vitormhenrique/hexapod/firmware/openrb150/README.md

# OpenRB-150 Hexapod Firmware

Deterministic safety + motion controller for the hexapod, running on a ROBOTIS
**OpenRB-150** (Microchip SAMD21G18A, Cortex-M0+ @ 48 MHz, 256 KB flash,
32 KB SRAM). Built with **PlatformIO**.

> Before touching DYNAMIXEL / Serial3 / DXL-power code, read
> [doc/mkrzero-vs-openrb150.md](doc/mkrzero-vs-openrb150.md). This repo ships a
> custom OpenRB-150 board + variant so peripheral pins map to the real hardware.

## Build environments

| Env | Board | Use |
| --- | --- | --- |
| `openrb150` (default) | custom `boards/openrb150.json` + `variants/OpenRB-150` | **All real firmware work.** Correct pin map: `Serial1`=DXL bus, `Serial3`=CRSF on D14 TX / D13 RX, DXL power FET, LEDs, battery ADC. |
| `openrb150_hil_output_disabled` | custom `boards/openrb150.json` + `variants/OpenRB-150` | Explicit ATSAMD21 HIL image. It runs the normal tasks but compile-time guards block DXL power-on, torque-on, Sync Write goals, and raw DXL writes. `GET_CAPABILITIES`, `GET_STATUS`, `health`, and `hil_status` expose the guard state. Never use it for actuator tests. |
| `mkrzero` | stock MKR Zero | Toolchain-only fallback. WRONG serial / DXL-power pins. |
| `native` | host (no board) | **Host unit tests only.** Builds the portable `src/` logic (protocol, IK, gait, config, safety) against Unity on the host; run with `pio test -e native`. |

## Commands

```bash
# Build (default env = openrb150)
pio run

# Local check: compile both target envs to confirm toolchain + variant are healthy
pio run -e openrb150 -e mkrzero

# Build the immutable output-disabled HIL image (do not use for motion tests)
pio run -e openrb150_hil_output_disabled

# Flash it, then run the board-side output guard smoke sequence from companion/
pio run -e openrb150_hil_output_disabled -t upload
cd ../../companion && uv run python ../tools/hil_smoke.py --port <PORT> --hil-output-disabled

# Run host unit tests (Unity, no hardware)
pio test -e native

# Flash the OpenRB-150 over USB
pio run -e openrb150 -t upload

# Serial monitor (USB CDC, 115200)
pio device monitor -b 115200
```

If `pio` is not on PATH, use the bundled binary: `~/.platformio/penv/bin/pio`.

### Portable CMake target

The firmware directory also exports `hexapod::controller_portable`, a
host-only static library for the Arduino-free controller, gait, IK, config,
protocol, contact, and safety layers. It is intended for native regression
tests and future ROS 2 packages; it does not build `main.cpp`, FreeRTOS task
orchestration, DXL bus I/O, the physical I2C drivers, or board GPIO.

From `firmware/openrb150`, configure, build, and run the standalone smoke test
with any host CMake 3.16+ toolchain:

```bash
cmake -S . -B build/portable -G Ninja
cmake --build build/portable
ctest --test-dir build/portable --output-on-failure
```

On this repository's RoboStack workstation setup, use the project-local Pixi
toolchain instead of installing CMake globally:

```bash
pixi run -e jazzy --manifest-path ../../robot_ros_simulation/pixi.toml \
  cmake -S . -B build/portable -G Ninja
pixi run -e jazzy --manifest-path ../../robot_ros_simulation/pixi.toml \
  cmake --build build/portable
pixi run -e jazzy --manifest-path ../../robot_ros_simulation/pixi.toml \
  ctest --test-dir build/portable --output-on-failure
```

The CMake and PlatformIO-native builds use the same policy: compile all files
under `src/` except the explicit hardware-owned entry, RTOS, board, DXL, I2C,
and OpenLog/OLED adapters. A portable source that starts depending on Arduino or
other hardware libraries should fail host compilation rather than being
silently omitted.

### Upload troubleshooting

- If upload does not catch the port, **double-tap the RESET button** to force the
  SAMD21 bootloader, then re-run upload.
- Resetting the MCU momentarily cuts DXL power — only reset when actuators are in
  a mechanically safe position.

## Safety-first boot behavior

- The DYNAMIXEL power FET (`BDPIN_DXL_PWR_EN`, pin 31) is held **OFF at boot**.
  Servos are unpowered until firmware explicitly arms them.
- Logic is 3.3 V and **not 5 V tolerant**. Do not run servos from USB power.
- If Qwiic OpenLog and its SD card are ready but `CONFIG.TXT` is absent or
  empty, firmware writes and verifies the complete compiled default config as
  the first journal record. A non-empty invalid prefix is not overwritten;
  firmware appends and verifies a complete default recovery record after it.

### Default stand pose

With the default (zero-trim) calibration, a planted stand commands every servo
to the MX-28 centre (`2048` / 180 deg). The mechanical build is designed so
that all-centre IS the home pose: coxa at the middle, femur slightly up, tibia
perpendicular to the floor. A walking gait selected with centred gimbals holds
this same planted pose; it does not advance gait phase or lift feet. Per-servo
`trim_ticks` are reserved for measured hardware calibration deltas only --
never for posing.

The final part of swing places the foot horizontally first and then descends
vertically with zero touchdown velocity. Tibia pitch is not independently
controllable because the 3-DOF leg uses coxa yaw plus a two-link point-foot IK;
the calibrated home geometry supplies the near-perpendicular contact posture.

## Layout

```text
firmware/openrb150/
  platformio.ini            PlatformIO config (openrb150 + mkrzero + native envs)
  boards/openrb150.json     custom board definition
  variants/OpenRB-150/      exact OpenRB-150 pin map + linker scripts
  doc/                      board notes (read mkrzero-vs-openrb150.md)
  src/
    main.cpp                entry point: board init + RTOS task launch
    app/                    FreeRTOS task setup + scheduling (control/dxl/rc/api/i2c/health)
    board/                  board pin map + HAL, safe boot, battery ADC scaling
    config/                 Qwiic OpenLog driver, append config journal, schema, config API
    dxl/                    DYNAMIXEL bus, model/table detection, sync write, params, servo map
    gait/                   leg IK, body IK, gait engine, full gait pipeline
    input/                  CRSF (ExpressLRS) parser + channel normalization
    protocol/               USB API: COBS/CRC framing, frame reader, dispatch, per-group handlers, telemetry
    logging/                portable remote/DYNAMIXEL capture CSV formatting
    safety/                 safety state machine, watchdog, command arbiter, system state
    sensors/                I2C topology, mux/contact sensors, optional debug OLED
  test/                     host Unity unit tests (one dir per module, built by the `native` env)
```

The 1.3 inch OLED driver is SparkFun's official `Qwiic1in3OLED`, pinned to
SparkFun_Qwiic_OLED_Arduino_Library `v1.0.13`. Later releases currently compile
an unrelated CH1120 debug path that uses `Serial.printf`, which is unavailable
in the OpenRB SAMD21 core. Two detailed pages use the bundled 5x7 font and
rotate every 10 seconds to show complete health, motion, tuning, and capture
status; only one dirty text row is sent per `i2cTask` pass.

## Intentionally not implemented (`#NOTIMPLEMENTED`)

These enhancements were raised by the 2026-06-29 Phase 1/2 audit
([docs/firmware_phase2_beads_audit_2026-06-29.md](../../docs/firmware_phase2_beads_audit_2026-06-29.md))
but are deliberately **not** on the backlog. They are micro-optimizations or
cleanups that are not required for a safe, working robot at this stage. Revisit
only if a profiler or hardware-in-loop run proves a concrete need.

- `#NOTIMPLEMENTED` **Precomputed servo lookup tables** (audit 22l.3). `ServoMap::servoFor()`/
  `servoForId()` linearly scan all servos. With only 18 servos the scan cost is
  negligible; a cached slot/id map adds state to maintain for no measurable gain.
- `#NOTIMPLEMENTED` **Coherent-snapshot / sequence guards on multi-field telemetry** (audit 22l.9).
  `buildTelemetry()` reads `g_servoStatus` while `dxlTask` writes it. A torn record
  is cosmetic for bring-up telemetry. Add a copy/sequence guard only if an HIL run
  shows visibly torn snapshots.
- `#NOTIMPLEMENTED` **Consolidate/remove the unused `CommandArbiter` Mac-lock path** (audit 22l.8).
  `MaintenanceApi` is the single source of truth for the maintenance lock; the
  dormant `CommandArbiter` Mac-lock methods are harmless dead code. Leave them
  until a broader arbiter refactor, rather than churning safety code for cleanup.

> Bench / hardware-in-loop sign-off (audit 22l.11) is tracked separately and is
> **deferred, not rejected** — it is pending hardware, not a non-goal.

See the repo-root `AGENTS.md` for the full architecture, safety rules, and phase
plan. Work is tracked in Beads (`bd ready`), not markdown TODOs.
