vitormhenrique/hexapod/robot_ros_simulation/debug/extraction_report.md

# Extraction Report: HexNav

**Exported:** 2026-06-24T12:20:51.967726
**Exporter:** v3.0.0

## Summary

| Metric | Value |
|---|---|
| Occurrences | 38 |
| Subassemblies | 0 |
| Leaf components | 38 |
| Joints (total) | 37 |
| As-built joints | 0 |
| Regular joints | 37 |
| Max nesting depth | 0 |

## Assembly Hierarchy

```
[HexNav]  (design root)
  ├── bot  (241.3g)
  ├── leg_1_coxa  (193.0g)
  ├── leg_1_femur  (127.0g)
  ├── leg_1_mx28_coxa  (73.9g)
  ├── leg_1_mx28_femur  (73.9g)
  ├── leg_1_mx28_tibia  (73.9g)
  ├── leg_1_tibia  (155.0g)
  ├── leg_2_coxa  (193.0g)
  ├── leg_2_femur  (127.0g)
  ├── leg_2_mx28_coxa  (73.9g)
  ├── leg_2_mx28_femur  (73.9g)
  ├── leg_2_mx28_tibia  (73.9g)
  ├── leg_2_tibia  (155.0g)
  ├── leg_3_coxa  (193.0g)
  ├── leg_3_femur  (127.0g)
  ├── leg_3_mx28_coxa  (73.9g)
  ├── leg_3_mx28_femur  (73.9g)
  ├── leg_3_mx28_tibia  (73.9g)
  ├── leg_3_tibia  (155.0g)
  ├── leg_4_coxa  (193.0g)
  ├── leg_4_femur  (127.0g)
  ├── leg_4_mx28_coxa  (73.9g)
  ├── leg_4_mx28_femur  (73.9g)
  ├── leg_4_mx28_tibia  (73.9g)
  ├── leg_4_tibia  (155.0g)
  ├── leg_5_coxa  (193.0g)
  ├── leg_5_femur  (127.0g)
  ├── leg_5_mx28_coxa  (73.9g)
  ├── leg_5_mx28_femur  (73.9g)
  ├── leg_5_mx28_tibia  (73.9g)
  ├── leg_5_tibia  (155.0g)
  ├── leg_6_coxa  (193.0g)
  ├── leg_6_femur  (127.0g)
  ├── leg_6_mx28_coxa  (73.9g)
  ├── leg_6_mx28_femur  (73.9g)
  ├── leg_6_mx28_tibia  (73.9g)
  ├── leg_6_tibia  (155.0g)
  ├── top  (241.3g)
```

## Occurrences

### Depth 0

#### 🔧 COMPONENT: `bot`

| Property | Value |
|---|---|
| Full path | `bot:1` |
| Component name | bot |
| Depth | 0 |
| Path segments | bot |
| **Transforms** | |
| Global position (m) | (0.076463, -0.126463, -0.033000) |
| Global position (mm) | (76.46, -126.46, -33.00) |
| Local transform (m) | (0.076463, -0.126463, -0.033000) |
| Assembly context depth | 0 |
| transform2 (m) | (0.076463, -0.126463, -0.033000) |
| **Physical** | |
| Mass | 0.241313 kg (241.313 g) |
| Volume | 3.074045e-05 m³ |
| Density | 7850.0 kg/m³ |
| Surface area | 2.989702e-02 m² |
| Body count | 1 |
| CoM (component-local, m) | (0.076463, 0.126463, 0.001407) |
| CoM (global, m) | (0.152927, 0.000000, -0.031593) |
| CoM (global, mm) | (152.93, 0.00, -31.59) |
| **Inertia at origin (kg·m²)** | |
| Ixx, Iyy, Izz | 5.117542e-03, 1.803530e-03, 6.919758e-03 |
| Ixy, Ixz, Iyz | -2.333454e-03, -2.596731e-05, -4.294751e-05 |
| **Inertia at CoM (kg·m²)** | |
| Ixx, Iyy, Izz | 1.257749e-03, 3.921782e-04, 1.649569e-03 |
| Ixy, Ixz, Iyz | -1.134942e-10, 4.004551e-12, 6.945432e-12 |
| Bounding box (m) | 0.1529 × 0.2529 × 0.0030 |
| Bounding box (mm) | 152.91 × 252.91 × 3.00 |
| **Material & Appearance** | |
| Material | Steel |
| Appearance | Steel_Satin |
| Color (RGB 0-1) | (0.627, 0.627, 0.627) |
| Color (RGB 0-255) | (160, 160, 160) |

#### 🔧 COMPONENT: `leg_1_coxa`

| Property | Value |
|---|---|
| Full path | `leg_1_coxa:1` |
| Component name | leg_1_coxa |
| Depth | 0 |
| Path segments | leg_1_coxa |
| **Transforms** | |
| Global position (m) | (-0.102347, -0.152347, -0.018000) |
| Global position (mm) | (-102.35, -152.35, -18.00) |
| Local transform (m) | (-0.102347, -0.152347, -0.018000) |
| Assembly context depth | 0 |
| transform2 (m) | (-0.102347, -0.152347, -0.018000) |
| **Physical** | |
| Mass | 0.192968 kg (192.968 g) |
| Volume | 2.458186e-05 m³ |
| Density | 7850.0 kg/m³ |
| Surface area | 1.384356e-02 m² |
| Body count | 1 |
| CoM (component-local, m) | (-0.026008, 0.000000, -0.000000) |
| CoM (global, m) | (-0.128355, -0.152346, -0.018000) |
| CoM (global, mm) | (-128.35, -152.35, -18.00) |
| **Inertia at origin (kg·m²)** | |
| Ixx, Iyy, Izz | 8.738331e-05, 2.179312e-04, 2.203039e-04 |
| Ixy, Ixz, Iyz | 1.133249e-09, -1.180732e-09, 1.075058e-10 |
| **Inertia at CoM (kg·m²)** | |
| Ixx, Iyy, Izz | 8.738331e-05, 8.740064e-05, 8.977332e-05 |
| Ixy, Ixz, Iyz | 2.081866e-10, -4.006872e-10, 1.075002e-10 |
| Bounding box (m) | 0.0790 × 0.0480 × 0.0480 |
| Bounding box (mm) | 79.00 × 48.00 × 48.00 |
| **Material & Appearance** | |
| Material | Steel |
| Appearance | Opaque_255_255_255 |
| Color (RGB 0-1) | (1.000, 1.000, 1.000) |
| Color (RGB 0-255) | (255, 255, 255) |

#### 🔧 COMPONENT: `leg_1_femur`

| Property | Value |
|---|---|
| Full path | `leg_1_femur:1` |
| Component name | leg_1_femur |
| Depth | 0 |
| Path segments | leg_1_femur |
| **Transforms** | |
| Global position (m) | (-0.127661, -0.177661, -0.018000) |
| Global position (mm) | (-127.66, -177.66, -18.00) |
| Local transform (m) | (-0.127661, -0.177661, -0.018000) |
| Assembly context depth | 0 |
| transform2 (m) | (-0.127661, -0.177661, -0.018000) |
| **Physical** | |
| Mass | 0.127034 kg (127.034 g) |
| Volume | 1.618264e-05 m³ |
| Density | 7850.0 kg/m³ |
| Surface area | 9.524369e-03 m² |
| Body count | 1 |
| CoM (component-local, m) | (0.002213, 0.011329, -0.000000) |
| CoM (global, m) | (-0.125448, -0.166332, -0.018000) |
| CoM (global, mm) | (-125.45, -166.33, -18.00) |
| **Inertia at origin (kg·m²)** | |
| Ixx, Iyy, Izz | 6.551941e-05, 5.196798e-05, 4.448854e-05 |
| Ixy, Ixz, Iyz | -8.253525e-06, 6.684992e-12, -3.715345e-11 |
| **Inertia at CoM (kg·m²)** | |
| Ixx, Iyy, Izz | 4.921450e-05, 5.134561e-05, 2.756126e-05 |
| Ixy, Ixz, Iyz | -5.067980e-06, -4.447828e-11, -2.990278e-10 |
| Bounding box (m) | 0.0448 × 0.0463 × 0.0480 |
| Bounding box (mm) | 44.80 × 46.30 × 48.00 |
| **Material & Appearance** | |
| Material | Steel |
| Appearance | Opaque_255_255_255 |
| Color (RGB 0-1) | (1.000, 1.000, 1.000) |
| Color (RGB 0-255) | (255, 255, 255) |

#### 🔧 COMPONENT: `leg_1_mx28_coxa`

| Property | Value |
|---|---|
| Full path | `leg_1_mx28_coxa:1` |
| Component name | leg_1_mx28_coxa |
| Depth | 0 |
| Path segments | leg_1_mx28_coxa |
| **Transforms** | |
| Global position (m) | (-0.065577, -0.115577, -0.018000) |
| Global position (mm) | (-65.58, -115.58, -18.00) |
| Local transform (m) | (-0.065577, -0.115577, -0.018000) |
| Assembly context depth | 0 |
| transform2 (m) | (-0.065577, -0.115577, -0.018000) |
| **Physical** | |
| Mass | 0.073932 kg (73.932 g) |
| Volume | 4.443055e-05 m³ |
| Density | 1664.0 kg/m³ |
| Surface area | 1.141476e-02 m² |
| Body count | 1 |
| CoM (component-local, m) | (0.000000, -0.011210, 0.000488) |
| CoM (global, m) | (-0.065577, -0.126787, -0.017512) |
| CoM (global, mm) | (-65.58, -126.79, -17.51) |
| **Inertia at origin (kg·m²)** | |
| Ixx, Iyy, Izz | 3.064312e-05, 1.326921e-05, 2.684786e-05 |
| Ixy, Ixz, Iyz | 8.383364e-10, -6.769801e-11, -3.310929e-07 |
| **Inertia at CoM (kg·m²)** | |
| Ixx, Iyy, Izz | 2.133552e-05, 1.325162e-05, 1.755785e-05 |
| Ixy, Ixz, Iyz | 4.901953e-10, -5.255020e-11, -7.353064e-07 |
| Bounding box (m) | 0.0356 × 0.0506 × 0.0431 |
| Bounding box (mm) | 35.60 × 50.60 × 43.10 |
| **Material & Appearance** | |
| Material | custom_materials_MX_28 |
| Appearance | Opaque_255_255_255 |
| Color (RGB 0-1) | (1.000, 1.000, 1.000) |
| Color (RGB 0-255) | (255, 255, 255) |

#### 🔧 COMPONENT: `leg_1_mx28_femur`

| Property | Value |
|---|---|
| Full path | `leg_1_mx28_femur:1` |
| Component name | leg_1_mx28_femur |
| Depth | 0 |
| Path segments | leg_1_mx28_femur |
| **Transforms** | |
| Global position (m) | (-0.102347, -0.152347, -0.018000) |
| Global position (mm) | (-102.35, -152.35, -18.00) |
| Local transform (m) | (-0.102347, -0.152347, -0.018000) |
| Assembly context depth | 0 |
| transform2 (m) | (-0.102347, -0.152347, -0.018000) |
| **Physical** | |
| Mass | 0.073932 kg (73.932 g) |
| Volume | 4.443055e-05 m³ |
| Density | 1664.0 kg/m³ |
| Surface area | 1.141476e-02 m² |
| Body count | 1 |
| CoM (component-local, m) | (0.000000, -0.011210, 0.000488) |
| CoM (global, m) | (-0.102346, -0.163556, -0.017512) |
| CoM (global, mm) | (-102.35, -163.56, -17.51) |
| **Inertia at origin (kg·m²)** | |
| Ixx, Iyy, Izz | 3.064312e-05, 1.326921e-05, 2.684786e-05 |
| Ixy, Ixz, Iyz | 8.383364e-10, -6.769801e-11, -3.310929e-07 |
| **Inertia at CoM (kg·m²)** | |
| Ixx, Iyy, Izz | 2.133552e-05, 1.325162e-05, 1.755785e-05 |
| Ixy, Ixz, Iyz | 4.901953e-10, -5.255020e-11, -7.353064e-07 |
| Bounding box (m) | 0.0356 × 0.0506 × 0.0431 |
| Bounding box (mm) | 35.60 × 50.60 × 43.10 |
| **Material & Appearance** | |
| Material | custom_materials_MX_28 |
| Appearance | Opaque_255_255_255 |
| Color (RGB 0-1) | (1.000, 1.000, 1.000) |
| Color (RGB 0-255) | (255, 255, 255) |

#### 🔧 COMPONENT: `leg_1_mx28_tibia`

| Property | Value |
|---|---|
| Full path | `leg_1_mx28_tibia:1` |
| Component name | leg_1_mx28_tibia |
| Depth | 0 |
| Path segments | leg_1_mx28_tibia |
| **Transforms** | |
| Global position (m) | (-0.148167, -0.198167, -0.033000) |
| Global position (mm) | (-148.17, -198.17, -33.00) |
| Local transform (m) | (-0.148167, -0.198167, -0.033000) |
| Assembly context depth | 0 |
| transform2 (m) | (-0.148167, -0.198167, -0.033000) |
| **Physical** | |
| Mass | 0.073932 kg (73.932 g) |
| Volume | 4.443055e-05 m³ |
| Density | 1664.0 kg/m³ |
| Surface area | 1.141476e-02 m² |
| Body count | 1 |
| CoM (component-local, m) | (0.000000, -0.011210, 0.000488) |
| CoM (global, m) | (-0.148167, -0.209377, -0.032512) |
| CoM (global, mm) | (-148.17, -209.38, -32.51) |
| **Inertia at origin (kg·m²)** | |
| Ixx, Iyy, Izz | 3.064312e-05, 1.326921e-05, 2.684786e-05 |
| Ixy, Ixz, Iyz | 8.383364e-10, -6.769801e-11, -3.310929e-07 |
| **Inertia at CoM (kg·m²)** | |
| Ixx, Iyy, Izz | 2.133552e-05, 1.325162e-05, 1.755785e-05 |
| Ixy, Ixz, Iyz | 4.901953e-10, -5.255020e-11, -7.353064e-07 |
| Bounding box (m) | 0.0356 × 0.0506 × 0.0431 |
| Bounding box (mm) | 35.60 × 50.60 × 43.10 |
| **Material & Appearance** | |
| Material | custom_materials_MX_28 |
| Appearance | Opaque_255_255_255 |
| Color (RGB 0-1) | (1.000, 1.000, 1.000) |
| Color (RGB 0-255) | (255, 255, 255) |

#### 🔧 COMPONENT: `leg_1_tibia`

| Property | Value |
|---|---|
| Full path | `leg_1_tibia:1` |
| Component name | leg_1_tibia |
| Depth | 0 |
| Path segments | leg_1_tibia |
| **Transforms** | |
| Global position (m) | (-0.155371, -0.205371, -0.041549) |
| Global position (mm) | (-155.37, -205.37, -41.55) |
| Local transform (m) | (-0.155371, -0.205371, -0.041549) |
| Assembly context depth | 0 |
| transform2 (m) | (-0.155371, -0.205371, -0.041549) |
| **Physical** | |
| Mass | 0.154962 kg (154.962 g) |
| Volume | 1.974040e-05 m³ |
| Density | 7850.0 kg/m³ |
| Surface area | 1.394610e-02 m² |
| Body count | 1 |
| CoM (component-local, m) | (-0.049791, -0.043459, 0.000001) |
| CoM (global, m) | (-0.205162, -0.248831, -0.041548) |
| CoM (global, mm) | (-205.16, -248.83, -41.55) |
| **Inertia at origin (kg·m²)** | |
| Ixx, Iyy, Izz | 4.970029e-04, 4.704043e-04, 9.071190e-04 |
| Ixy, Ixz, Iyz | -4.149918e-04, 3.784732e-09, 5.051465e-11 |
| **Inertia at CoM (kg·m²)** | |
| Ixx, Iyy, Izz | 2.043255e-04, 8.623421e-05, 2.302716e-04 |
| Ixy, Ixz, Iyz | -7.967425e-05, -5.645496e-09, -8.180530e-09 |
| Bounding box (m) | 0.0841 × 0.1047 × 0.0360 |
| Bounding box (mm) | 84.07 × 104.69 × 36.00 |
| **Material & Appearance** | |
| Material | Steel |
| Appearance | Opaque_255_255_255 |
| Color (RGB 0-1) | (1.000, 1.000, 1.000) |
| Color (RGB 0-255) | (255, 255, 255) |

#### 🔧 COMPONENT: `leg_2_coxa`

| Property | Value |
|---|---|
| Full path | `leg_2_coxa:1` |
| Component name | leg_2_coxa |
| Depth | 0 |
| Path segments | leg_2_coxa |
| **Transforms** | |
| Global position (m) | (0.102347, -0.152347, -0.018000) |
| Global position (mm) | (102.35, -152.35, -18.00) |
| Local transform (m) | (0.102347, -0.152347, -0.018000) |
| Assembly context depth | 0 |
| transform2 (m) | (0.102347, -0.152347, -0.018000) |
| **Physical** | |
| Mass | 0.192968 kg (192.968 g) |
| Volume | 2.458186e-05 m³ |
| Density | 7850.0 kg/m³ |
| Surface area | 1.384356e-02 m² |
| Body count | 1 |
| CoM (component-local, m) | (-0.026008, 0.000000, -0.000000) |
| CoM (global, m) | (0.076338, -0.152346, -0.018000) |
| CoM (global, mm) | (76.34, -152.35, -18.00) |
| **Inertia at origin (kg·m²)** | |
| Ixx, Iyy, Izz | 8.738331e-05, 2.179312e-04, 2.203039e-04 |
| Ixy, Ixz, Iyz | 1.133249e-09, -1.180732e-09, 1.075058e-10 |
| **Inertia at CoM (kg·m²)** | |
| Ixx, Iyy, Izz | 8.738331e-05, 8.740064e-05, 8.977332e-05 |
| Ixy, Ixz, Iyz | 2.081866e-10, -4.006872e-10, 1.075002e-10 |
| Bounding box (m) | 0.0790 × 0.0480 × 0.0480 |
| Bounding box (mm) | 79.00 × 48.00 × 48.00 |
| **Material & Appearance** | |
| Material | Steel |
| Appearance | Opaque_255_255_255 |
| Color (RGB 0-1) | (1.000, 1.000, 1.000) |
| Color (RGB 0-255) | (255, 255, 255) |

#### 🔧 COMPONENT: `leg_2_femur`

| Property | Value |
|---|---|
| Full path | `leg_2_femur:1` |
| Component name | leg_2_femur |
| Depth | 0 |
| Path segments | leg_2_femur |
| **Transforms** | |
| Global position (m) | (0.127661, -0.177661, -0.018000) |
| Global position (mm) | (127.66, -177.66, -18.00) |
| Local transform (m) | (0.127661, -0.177661, -0.018000) |
| Assembly context depth | 0 |
| transform2 (m) | (0.127661, -0.177661, -0.018000) |
| **Physical** | |
| Mass | 0.127034 kg (127.034 g) |
| Volume | 1.618264e-05 m³ |
| Density | 7850.0 kg/m³ |
| Surface area | 9.524369e-03 m² |
| Body count | 1 |
| CoM (component-local, m) | (0.002213, 0.011329, -0.000000) |
| CoM (global, m) | (0.129874, -0.166332, -0.018000) |
| CoM (global, mm) | (129.87, -166.33, -18.00) |
| **Inertia at origin (kg·m²)** | |
| Ixx, Iyy, Izz | 6.551941e-05, 5.196798e-05, 4.448854e-05 |
| Ixy, Ixz, Iyz | -8.253525e-06, 6.684992e-12, -3.715345e-11 |
| **Inertia at CoM (kg·m²)** | |
| Ixx, Iyy, Izz | 4.921450e-05, 5.134561e-05, 2.756126e-05 |
| Ixy, Ixz, Iyz | -5.067980e-06, -4.447828e-11, -2.990278e-10 |
| Bounding box (m) | 0.0448 × 0.0463 × 0.0480 |
| Bounding box (mm) | 44.80 × 46.30 × 48.00 |
| **Material & Appearance** | |
| Material | Steel |
| Appearance | Opaque_255_255_255 |
| Color (RGB 0-1) | (1.000, 1.000, 1.000) |
| Color (RGB 0-255) | (255, 255, 255) |

#### 🔧 COMPONENT: `leg_2_mx28_coxa`

| Property | Value |
|---|---|
| Full path | `leg_2_mx28_coxa:1` |
| Component name | leg_2_mx28_coxa |
| Depth | 0 |
| Path segments | leg_2_mx28_coxa |
| **Transforms** | |
| Global position (m) | (0.065577, -0.115577, -0.018000) |
| Global position (mm) | (65.58, -115.58, -18.00) |
| Local transform (m) | (0.065577, -0.115577, -0.018000) |
| Assembly context depth | 0 |
| transform2 (m) | (0.065577, -0.115577, -0.018000) |
| **Physical** | |
| Mass | 0.073932 kg (73.932 g) |
| Volume | 4.443055e-05 m³ |
| Density | 1664.0 kg/m³ |
| Surface area | 1.141476e-02 m² |
| Body count | 1 |
| CoM (component-local, m) | (0.000000, -0.011210, 0.000488) |
| CoM (global, m) | (0.065577, -0.126787, -0.017512) |
| CoM (global, mm) | (65.58, -126.79, -17.51) |
| **Inertia at origin (kg·m²)** | |
| Ixx, Iyy, Izz | 3.064312e-05, 1.326921e-05, 2.684786e-05 |
| Ixy, Ixz, Iyz | 8.383364e-10, -6.769801e-11, -3.310929e-07 |
| **Inertia at CoM (kg·m²)** | |
| Ixx, Iyy, Izz | 2.133552e-05, 1.325162e-05, 1.755785e-05 |
| Ixy, Ixz, Iyz | 4.901953e-10, -5.255020e-11, -7.353064e-07 |
| Bounding box (m) | 0.0356 × 0.0506 × 0.0431 |
| Bounding box (mm) | 35.60 × 50.60 × 43.10 |
| **Material & Appearance** | |
| Material | custom_materials_MX_28 |
| Appearance | Opaque_255_255_255 |
| Color (RGB 0-1) | (1.000, 1.000, 1.000) |
| Color (RGB 0-255) | (255, 255, 255) |

#### 🔧 COMPONENT: `leg_2_mx28_femur`

| Property | Value |
|---|---|
| Full path | `leg_2_mx28_femur:1` |
| Component name | leg_2_mx28_femur |
| Depth | 0 |
| Path segments | leg_2_mx28_femur |
| **Transforms** | |
| Global position (m) | (0.102347, -0.152347, -0.018000) |
| Global position (mm) | (102.35, -152.35, -18.00) |
| Local transform (m) | (0.102347, -0.152347, -0.018000) |
| Assembly context depth | 0 |
| transform2 (m) | (0.102347, -0.152347, -0.018000) |
| **Physical** | |
| Mass | 0.073932 kg (73.932 g) |
| Volume | 4.443055e-05 m³ |
| Density | 1664.0 kg/m³ |
| Surface area | 1.141476e-02 m² |
| Body count | 1 |
| CoM (component-local, m) | (0.000000, -0.011210, 0.000488) |
| CoM (global, m) | (0.102347, -0.163556, -0.017512) |
| CoM (global, mm) | (102.35, -163.56, -17.51) |
| **Inertia at origin (kg·m²)** | |
| Ixx, Iyy, Izz | 3.064312e-05, 1.326921e-05, 2.684786e-05 |
| Ixy, Ixz, Iyz | 8.383364e-10, -6.769801e-11, -3.310929e-07 |
| **Inertia at CoM (kg·m²)** | |
| Ixx, Iyy, Izz | 2.133552e-05, 1.325162e-05, 1.755785e-05 |
| Ixy, Ixz, Iyz | 4.901953e-10, -5.255020e-11, -7.353064e-07 |
| Bounding box (m) | 0.0356 × 0.0506 × 0.0431 |
| Bounding box (mm) | 35.60 × 50.60 × 43.10 |
| **Material & Appearance** | |
| Material | custom_materials_MX_28 |
| Appearance | Opaque_255_255_255 |
| Color (RGB 0-1) | (1.000, 1.000, 1.000) |
| Color (RGB 0-255) | (255, 255, 255) |

#### 🔧 COMPONENT: `leg_2_mx28_tibia`

| Property | Value |
|---|---|
| Full path | `leg_2_mx28_tibia:1` |
| Component name | leg_2_mx28_tibia |
| Depth | 0 |
| Path segments | leg_2_mx28_tibia |
| **Transforms** | |
| Global position (m) | (0.148167, -0.198167, -0.033000) |
| Global position (mm) | (148.17, -198.17, -33.00) |
| Local transform (m) | (0.148167, -0.198167, -0.033000) |
| Assembly context depth | 0 |
| transform2 (m) | (0.148167, -0.198167, -0.033000) |
| **Physical** | |
| Mass | 0.073932 kg (73.932 g) |
| Volume | 4.443055e-05 m³ |
| Density | 1664.0 kg/m³ |
| Surface area | 1.141476e-02 m² |
| Body count | 1 |
| CoM (component-local, m) | (0.000000, -0.011210, 0.000488) |
| CoM (global, m) | (0.148167, -0.209377, -0.032512) |
| CoM (global, mm) | (148.17, -209.38, -32.51) |
| **Inertia at origin (kg·m²)** | |
| Ixx, Iyy, Izz | 3.064312e-05, 1.326921e-05, 2.684786e-05 |
| Ixy, Ixz, Iyz | 8.383364e-10, -6.769801e-11, -3.310929e-07 |
| **Inertia at CoM (kg·m²)** | |
| Ixx, Iyy, Izz | 2.133552e-05, 1.325162e-05, 1.755785e-05 |
| Ixy, Ixz, Iyz | 4.901953e-10, -5.255020e-11, -7.353064e-07 |
| Bounding box (m) | 0.0356 × 0.0506 × 0.0431 |
| Bounding box (mm) | 35.60 × 50.60 × 43.10 |
| **Material & Appearance** | |
| Material | custom_materials_MX_28 |
| Appearance | Opaque_255_255_255 |
| Color (RGB 0-1) | (1.000, 1.000, 1.000) |
| Color (RGB 0-255) | (255, 255, 255) |

#### 🔧 COMPONENT: `leg_2_tibia`

| Property | Value |
|---|---|
| Full path | `leg_2_tibia:1` |
| Component name | leg_2_tibia |
| Depth | 0 |
| Path segments | leg_2_tibia |
| **Transforms** | |
| Global position (m) | (0.155371, -0.205371, -0.041549) |
| Global position (mm) | (155.37, -205.37, -41.55) |
| Local transform (m) | (0.155371, -0.205371, -0.041549) |
| Assembly context depth | 0 |
| transform2 (m) | (0.155371, -0.205371, -0.041549) |
| **Physical** | |
| Mass | 0.154962 kg (154.962 g) |
| Volume | 1.974040e-05 m³ |
| Density | 7850.0 kg/m³ |
| Surface area | 1.394610e-02 m² |
| Body count | 1 |
| CoM (component-local, m) | (-0.049791, -0.043459, 0.000001) |
| CoM (global, m) | (0.105581, -0.248831, -0.041548) |
| CoM (global, mm) | (105.58, -248.83, -41.55) |
| **Inertia at origin (kg·m²)** | |
| Ixx, Iyy, Izz | 4.970029e-04, 4.704043e-04, 9.071190e-04 |
| Ixy, Ixz, Iyz | -4.149918e-04, 3.784732e-09, 5.051465e-11 |
| **Inertia at CoM (kg·m²)** | |
| Ixx, Iyy, Izz | 2.043255e-04, 8.623421e-05, 2.302716e-04 |
| Ixy, Ixz, Iyz | -7.967425e-05, -5.645496e-09, -8.180530e-09 |
| Bounding box (m) | 0.0841 × 0.1047 × 0.0360 |
| Bounding box (mm) | 84.07 × 104.69 × 36.00 |
| **Material & Appearance** | |
| Material | Steel |
| Appearance | Opaque_255_255_255 |
| Color (RGB 0-1) | (1.000, 1.000, 1.000) |
| Color (RGB 0-255) | (255, 255, 255) |

#### 🔧 COMPONENT: `leg_3_coxa`

| Property | Value |
|---|---|
| Full path | `leg_3_coxa:1` |
| Component name | leg_3_coxa |
| Depth | 0 |
| Path segments | leg_3_coxa |
| **Transforms** | |
| Global position (m) | (0.121780, -0.000000, -0.018000) |
| Global position (mm) | (121.78, -0.00, -18.00) |
| Local transform (m) | (0.121780, -0.000000, -0.018000) |
| Assembly context depth | 0 |
| transform2 (m) | (0.121780, -0.000000, -0.018000) |
| **Physical** | |
| Mass | 0.192968 kg (192.968 g) |
| Volume | 2.458186e-05 m³ |
| Density | 7850.0 kg/m³ |
| Surface area | 1.384356e-02 m² |
| Body count | 1 |
| CoM (component-local, m) | (-0.026008, 0.000000, -0.000000) |
| CoM (global, m) | (0.095772, 0.000000, -0.018000) |
| CoM (global, mm) | (95.77, 0.00, -18.00) |
| **Inertia at origin (kg·m²)** | |
| Ixx, Iyy, Izz | 8.738331e-05, 2.179312e-04, 2.203039e-04 |
| Ixy, Ixz, Iyz | 1.133249e-09, -1.180732e-09, 1.075058e-10 |
| **Inertia at CoM (kg·m²)** | |
| Ixx, Iyy, Izz | 8.738331e-05, 8.740064e-05, 8.977332e-05 |
| Ixy, Ixz, Iyz | 2.081866e-10, -4.006872e-10, 1.075002e-10 |
| Bounding box (m) | 0.0790 × 0.0480 × 0.0480 |
| Bounding box (mm) | 79.00 × 48.00 × 48.00 |
| **Material & Appearance** | |
| Material | Steel |
| Appearance | Opaque_255_255_255 |
| Color (RGB 0-1) | (1.000, 1.000, 1.000) |
| Color (RGB 0-255) | (255, 255, 255) |

#### 🔧 COMPONENT: `leg_3_femur`

| Property | Value |
|---|---|
| Full path | `leg_3_femur:1` |
| Component name | leg_3_femur |
| Depth | 0 |
| Path segments | leg_3_femur |
| **Transforms** | |
| Global position (m) | (0.157580, -0.000000, -0.018000) |
| Global position (mm) | (157.58, -0.00, -18.00) |
| Local transform (m) | (0.157580, -0.000000, -0.018000) |
| Assembly context depth | 0 |
| transform2 (m) | (0.157580, -0.000000, -0.018000) |
| **Physical** | |
| Mass | 0.127034 kg (127.034 g) |
| Volume | 1.618264e-05 m³ |
| Density | 7850.0 kg/m³ |
| Surface area | 9.524369e-03 m² |
| Body count | 1 |
| CoM (component-local, m) | (0.002213, 0.011329, -0.000000) |
| CoM (global, m) | (0.159793, 0.011329, -0.018000) |
| CoM (global, mm) | (159.79, 11.33, -18.00) |
| **Inertia at origin (kg·m²)** | |
| Ixx, Iyy, Izz | 6.551941e-05, 5.196798e-05, 4.448854e-05 |
| Ixy, Ixz, Iyz | -8.253525e-06, 6.684992e-12, -3.715345e-11 |
| **Inertia at CoM (kg·m²)** | |
| Ixx, Iyy, Izz | 4.921450e-05, 5.134561e-05, 2.756126e-05 |
| Ixy, Ixz, Iyz | -5.067980e-06, -4.447828e-11, -2.990278e-10 |
| Bounding box (m) | 0.0448 × 0.0463 × 0.0480 |
| Bounding box (mm) | 44.80 × 46.30 × 48.00 |
| **Material & Appearance** | |
| Material | Steel |
| Appearance | Opaque_255_255_255 |
| Color (RGB 0-1) | (1.000, 1.000, 1.000) |
| Color (RGB 0-255) | (255, 255, 255) |

#### 🔧 COMPONENT: `leg_3_mx28_coxa`

| Property | Value |
|---|---|
| Full path | `leg_3_mx28_coxa:1` |
| Component name | leg_3_mx28_coxa |
| Depth | 0 |
| Path segments | leg_3_mx28_coxa |
| **Transforms** | |
| Global position (m) | (0.069780, -0.000000, -0.018000) |
| Global position (mm) | (69.78, -0.00, -18.00) |
| Local transform (m) | (0.069780, -0.000000, -0.018000) |
| Assembly context depth | 0 |
| transform2 (m) | (0.069780, -0.000000, -0.018000) |
| **Physical** | |
| Mass | 0.073932 kg (73.932 g) |
| Volume | 4.443055e-05 m³ |
| Density | 1664.0 kg/m³ |
| Surface area | 1.141476e-02 m² |
| Body count | 1 |
| CoM (component-local, m) | (0.000000, -0.011210, 0.000488) |
| CoM (global, m) | (0.069780, -0.011210, -0.017512) |
| CoM (global, mm) | (69.78, -11.21, -17.51) |
| **Inertia at origin (kg·m²)** | |
| Ixx, Iyy, Izz | 3.064312e-05, 1.326921e-05, 2.684786e-05 |
| Ixy, Ixz, Iyz | 8.383364e-10, -6.769801e-11, -3.310929e-07 |
| **Inertia at CoM (kg·m²)** | |
| Ixx, Iyy, Izz | 2.133552e-05, 1.325162e-05, 1.755785e-05 |
| Ixy, Ixz, Iyz | 4.901953e-10, -5.255020e-11, -7.353064e-07 |
| Bounding box (m) | 0.0356 × 0.0506 × 0.0431 |
| Bounding box (mm) | 35.60 × 50.60 × 43.10 |
| **Material & Appearance** | |
| Material | custom_materials_MX_28 |
| Appearance | Opaque_255_255_255 |
| Color (RGB 0-1) | (1.000, 1.000, 1.000) |
| Color (RGB 0-255) | (255, 255, 255) |

#### 🔧 COMPONENT: `leg_3_mx28_femur`

| Property | Value |
|---|---|
| Full path | `leg_3_mx28_femur:1` |
| Component name | leg_3_mx28_femur |
| Depth | 0 |
| Path segments | leg_3_mx28_femur |
| **Transforms** | |
| Global position (m) | (0.121780, -0.000000, -0.018000) |
| Global position (mm) | (121.78, -0.00, -18.00) |
| Local transform (m) | (0.121780, -0.000000, -0.018000) |
| Assembly context depth | 0 |
| transform2 (m) | (0.121780, -0.000000, -0.018000) |
| **Physical** | |
| Mass | 0.073932 kg (73.932 g) |
| Volume | 4.443055e-05 m³ |
| Density | 1664.0 kg/m³ |
| Surface area | 1.141476e-02 m² |
| Body count | 1 |
| CoM (component-local, m) | (0.000000, -0.011210, 0.000488) |
| CoM (global, m) | (0.121780, -0.011210, -0.017512) |
| CoM (global, mm) | (121.78, -11.21, -17.51) |
| **Inertia at origin (kg·m²)** | |
| Ixx, Iyy, Izz | 3.064312e-05, 1.326921e-05, 2.684786e-05 |
| Ixy, Ixz, Iyz | 8.383364e-10, -6.769801e-11, -3.310929e-07 |
| **Inertia at CoM (kg·m²)** | |
| Ixx, Iyy, Izz | 2.133552e-05, 1.325162e-05, 1.755785e-05 |
| Ixy, Ixz, Iyz | 4.901953e-10, -5.255020e-11, -7.353064e-07 |
| Bounding box (m) | 0.0356 × 0.0506 × 0.0431 |
| Bounding box (mm) | 35.60 × 50.60 × 43.10 |
| **Material & Appearance** | |
| Material | custom_materials_MX_28 |
| Appearance | Opaque_255_255_255 |
| Color (RGB 0-1) | (1.000, 1.000, 1.000) |
| Color (RGB 0-255) | (255, 255, 255) |

#### 🔧 COMPONENT: `leg_3_mx28_tibia`

| Property | Value |
|---|---|
| Full path | `leg_3_mx28_tibia:1` |
| Component name | leg_3_mx28_tibia |
| Depth | 0 |
| Path segments | leg_3_mx28_tibia |
| **Transforms** | |
| Global position (m) | (0.186580, -0.000000, -0.033000) |
| Global position (mm) | (186.58, -0.00, -33.00) |
| Local transform (m) | (0.186580, -0.000000, -0.033000) |
| Assembly context depth | 0 |
| transform2 (m) | (0.186580, -0.000000, -0.033000) |
| **Physical** | |
| Mass | 0.073932 kg (73.932 g) |
| Volume | 4.443055e-05 m³ |
| Density | 1664.0 kg/m³ |
| Surface area | 1.141476e-02 m² |
| Body count | 1 |
| CoM (component-local, m) | (0.000000, -0.011210, 0.000488) |
| CoM (global, m) | (0.186580, -0.011210, -0.032512) |
| CoM (global, mm) | (186.58, -11.21, -32.51) |
| **Inertia at origin (kg·m²)** | |
| Ixx, Iyy, Izz | 3.064312e-05, 1.326921e-05, 2.684786e-05 |
| Ixy, Ixz, Iyz | 8.383364e-10, -6.769801e-11, -3.310929e-07 |
| **Inertia at CoM (kg·m²)** | |
| Ixx, Iyy, Izz | 2.133552e-05, 1.325162e-05, 1.755785e-05 |
| Ixy, Ixz, Iyz | 4.901953e-10, -5.255020e-11, -7.353064e-07 |
| Bounding box (m) | 0.0356 × 0.0506 × 0.0431 |
| Bounding box (mm) | 35.60 × 50.60 × 43.10 |
| **Material & Appearance** | |
| Material | custom_materials_MX_28 |
| Appearance | Opaque_255_255_255 |
| Color (RGB 0-1) | (1.000, 1.000, 1.000) |
| Color (RGB 0-255) | (255, 255, 255) |

#### 🔧 COMPONENT: `leg_3_tibia`

| Property | Value |
|---|---|
| Full path | `leg_3_tibia:1` |
| Component name | leg_3_tibia |
| Depth | 0 |
| Path segments | leg_3_tibia |
| **Transforms** | |
| Global position (m) | (0.196768, -0.000000, -0.041549) |
| Global position (mm) | (196.77, -0.00, -41.55) |
| Local transform (m) | (0.196768, -0.000000, -0.041549) |
| Assembly context depth | 0 |
| transform2 (m) | (0.196768, -0.000000, -0.041549) |
| **Physical** | |
| Mass | 0.154962 kg (154.962 g) |
| Volume | 1.974040e-05 m³ |
| Density | 7850.0 kg/m³ |
| Surface area | 1.394610e-02 m² |
| Body count | 1 |
| CoM (component-local, m) | (-0.049791, -0.043459, 0.000001) |
| CoM (global, m) | (0.146978, -0.043459, -0.041548) |
| CoM (global, mm) | (146.98, -43.46, -41.55) |
| **Inertia at origin (kg·m²)** | |
| Ixx, Iyy, Izz | 4.970029e-04, 4.704043e-04, 9.071190e-04 |
| Ixy, Ixz, Iyz | -4.149918e-04, 3.784732e-09, 5.051465e-11 |
| **Inertia at CoM (kg·m²)** | |
| Ixx, Iyy, Izz | 2.043255e-04, 8.623421e-05, 2.302716e-04 |
| Ixy, Ixz, Iyz | -7.967425e-05, -5.645496e-09, -8.180530e-09 |
| Bounding box (m) | 0.0841 × 0.1047 × 0.0360 |
| Bounding box (mm) | 84.07 × 104.69 × 36.00 |
| **Material & Appearance** | |
| Material | Steel |
| Appearance | Opaque_255_255_255 |
| Color (RGB 0-1) | (1.000, 1.000, 1.000) |
| Color (RGB 0-255) | (255, 255, 255) |

#### 🔧 COMPONENT: `leg_4_coxa`

| Property | Value |
|---|---|
| Full path | `leg_4_coxa:1` |
| Component name | leg_4_coxa |
| Depth | 0 |
| Path segments | leg_4_coxa |
| **Transforms** | |
| Global position (m) | (0.102347, 0.152347, -0.018000) |
| Global position (mm) | (102.35, 152.35, -18.00) |
| Local transform (m) | (0.102347, 0.152347, -0.018000) |
| Assembly context depth | 0 |
| transform2 (m) | (0.102347, 0.152347, -0.018000) |
| **Physical** | |
| Mass | 0.192968 kg (192.968 g) |
| Volume | 2.458186e-05 m³ |
| Density | 7850.0 kg/m³ |
| Surface area | 1.384356e-02 m² |
| Body count | 1 |
| CoM (component-local, m) | (-0.026008, 0.000000, -0.000000) |
| CoM (global, m) | (0.076338, 0.152347, -0.018000) |
| CoM (global, mm) | (76.34, 152.35, -18.00) |
| **Inertia at origin (kg·m²)** | |
| Ixx, Iyy, Izz | 8.738331e-05, 2.179312e-04, 2.203039e-04 |
| Ixy, Ixz, Iyz | 1.133249e-09, -1.180732e-09, 1.075058e-10 |
| **Inertia at CoM (kg·m²)** | |
| Ixx, Iyy, Izz | 8.738331e-05, 8.740064e-05, 8.977332e-05 |
| Ixy, Ixz, Iyz | 2.081866e-10, -4.006872e-10, 1.075002e-10 |
| Bounding box (m) | 0.0790 × 0.0480 × 0.0480 |
| Bounding box (mm) | 79.00 × 48.00 × 48.00 |
| **Material & Appearance** | |
| Material | Steel |
| Appearance | Opaque_255_255_255 |
| Color (RGB 0-1) | (1.000, 1.000, 1.000) |
| Color (RGB 0-255) | (255, 255, 255) |

#### 🔧 COMPONENT: `leg_4_femur`

| Property | Value |
|---|---|
| Full path | `leg_4_femur:1` |
| Component name | leg_4_femur |
| Depth | 0 |
| Path segments | leg_4_femur |
| **Transforms** | |
| Global position (m) | (0.127661, 0.177661, -0.018000) |
| Global position (mm) | (127.66, 177.66, -18.00) |
| Local transform (m) | (0.127661, 0.177661, -0.018000) |
| Assembly context depth | 0 |
| transform2 (m) | (0.127661, 0.177661, -0.018000) |
| **Physical** | |
| Mass | 0.127034 kg (127.034 g) |
| Volume | 1.618264e-05 m³ |
| Density | 7850.0 kg/m³ |
| Surface area | 9.524369e-03 m² |
| Body count | 1 |
| CoM (component-local, m) | (0.002213, 0.011329, -0.000000) |
| CoM (global, m) | (0.129874, 0.188990, -0.018000) |
| CoM (global, mm) | (129.87, 188.99, -18.00) |
| **Inertia at origin (kg·m²)** | |
| Ixx, Iyy, Izz | 6.551941e-05, 5.196798e-05, 4.448854e-05 |
| Ixy, Ixz, Iyz | -8.253525e-06, 6.684992e-12, -3.715345e-11 |
| **Inertia at CoM (kg·m²)** | |
| Ixx, Iyy, Izz | 4.921450e-05, 5.134561e-05, 2.756126e-05 |
| Ixy, Ixz, Iyz | -5.067980e-06, -4.447828e-11, -2.990278e-10 |
| Bounding box (m) | 0.0448 × 0.0463 × 0.0480 |
| Bounding box (mm) | 44.80 × 46.30 × 48.00 |
| **Material & Appearance** | |
| Material | Steel |
| Appearance | Opaque_255_255_255 |
| Color (RGB 0-1) | (1.000, 1.000, 1.000) |
| Color (RGB 0-255) | (255, 255, 255) |

#### 🔧 COMPONENT: `leg_4_mx28_coxa`

| Property | Value |
|---|---|
| Full path | `leg_4_mx28_coxa:1` |
| Component name | leg_4_mx28_coxa |
| Depth | 0 |
| Path segments | leg_4_mx28_coxa |
| **Transforms** | |
| Global position (m) | (0.065577, 0.115577, -0.018000) |
| Global position (mm) | (65.58, 115.58, -18.00) |
| Local transform (m) | (0.065577, 0.115577, -0.018000) |
| Assembly context depth | 0 |
| transform2 (m) | (0.065577, 0.115577, -0.018000) |
| **Physical** | |
| Mass | 0.073932 kg (73.932 g) |
| Volume | 4.443055e-05 m³ |
| Density | 1664.0 kg/m³ |
| Surface area | 1.141476e-02 m² |
| Body count | 1 |
| CoM (component-local, m) | (0.000000, -0.011210, 0.000488) |
| CoM (global, m) | (0.065577, 0.104367, -0.017512) |
| CoM (global, mm) | (65.58, 104.37, -17.51) |
| **Inertia at origin (kg·m²)** | |
| Ixx, Iyy, Izz | 3.064312e-05, 1.326921e-05, 2.684786e-05 |
| Ixy, Ixz, Iyz | 8.383364e-10, -6.769801e-11, -3.310929e-07 |
| **Inertia at CoM (kg·m²)** | |
| Ixx, Iyy, Izz | 2.133552e-05, 1.325162e-05, 1.755785e-05 |
| Ixy, Ixz, Iyz | 4.901953e-10, -5.255020e-11, -7.353064e-07 |
| Bounding box (m) | 0.0356 × 0.0506 × 0.0431 |
| Bounding box (mm) | 35.60 × 50.60 × 43.10 |
| **Material & Appearance** | |
| Material | custom_materials_MX_28 |
| Appearance | Opaque_255_255_255 |
| Color (RGB 0-1) | (1.000, 1.000, 1.000) |
| Color (RGB 0-255) | (255, 255, 255) |

#### 🔧 COMPONENT: `leg_4_mx28_femur`

| Property | Value |
|---|---|
| Full path | `leg_4_mx28_femur:1` |
| Component name | leg_4_mx28_femur |
| Depth | 0 |
| Path segments | leg_4_mx28_femur |
| **Transforms** | |
| Global position (m) | (0.102347, 0.152347, -0.018000) |
| Global position (mm) | (102.35, 152.35, -18.00) |
| Local transform (m) | (0.102347, 0.152347, -0.018000) |
| Assembly context depth | 0 |
| transform2 (m) | (0.102347, 0.152347, -0.018000) |
| **Physical** | |
| Mass | 0.073932 kg (73.932 g) |
| Volume | 4.443055e-05 m³ |
| Density | 1664.0 kg/m³ |
| Surface area | 1.141476e-02 m² |
| Body count | 1 |
| CoM (component-local, m) | (0.000000, -0.011210, 0.000488) |
| CoM (global, m) | (0.102347, 0.141137, -0.017512) |
| CoM (global, mm) | (102.35, 141.14, -17.51) |
| **Inertia at origin (kg·m²)** | |
| Ixx, Iyy, Izz | 3.064312e-05, 1.326921e-05, 2.684786e-05 |
| Ixy, Ixz, Iyz | 8.383364e-10, -6.769801e-11, -3.310929e-07 |
| **Inertia at CoM (kg·m²)** | |
| Ixx, Iyy, Izz | 2.133552e-05, 1.325162e-05, 1.755785e-05 |
| Ixy, Ixz, Iyz | 4.901953e-10, -5.255020e-11, -7.353064e-07 |
| Bounding box (m) | 0.0356 × 0.0506 × 0.0431 |
| Bounding box (mm) | 35.60 × 50.60 × 43.10 |
| **Material & Appearance** | |
| Material | custom_materials_MX_28 |
| Appearance | Opaque_255_255_255 |
| Color (RGB 0-1) | (1.000, 1.000, 1.000) |
| Color (RGB 0-255) | (255, 255, 255) |

#### 🔧 COMPONENT: `leg_4_mx28_tibia`

| Property | Value |
|---|---|
| Full path | `leg_4_mx28_tibia:1` |
| Component name | leg_4_mx28_tibia |
| Depth | 0 |
| Path segments | leg_4_mx28_tibia |
| **Transforms** | |
| Global position (m) | (0.148167, 0.198167, -0.033000) |
| Global position (mm) | (148.17, 198.17, -33.00) |
| Local transform (m) | (0.148167, 0.198167, -0.033000) |
| Assembly context depth | 0 |
| transform2 (m) | (0.148167, 0.198167, -0.033000) |
| **Physical** | |
| Mass | 0.073932 kg (73.932 g) |
| Volume | 4.443055e-05 m³ |
| Density | 1664.0 kg/m³ |
| Surface area | 1.141476e-02 m² |
| Body count | 1 |
| CoM (component-local, m) | (0.000000, -0.011210, 0.000488) |
| CoM (global, m) | (0.148167, 0.186957, -0.032512) |
| CoM (global, mm) | (148.17, 186.96, -32.51) |
| **Inertia at origin (kg·m²)** | |
| Ixx, Iyy, Izz | 3.064312e-05, 1.326921e-05, 2.684786e-05 |
| Ixy, Ixz, Iyz | 8.383364e-10, -6.769801e-11, -3.310929e-07 |
| **Inertia at CoM (kg·m²)** | |
| Ixx, Iyy, Izz | 2.133552e-05, 1.325162e-05, 1.755785e-05 |
| Ixy, Ixz, Iyz | 4.901953e-10, -5.255020e-11, -7.353064e-07 |
| Bounding box (m) | 0.0356 × 0.0506 × 0.0431 |
| Bounding box (mm) | 35.60 × 50.60 × 43.10 |
| **Material & Appearance** | |
| Material | custom_materials_MX_28 |
| Appearance | Opaque_255_255_255 |
| Color (RGB 0-1) | (1.000, 1.000, 1.000) |
| Color (RGB 0-255) | (255, 255, 255) |

#### 🔧 COMPONENT: `leg_4_tibia`

| Property | Value |
|---|---|
| Full path | `leg_4_tibia:1` |
| Component name | leg_4_tibia |
| Depth | 0 |
| Path segments | leg_4_tibia |
| **Transforms** | |
| Global position (m) | (0.155371, 0.205371, -0.041549) |
| Global position (mm) | (155.37, 205.37, -41.55) |
| Local transform (m) | (0.155371, 0.205371, -0.041549) |
| Assembly context depth | 0 |
| transform2 (m) | (0.155371, 0.205371, -0.041549) |
| **Physical** | |
| Mass | 0.154962 kg (154.962 g) |
| Volume | 1.974040e-05 m³ |
| Density | 7850.0 kg/m³ |
| Surface area | 1.394610e-02 m² |
| Body count | 1 |
| CoM (component-local, m) | (-0.049791, -0.043459, 0.000001) |
| CoM (global, m) | (0.105581, 0.161912, -0.041548) |
| CoM (global, mm) | (105.58, 161.91, -41.55) |
| **Inertia at origin (kg·m²)** | |
| Ixx, Iyy, Izz | 4.970029e-04, 4.704043e-04, 9.071190e-04 |
| Ixy, Ixz, Iyz | -4.149918e-04, 3.784732e-09, 5.051465e-11 |
| **Inertia at CoM (kg·m²)** | |
| Ixx, Iyy, Izz | 2.043255e-04, 8.623421e-05, 2.302716e-04 |
| Ixy, Ixz, Iyz | -7.967425e-05, -5.645496e-09, -8.180530e-09 |
| Bounding box (m) | 0.0841 × 0.1047 × 0.0360 |
| Bounding box (mm) | 84.07 × 104.69 × 36.00 |
| **Material & Appearance** | |
| Material | Steel |
| Appearance | Opaque_255_255_255 |
| Color (RGB 0-1) | (1.000, 1.000, 1.000) |
| Color (RGB 0-255) | (255, 255, 255) |

#### 🔧 COMPONENT: `leg_5_coxa`

| Property | Value |
|---|---|
| Full path | `leg_5_coxa:1` |
| Component name | leg_5_coxa |
| Depth | 0 |
| Path segments | leg_5_coxa |
| **Transforms** | |
| Global position (m) | (-0.102347, 0.152347, -0.018000) |
| Global position (mm) | (-102.35, 152.35, -18.00) |
| Local transform (m) | (-0.102347, 0.152347, -0.018000) |
| Assembly context depth | 0 |
| transform2 (m) | (-0.102347, 0.152347, -0.018000) |
| **Physical** | |
| Mass | 0.192968 kg (192.968 g) |
| Volume | 2.458186e-05 m³ |
| Density | 7850.0 kg/m³ |
| Surface area | 1.384356e-02 m² |
| Body count | 1 |
| CoM (component-local, m) | (-0.026008, 0.000000, -0.000000) |
| CoM (global, m) | (-0.128355, 0.152347, -0.018000) |
| CoM (global, mm) | (-128.35, 152.35, -18.00) |
| **Inertia at origin (kg·m²)** | |
| Ixx, Iyy, Izz | 8.738331e-05, 2.179312e-04, 2.203039e-04 |
| Ixy, Ixz, Iyz | 1.133249e-09, -1.180732e-09, 1.075058e-10 |
| **Inertia at CoM (kg·m²)** | |
| Ixx, Iyy, Izz | 8.738331e-05, 8.740064e-05, 8.977332e-05 |
| Ixy, Ixz, Iyz | 2.081866e-10, -4.006872e-10, 1.075002e-10 |
| Bounding box (m) | 0.0790 × 0.0480 × 0.0480 |
| Bounding box (mm) | 79.00 × 48.00 × 48.00 |
| **Material & Appearance** | |
| Material | Steel |
| Appearance | Opaque_255_255_255 |
| Color (RGB 0-1) | (1.000, 1.000, 1.000) |
| Color (RGB 0-255) | (255, 255, 255) |

#### 🔧 COMPONENT: `leg_5_femur`

| Property | Value |
|---|---|
| Full path | `leg_5_femur:1` |
| Component name | leg_5_femur |
| Depth | 0 |
| Path segments | leg_5_femur |
| **Transforms** | |
| Global position (m) | (-0.127661, 0.177661, -0.018000) |
| Global position (mm) | (-127.66, 177.66, -18.00) |
| Local transform (m) | (-0.127661, 0.177661, -0.018000) |
| Assembly context depth | 0 |
| transform2 (m) | (-0.127661, 0.177661, -0.018000) |
| **Physical** | |
| Mass | 0.127034 kg (127.034 g) |
| Volume | 1.618264e-05 m³ |
| Density | 7850.0 kg/m³ |
| Surface area | 9.524369e-03 m² |
| Body count | 1 |
| CoM (component-local, m) | (0.002213, 0.011329, -0.000000) |
| CoM (global, m) | (-0.125448, 0.188990, -0.018000) |
| CoM (global, mm) | (-125.45, 188.99, -18.00) |
| **Inertia at origin (kg·m²)** | |
| Ixx, Iyy, Izz | 6.551941e-05, 5.196798e-05, 4.448854e-05 |
| Ixy, Ixz, Iyz | -8.253525e-06, 6.684992e-12, -3.715345e-11 |
| **Inertia at CoM (kg·m²)** | |
| Ixx, Iyy, Izz | 4.921450e-05, 5.134561e-05, 2.756126e-05 |
| Ixy, Ixz, Iyz | -5.067980e-06, -4.447828e-11, -2.990278e-10 |
| Bounding box (m) | 0.0448 × 0.0463 × 0.0480 |
| Bounding box (mm) | 44.80 × 46.30 × 48.00 |
| **Material & Appearance** | |
| Material | Steel |
| Appearance | Opaque_255_255_255 |
| Color (RGB 0-1) | (1.000, 1.000, 1.000) |
| Color (RGB 0-255) | (255, 255, 255) |

#### 🔧 COMPONENT: `leg_5_mx28_coxa`

| Property | Value |
|---|---|
| Full path | `leg_5_mx28_coxa:1` |
| Component name | leg_5_mx28_coxa |
| Depth | 0 |
| Path segments | leg_5_mx28_coxa |
| **Transforms** | |
| Global position (m) | (-0.065577, 0.115577, -0.018000) |
| Global position (mm) | (-65.58, 115.58, -18.00) |
| Local transform (m) | (-0.065577, 0.115577, -0.018000) |
| Assembly context depth | 0 |
| transform2 (m) | (-0.065577, 0.115577, -0.018000) |
| **Physical** | |
| Mass | 0.073932 kg (73.932 g) |
| Volume | 4.443055e-05 m³ |
| Density | 1664.0 kg/m³ |
| Surface area | 1.141476e-02 m² |
| Body count | 1 |
| CoM (component-local, m) | (0.000000, -0.011210, 0.000488) |
| CoM (global, m) | (-0.065577, 0.104367, -0.017512) |
| CoM (global, mm) | (-65.58, 104.37, -17.51) |
| **Inertia at origin (kg·m²)** | |
| Ixx, Iyy, Izz | 3.064312e-05, 1.326921e-05, 2.684786e-05 |
| Ixy, Ixz, Iyz | 8.383364e-10, -6.769801e-11, -3.310929e-07 |
| **Inertia at CoM (kg·m²)** | |
| Ixx, Iyy, Izz | 2.133552e-05, 1.325162e-05, 1.755785e-05 |
| Ixy, Ixz, Iyz | 4.901953e-10, -5.255020e-11, -7.353064e-07 |
| Bounding box (m) | 0.0356 × 0.0506 × 0.0431 |
| Bounding box (mm) | 35.60 × 50.60 × 43.10 |
| **Material & Appearance** | |
| Material | custom_materials_MX_28 |
| Appearance | Opaque_255_255_255 |
| Color (RGB 0-1) | (1.000, 1.000, 1.000) |
| Color (RGB 0-255) | (255, 255, 255) |

#### 🔧 COMPONENT: `leg_5_mx28_femur`

| Property | Value |
|---|---|
| Full path | `leg_5_mx28_femur:1` |
| Component name | leg_5_mx28_femur |
| Depth | 0 |
| Path segments | leg_5_mx28_femur |
| **Transforms** | |
| Global position (m) | (-0.102347, 0.152347, -0.018000) |
| Global position (mm) | (-102.35, 152.35, -18.00) |
| Local transform (m) | (-0.102347, 0.152347, -0.018000) |
| Assembly context depth | 0 |
| transform2 (m) | (-0.102347, 0.152347, -0.018000) |
| **Physical** | |
| Mass | 0.073932 kg (73.932 g) |
| Volume | 4.443055e-05 m³ |
| Density | 1664.0 kg/m³ |
| Surface area | 1.141476e-02 m² |
| Body count | 1 |
| CoM (component-local, m) | (0.000000, -0.011210, 0.000488) |
| CoM (global, m) | (-0.102346, 0.141137, -0.017512) |
| CoM (global, mm) | (-102.35, 141.14, -17.51) |
| **Inertia at origin (kg·m²)** | |
| Ixx, Iyy, Izz | 3.064312e-05, 1.326921e-05, 2.684786e-05 |
| Ixy, Ixz, Iyz | 8.383364e-10, -6.769801e-11, -3.310929e-07 |
| **Inertia at CoM (kg·m²)** | |
| Ixx, Iyy, Izz | 2.133552e-05, 1.325162e-05, 1.755785e-05 |
| Ixy, Ixz, Iyz | 4.901953e-10, -5.255020e-11, -7.353064e-07 |
| Bounding box (m) | 0.0356 × 0.0506 × 0.0431 |
| Bounding box (mm) | 35.60 × 50.60 × 43.10 |
| **Material & Appearance** | |
| Material | custom_materials_MX_28 |
| Appearance | Opaque_255_255_255 |
| Color (RGB 0-1) | (1.000, 1.000, 1.000) |
| Color (RGB 0-255) | (255, 255, 255) |

#### 🔧 COMPONENT: `leg_5_mx28_tibia`

| Property | Value |
|---|---|
| Full path | `leg_5_mx28_tibia:1` |
| Component name | leg_5_mx28_tibia |
| Depth | 0 |
| Path segments | leg_5_mx28_tibia |
| **Transforms** | |
| Global position (m) | (-0.148167, 0.198167, -0.033000) |
| Global position (mm) | (-148.17, 198.17, -33.00) |
| Local transform (m) | (-0.148167, 0.198167, -0.033000) |
| Assembly context depth | 0 |
| transform2 (m) | (-0.148167, 0.198167, -0.033000) |
| **Physical** | |
| Mass | 0.073932 kg (73.932 g) |
| Volume | 4.443055e-05 m³ |
| Density | 1664.0 kg/m³ |
| Surface area | 1.141476e-02 m² |
| Body count | 1 |
| CoM (component-local, m) | (0.000000, -0.011210, 0.000488) |
| CoM (global, m) | (-0.148167, 0.186957, -0.032512) |
| CoM (global, mm) | (-148.17, 186.96, -32.51) |
| **Inertia at origin (kg·m²)** | |
| Ixx, Iyy, Izz | 3.064312e-05, 1.326921e-05, 2.684786e-05 |
| Ixy, Ixz, Iyz | 8.383364e-10, -6.769801e-11, -3.310929e-07 |
| **Inertia at CoM (kg·m²)** | |
| Ixx, Iyy, Izz | 2.133552e-05, 1.325162e-05, 1.755785e-05 |
| Ixy, Ixz, Iyz | 4.901953e-10, -5.255020e-11, -7.353064e-07 |
| Bounding box (m) | 0.0356 × 0.0506 × 0.0431 |
| Bounding box (mm) | 35.60 × 50.60 × 43.10 |
| **Material & Appearance** | |
| Material | custom_materials_MX_28 |
| Appearance | Opaque_255_255_255 |
| Color (RGB 0-1) | (1.000, 1.000, 1.000) |
| Color (RGB 0-255) | (255, 255, 255) |

#### 🔧 COMPONENT: `leg_5_tibia`

| Property | Value |
|---|---|
| Full path | `leg_5_tibia:1` |
| Component name | leg_5_tibia |
| Depth | 0 |
| Path segments | leg_5_tibia |
| **Transforms** | |
| Global position (m) | (-0.155371, 0.205371, -0.041549) |
| Global position (mm) | (-155.37, 205.37, -41.55) |
| Local transform (m) | (-0.155371, 0.205371, -0.041549) |
| Assembly context depth | 0 |
| transform2 (m) | (-0.155371, 0.205371, -0.041549) |
| **Physical** | |
| Mass | 0.154962 kg (154.962 g) |
| Volume | 1.974040e-05 m³ |
| Density | 7850.0 kg/m³ |
| Surface area | 1.394610e-02 m² |
| Body count | 1 |
| CoM (component-local, m) | (-0.049791, -0.043459, 0.000001) |
| CoM (global, m) | (-0.205162, 0.161912, -0.041548) |
| CoM (global, mm) | (-205.16, 161.91, -41.55) |
| **Inertia at origin (kg·m²)** | |
| Ixx, Iyy, Izz | 4.970029e-04, 4.704043e-04, 9.071190e-04 |
| Ixy, Ixz, Iyz | -4.149918e-04, 3.784732e-09, 5.051465e-11 |
| **Inertia at CoM (kg·m²)** | |
| Ixx, Iyy, Izz | 2.043255e-04, 8.623421e-05, 2.302716e-04 |
| Ixy, Ixz, Iyz | -7.967425e-05, -5.645496e-09, -8.180530e-09 |
| Bounding box (m) | 0.0841 × 0.1047 × 0.0360 |
| Bounding box (mm) | 84.07 × 104.69 × 36.00 |
| **Material & Appearance** | |
| Material | Steel |
| Appearance | Opaque_255_255_255 |
| Color (RGB 0-1) | (1.000, 1.000, 1.000) |
| Color (RGB 0-255) | (255, 255, 255) |

#### 🔧 COMPONENT: `leg_6_coxa`

| Property | Value |
|---|---|
| Full path | `leg_6_coxa:1` |
| Component name | leg_6_coxa |
| Depth | 0 |
| Path segments | leg_6_coxa |
| **Transforms** | |
| Global position (m) | (-0.121780, 0.000000, -0.018000) |
| Global position (mm) | (-121.78, 0.00, -18.00) |
| Local transform (m) | (-0.121780, 0.000000, -0.018000) |
| Assembly context depth | 0 |
| transform2 (m) | (-0.121780, 0.000000, -0.018000) |
| **Physical** | |
| Mass | 0.192968 kg (192.968 g) |
| Volume | 2.458186e-05 m³ |
| Density | 7850.0 kg/m³ |
| Surface area | 1.384356e-02 m² |
| Body count | 1 |
| CoM (component-local, m) | (-0.026008, 0.000000, -0.000000) |
| CoM (global, m) | (-0.147788, 0.000000, -0.018000) |
| CoM (global, mm) | (-147.79, 0.00, -18.00) |
| **Inertia at origin (kg·m²)** | |
| Ixx, Iyy, Izz | 8.738331e-05, 2.179312e-04, 2.203039e-04 |
| Ixy, Ixz, Iyz | 1.133249e-09, -1.180732e-09, 1.075058e-10 |
| **Inertia at CoM (kg·m²)** | |
| Ixx, Iyy, Izz | 8.738331e-05, 8.740064e-05, 8.977332e-05 |
| Ixy, Ixz, Iyz | 2.081866e-10, -4.006872e-10, 1.075002e-10 |
| Bounding box (m) | 0.0790 × 0.0480 × 0.0480 |
| Bounding box (mm) | 79.00 × 48.00 × 48.00 |
| **Material & Appearance** | |
| Material | Steel |
| Appearance | Opaque_255_255_255 |
| Color (RGB 0-1) | (1.000, 1.000, 1.000) |
| Color (RGB 0-255) | (255, 255, 255) |

#### 🔧 COMPONENT: `leg_6_femur`

| Property | Value |
|---|---|
| Full path | `leg_6_femur:1` |
| Component name | leg_6_femur |
| Depth | 0 |
| Path segments | leg_6_femur |
| **Transforms** | |
| Global position (m) | (-0.157580, 0.000000, -0.018000) |
| Global position (mm) | (-157.58, 0.00, -18.00) |
| Local transform (m) | (-0.157580, 0.000000, -0.018000) |
| Assembly context depth | 0 |
| transform2 (m) | (-0.157580, 0.000000, -0.018000) |
| **Physical** | |
| Mass | 0.127034 kg (127.034 g) |
| Volume | 1.618264e-05 m³ |
| Density | 7850.0 kg/m³ |
| Surface area | 9.524369e-03 m² |
| Body count | 1 |
| CoM (component-local, m) | (0.002213, 0.011329, -0.000000) |
| CoM (global, m) | (-0.155367, 0.011329, -0.018000) |
| CoM (global, mm) | (-155.37, 11.33, -18.00) |
| **Inertia at origin (kg·m²)** | |
| Ixx, Iyy, Izz | 6.551941e-05, 5.196798e-05, 4.448854e-05 |
| Ixy, Ixz, Iyz | -8.253525e-06, 6.684992e-12, -3.715345e-11 |
| **Inertia at CoM (kg·m²)** | |
| Ixx, Iyy, Izz | 4.921450e-05, 5.134561e-05, 2.756126e-05 |
| Ixy, Ixz, Iyz | -5.067980e-06, -4.447828e-11, -2.990278e-10 |
| Bounding box (m) | 0.0448 × 0.0463 × 0.0480 |
| Bounding box (mm) | 44.80 × 46.30 × 48.00 |
| **Material & Appearance** | |
| Material | Steel |
| Appearance | Opaque_255_255_255 |
| Color (RGB 0-1) | (1.000, 1.000, 1.000) |
| Color (RGB 0-255) | (255, 255, 255) |

#### 🔧 COMPONENT: `leg_6_mx28_coxa`

| Property | Value |
|---|---|
| Full path | `leg_6_mx28_coxa:1` |
| Component name | leg_6_mx28_coxa |
| Depth | 0 |
| Path segments | leg_6_mx28_coxa |
| **Transforms** | |
| Global position (m) | (-0.069780, 0.000000, -0.018000) |
| Global position (mm) | (-69.78, 0.00, -18.00) |
| Local transform (m) | (-0.069780, 0.000000, -0.018000) |
| Assembly context depth | 0 |
| transform2 (m) | (-0.069780, 0.000000, -0.018000) |
| **Physical** | |
| Mass | 0.073932 kg (73.932 g) |
| Volume | 4.443055e-05 m³ |
| Density | 1664.0 kg/m³ |
| Surface area | 1.141476e-02 m² |
| Body count | 1 |
| CoM (component-local, m) | (0.000000, -0.011210, 0.000488) |
| CoM (global, m) | (-0.069780, -0.011210, -0.017512) |
| CoM (global, mm) | (-69.78, -11.21, -17.51) |
| **Inertia at origin (kg·m²)** | |
| Ixx, Iyy, Izz | 3.064312e-05, 1.326921e-05, 2.684786e-05 |
| Ixy, Ixz, Iyz | 8.383364e-10, -6.769801e-11, -3.310929e-07 |
| **Inertia at CoM (kg·m²)** | |
| Ixx, Iyy, Izz | 2.133552e-05, 1.325162e-05, 1.755785e-05 |
| Ixy, Ixz, Iyz | 4.901953e-10, -5.255020e-11, -7.353064e-07 |
| Bounding box (m) | 0.0356 × 0.0506 × 0.0431 |
| Bounding box (mm) | 35.60 × 50.60 × 43.10 |
| **Material & Appearance** | |
| Material | custom_materials_MX_28 |
| Appearance | Opaque_255_255_255 |
| Color (RGB 0-1) | (1.000, 1.000, 1.000) |
| Color (RGB 0-255) | (255, 255, 255) |

#### 🔧 COMPONENT: `leg_6_mx28_femur`

| Property | Value |
|---|---|
| Full path | `leg_6_mx28_femur:1` |
| Component name | leg_6_mx28_femur |
| Depth | 0 |
| Path segments | leg_6_mx28_femur |
| **Transforms** | |
| Global position (m) | (-0.121780, 0.000000, -0.018000) |
| Global position (mm) | (-121.78, 0.00, -18.00) |
| Local transform (m) | (-0.121780, 0.000000, -0.018000) |
| Assembly context depth | 0 |
| transform2 (m) | (-0.121780, 0.000000, -0.018000) |
| **Physical** | |
| Mass | 0.073932 kg (73.932 g) |
| Volume | 4.443055e-05 m³ |
| Density | 1664.0 kg/m³ |
| Surface area | 1.141476e-02 m² |
| Body count | 1 |
| CoM (component-local, m) | (0.000000, -0.011210, 0.000488) |
| CoM (global, m) | (-0.121780, -0.011210, -0.017512) |
| CoM (global, mm) | (-121.78, -11.21, -17.51) |
| **Inertia at origin (kg·m²)** | |
| Ixx, Iyy, Izz | 3.064312e-05, 1.326921e-05, 2.684786e-05 |
| Ixy, Ixz, Iyz | 8.383364e-10, -6.769801e-11, -3.310929e-07 |
| **Inertia at CoM (kg·m²)** | |
| Ixx, Iyy, Izz | 2.133552e-05, 1.325162e-05, 1.755785e-05 |
| Ixy, Ixz, Iyz | 4.901953e-10, -5.255020e-11, -7.353064e-07 |
| Bounding box (m) | 0.0356 × 0.0506 × 0.0431 |
| Bounding box (mm) | 35.60 × 50.60 × 43.10 |
| **Material & Appearance** | |
| Material | custom_materials_MX_28 |
| Appearance | Opaque_255_255_255 |
| Color (RGB 0-1) | (1.000, 1.000, 1.000) |
| Color (RGB 0-255) | (255, 255, 255) |

#### 🔧 COMPONENT: `leg_6_mx28_tibia`

| Property | Value |
|---|---|
| Full path | `leg_6_mx28_tibia:1` |
| Component name | leg_6_mx28_tibia |
| Depth | 0 |
| Path segments | leg_6_mx28_tibia |
| **Transforms** | |
| Global position (m) | (-0.186580, 0.000000, -0.033000) |
| Global position (mm) | (-186.58, 0.00, -33.00) |
| Local transform (m) | (-0.186580, 0.000000, -0.033000) |
| Assembly context depth | 0 |
| transform2 (m) | (-0.186580, 0.000000, -0.033000) |
| **Physical** | |
| Mass | 0.073932 kg (73.932 g) |
| Volume | 4.443055e-05 m³ |
| Density | 1664.0 kg/m³ |
| Surface area | 1.141476e-02 m² |
| Body count | 1 |
| CoM (component-local, m) | (0.000000, -0.011210, 0.000488) |
| CoM (global, m) | (-0.186580, -0.011210, -0.032512) |
| CoM (global, mm) | (-186.58, -11.21, -32.51) |
| **Inertia at origin (kg·m²)** | |
| Ixx, Iyy, Izz | 3.064312e-05, 1.326921e-05, 2.684786e-05 |
| Ixy, Ixz, Iyz | 8.383364e-10, -6.769801e-11, -3.310929e-07 |
| **Inertia at CoM (kg·m²)** | |
| Ixx, Iyy, Izz | 2.133552e-05, 1.325162e-05, 1.755785e-05 |
| Ixy, Ixz, Iyz | 4.901953e-10, -5.255020e-11, -7.353064e-07 |
| Bounding box (m) | 0.0356 × 0.0506 × 0.0431 |
| Bounding box (mm) | 35.60 × 50.60 × 43.10 |
| **Material & Appearance** | |
| Material | custom_materials_MX_28 |
| Appearance | Opaque_255_255_255 |
| Color (RGB 0-1) | (1.000, 1.000, 1.000) |
| Color (RGB 0-255) | (255, 255, 255) |

#### 🔧 COMPONENT: `leg_6_tibia`

| Property | Value |
|---|---|
| Full path | `leg_6_tibia:1` |
| Component name | leg_6_tibia |
| Depth | 0 |
| Path segments | leg_6_tibia |
| **Transforms** | |
| Global position (m) | (-0.196768, 0.000000, -0.041549) |
| Global position (mm) | (-196.77, 0.00, -41.55) |
| Local transform (m) | (-0.196768, 0.000000, -0.041549) |
| Assembly context depth | 0 |
| transform2 (m) | (-0.196768, 0.000000, -0.041549) |
| **Physical** | |
| Mass | 0.154962 kg (154.962 g) |
| Volume | 1.974040e-05 m³ |
| Density | 7850.0 kg/m³ |
| Surface area | 1.394610e-02 m² |
| Body count | 1 |
| CoM (component-local, m) | (-0.049791, -0.043459, 0.000001) |
| CoM (global, m) | (-0.246559, -0.043459, -0.041548) |
| CoM (global, mm) | (-246.56, -43.46, -41.55) |
| **Inertia at origin (kg·m²)** | |
| Ixx, Iyy, Izz | 4.970029e-04, 4.704043e-04, 9.071190e-04 |
| Ixy, Ixz, Iyz | -4.149918e-04, 3.784732e-09, 5.051465e-11 |
| **Inertia at CoM (kg·m²)** | |
| Ixx, Iyy, Izz | 2.043255e-04, 8.623421e-05, 2.302716e-04 |
| Ixy, Ixz, Iyz | -7.967425e-05, -5.645496e-09, -8.180530e-09 |
| Bounding box (m) | 0.0841 × 0.1047 × 0.0360 |
| Bounding box (mm) | 84.07 × 104.69 × 36.00 |
| **Material & Appearance** | |
| Material | Steel |
| Appearance | Opaque_255_255_255 |
| Color (RGB 0-1) | (1.000, 1.000, 1.000) |
| Color (RGB 0-255) | (255, 255, 255) |

#### 🔧 COMPONENT: `top`

| Property | Value |
|---|---|
| Full path | `top:1` |
| Component name | top |
| Depth | 0 |
| Path segments | top |
| **Transforms** | |
| Global position (m) | (-0.076463, -0.126463, -0.001500) |
| Global position (mm) | (-76.46, -126.46, -1.50) |
| Local transform (m) | (-0.076463, -0.126463, -0.001500) |
| Assembly context depth | 0 |
| transform2 (m) | (-0.076463, -0.126463, -0.001500) |
| **Physical** | |
| Mass | 0.241307 kg (241.307 g) |
| Volume | 3.073975e-05 m³ |
| Density | 7850.0 kg/m³ |
| Surface area | 2.989733e-02 m² |
| Body count | 1 |
| CoM (component-local, m) | (0.076463, 0.126463, -0.000093) |
| CoM (global, m) | (0.000000, 0.000000, -0.001593) |
| CoM (global, mm) | (0.00, 0.00, -1.59) |
| **Inertia at origin (kg·m²)** | |
| Ixx, Iyy, Izz | 5.116979e-03, 1.803020e-03, 6.919637e-03 |
| Ixy, Ixz, Iyz | -2.333399e-03, 1.709772e-06, 2.827803e-06 |
| **Inertia at CoM (kg·m²)** | |
| Ixx, Iyy, Izz | 1.257752e-03, 3.921768e-04, 1.649571e-03 |
| Ixy, Ixz, Iyz | 7.341016e-10, 4.914718e-17, 2.202286e-20 |
| Bounding box (m) | 0.1529 × 0.2529 × 0.0030 |
| Bounding box (mm) | 152.91 × 252.91 × 3.00 |
| **Material & Appearance** | |
| Material | Steel |
| Appearance | Steel_Satin |
| Color (RGB 0-1) | (0.627, 0.627, 0.627) |
| Color (RGB 0-255) | (160, 160, 160) |

## Joints

#### 🔧 Joint: `Revolute_30` (regular)

| Property | Value |
|---|---|
| Defining component | HexNav (HexNav) |
| Suppressed | False |
| Motion type | revolute (enum=1) |
| Axis | (-0.0000, -0.0000, 1.0000) |
| **Connections** | |
| Parent (occ2) | `leg_1_mx28_coxa` |
| Parent path | `leg_1_mx28_coxa:1` |
| Child (occ1) | `leg_1_coxa` |
| Child path | `leg_1_coxa:1` |
| **Geometry (all sources, raw cm)** | |
| occ1.transform | (-10.2347, -15.2347, -1.8000) ctx_depth=0 |
| occ1.global (assembled) | (-10.2347, -15.2347, -1.8000) |
| occ2.transform | (-6.5577, -11.5577, -1.8000) ctx_depth=0 |
| occ2.global (assembled) | (-6.5577, -11.5577, -1.8000) |
| **Picked origin (m)** | (-0.102347, -0.152347, -0.018000) via `occ_one_global` |

#### 🔧 Joint: `Revolute_31` (regular)

| Property | Value |
|---|---|
| Defining component | HexNav (HexNav) |
| Suppressed | False |
| Motion type | revolute (enum=1) |
| Axis | (-0.7071, 0.7071, 0.0000) |
| **Connections** | |
| Parent (occ2) | `leg_1_coxa` |
| Parent path | `leg_1_coxa:1` |
| Child (occ1) | `leg_1_mx28_femur` |
| Child path | `leg_1_mx28_femur:1` |
| **Geometry (all sources, raw cm)** | |
| occ1.transform | (-10.2347, -15.2347, -1.8000) ctx_depth=0 |
| occ1.global (assembled) | (-10.2347, -15.2347, -1.8000) |
| occ2.transform | (-10.2347, -15.2347, -1.8000) ctx_depth=0 |
| occ2.global (assembled) | (-10.2347, -15.2347, -1.8000) |
| **Picked origin (m)** | (-0.102347, -0.152347, -0.018000) via `occ_one_global` |

#### 🔧 Joint: `Revolute_33` (regular)

| Property | Value |
|---|---|
| Defining component | HexNav (HexNav) |
| Suppressed | False |
| Motion type | revolute (enum=1) |
| Axis | (-0.7071, 0.7071, 0.0000) |
| **Connections** | |
| Parent (occ2) | `leg_1_femur` |
| Parent path | `leg_1_femur:1` |
| Child (occ1) | `leg_1_mx28_tibia` |
| Child path | `leg_1_mx28_tibia:1` |
| **Geometry (all sources, raw cm)** | |
| geometryOrOriginTwo | (-16.3016, -18.3318, -3.3000) |
| occ1.transform | (-14.8167, -19.8167, -3.3000) ctx_depth=0 |
| occ1.global (assembled) | (-14.8167, -19.8167, -3.3000) |
| occ2.transform | (-12.7661, -17.7661, -1.8000) ctx_depth=0 |
| occ2.global (assembled) | (-12.7661, -17.7661, -1.8000) |
| **Picked origin (m)** | (-0.148167, -0.198167, -0.033000) via `occ_one_global` |

#### 🔧 Joint: `Revolute_36` (regular)

| Property | Value |
|---|---|
| Defining component | HexNav (HexNav) |
| Suppressed | False |
| Motion type | revolute (enum=1) |
| Axis | (-0.0000, -0.0000, 1.0000) |
| **Connections** | |
| Parent (occ2) | `leg_2_mx28_coxa` |
| Parent path | `leg_2_mx28_coxa:1` |
| Child (occ1) | `leg_2_coxa` |
| Child path | `leg_2_coxa:1` |
| **Geometry (all sources, raw cm)** | |
| occ1.transform | (10.2347, -15.2347, -1.8000) ctx_depth=0 |
| occ1.global (assembled) | (10.2347, -15.2347, -1.8000) |
| occ2.transform | (6.5577, -11.5577, -1.8000) ctx_depth=0 |
| occ2.global (assembled) | (6.5577, -11.5577, -1.8000) |
| **Picked origin (m)** | (0.102347, -0.152347, -0.018000) via `occ_one_global` |

#### 🔧 Joint: `Revolute_37` (regular)

| Property | Value |
|---|---|
| Defining component | HexNav (HexNav) |
| Suppressed | False |
| Motion type | revolute (enum=1) |
| Axis | (-0.7071, -0.7071, -0.0000) |
| **Connections** | |
| Parent (occ2) | `leg_2_coxa` |
| Parent path | `leg_2_coxa:1` |
| Child (occ1) | `leg_2_mx28_femur` |
| Child path | `leg_2_mx28_femur:1` |
| **Geometry (all sources, raw cm)** | |
| occ1.transform | (10.2347, -15.2347, -1.8000) ctx_depth=0 |
| occ1.global (assembled) | (10.2347, -15.2347, -1.8000) |
| occ2.transform | (10.2347, -15.2347, -1.8000) ctx_depth=0 |
| occ2.global (assembled) | (10.2347, -15.2347, -1.8000) |
| **Picked origin (m)** | (0.102347, -0.152347, -0.018000) via `occ_one_global` |

#### 🔧 Joint: `Revolute_39` (regular)

| Property | Value |
|---|---|
| Defining component | HexNav (HexNav) |
| Suppressed | False |
| Motion type | revolute (enum=1) |
| Axis | (-0.7071, -0.7071, -0.0000) |
| **Connections** | |
| Parent (occ2) | `leg_2_femur` |
| Parent path | `leg_2_femur:1` |
| Child (occ1) | `leg_2_mx28_tibia` |
| Child path | `leg_2_mx28_tibia:1` |
| **Geometry (all sources, raw cm)** | |
| geometryOrOriginTwo | (13.3318, -21.3016, -3.3000) |
| occ1.transform | (14.8167, -19.8167, -3.3000) ctx_depth=0 |
| occ1.global (assembled) | (14.8167, -19.8167, -3.3000) |
| occ2.transform | (12.7661, -17.7661, -1.8000) ctx_depth=0 |
| occ2.global (assembled) | (12.7661, -17.7661, -1.8000) |
| **Picked origin (m)** | (0.148167, -0.198167, -0.033000) via `occ_one_global` |

#### 🔧 Joint: `Revolute_42` (regular)

| Property | Value |
|---|---|
| Defining component | HexNav (HexNav) |
| Suppressed | False |
| Motion type | revolute (enum=1) |
| Axis | (-0.0000, 0.0000, 1.0000) |
| **Connections** | |
| Parent (occ2) | `leg_3_mx28_coxa` |
| Parent path | `leg_3_mx28_coxa:1` |
| Child (occ1) | `leg_3_coxa` |
| Child path | `leg_3_coxa:1` |
| **Geometry (all sources, raw cm)** | |
| occ1.transform | (12.1780, -0.0000, -1.8000) ctx_depth=0 |
| occ1.global (assembled) | (12.1780, -0.0000, -1.8000) |
| occ2.transform | (6.9780, -0.0000, -1.8000) ctx_depth=0 |
| occ2.global (assembled) | (6.9780, -0.0000, -1.8000) |
| **Picked origin (m)** | (0.121780, -0.000000, -0.018000) via `occ_one_global` |

#### 🔧 Joint: `Revolute_43` (regular)

| Property | Value |
|---|---|
| Defining component | HexNav (HexNav) |
| Suppressed | False |
| Motion type | revolute (enum=1) |
| Axis | (0.0000, -1.0000, -0.0000) |
| **Connections** | |
| Parent (occ2) | `leg_3_coxa` |
| Parent path | `leg_3_coxa:1` |
| Child (occ1) | `leg_3_mx28_femur` |
| Child path | `leg_3_mx28_femur:1` |
| **Geometry (all sources, raw cm)** | |
| occ1.transform | (12.1780, -0.0000, -1.8000) ctx_depth=0 |
| occ1.global (assembled) | (12.1780, -0.0000, -1.8000) |
| occ2.transform | (12.1780, -0.0000, -1.8000) ctx_depth=0 |
| occ2.global (assembled) | (12.1780, -0.0000, -1.8000) |
| **Picked origin (m)** | (0.121780, -0.000000, -0.018000) via `occ_one_global` |

#### 🔧 Joint: `Revolute_45` (regular)

| Property | Value |
|---|---|
| Defining component | HexNav (HexNav) |
| Suppressed | False |
| Motion type | revolute (enum=1) |
| Axis | (0.0000, -1.0000, -0.0000) |
| **Connections** | |
| Parent (occ2) | `leg_3_femur` |
| Parent path | `leg_3_femur:1` |
| Child (occ1) | `leg_3_mx28_tibia` |
| Child path | `leg_3_mx28_tibia:1` |
| **Geometry (all sources, raw cm)** | |
| geometryOrOriginTwo | (18.6580, -2.1000, -3.3000) |
| occ1.transform | (18.6580, -0.0000, -3.3000) ctx_depth=0 |
| occ1.global (assembled) | (18.6580, -0.0000, -3.3000) |
| occ2.transform | (15.7580, -0.0000, -1.8000) ctx_depth=0 |
| occ2.global (assembled) | (15.7580, -0.0000, -1.8000) |
| **Picked origin (m)** | (0.186580, -0.000000, -0.033000) via `occ_one_global` |

#### 🔧 Joint: `Revolute_48` (regular)

| Property | Value |
|---|---|
| Defining component | HexNav (HexNav) |
| Suppressed | False |
| Motion type | revolute (enum=1) |
| Axis | (-0.0000, 0.0000, 1.0000) |
| **Connections** | |
| Parent (occ2) | `leg_4_mx28_coxa` |
| Parent path | `leg_4_mx28_coxa:1` |
| Child (occ1) | `leg_4_coxa` |
| Child path | `leg_4_coxa:1` |
| **Geometry (all sources, raw cm)** | |
| occ1.transform | (10.2347, 15.2347, -1.8000) ctx_depth=0 |
| occ1.global (assembled) | (10.2347, 15.2347, -1.8000) |
| occ2.transform | (6.5577, 11.5577, -1.8000) ctx_depth=0 |
| occ2.global (assembled) | (6.5577, 11.5577, -1.8000) |
| **Picked origin (m)** | (0.102347, 0.152347, -0.018000) via `occ_one_global` |

#### 🔧 Joint: `Revolute_49` (regular)

| Property | Value |
|---|---|
| Defining component | HexNav (HexNav) |
| Suppressed | False |
| Motion type | revolute (enum=1) |
| Axis | (0.7071, -0.7071, -0.0000) |
| **Connections** | |
| Parent (occ2) | `leg_4_coxa` |
| Parent path | `leg_4_coxa:1` |
| Child (occ1) | `leg_4_mx28_femur` |
| Child path | `leg_4_mx28_femur:1` |
| **Geometry (all sources, raw cm)** | |
| occ1.transform | (10.2347, 15.2347, -1.8000) ctx_depth=0 |
| occ1.global (assembled) | (10.2347, 15.2347, -1.8000) |
| occ2.transform | (10.2347, 15.2347, -1.8000) ctx_depth=0 |
| occ2.global (assembled) | (10.2347, 15.2347, -1.8000) |
| **Picked origin (m)** | (0.102347, 0.152347, -0.018000) via `occ_one_global` |

#### 🔧 Joint: `Revolute_51` (regular)

| Property | Value |
|---|---|
| Defining component | HexNav (HexNav) |
| Suppressed | False |
| Motion type | revolute (enum=1) |
| Axis | (0.7071, -0.7071, -0.0000) |
| **Connections** | |
| Parent (occ2) | `leg_4_femur` |
| Parent path | `leg_4_femur:1` |
| Child (occ1) | `leg_4_mx28_tibia` |
| Child path | `leg_4_mx28_tibia:1` |
| **Geometry (all sources, raw cm)** | |
| geometryOrOriginTwo | (16.3016, 18.3318, -3.3000) |
| occ1.transform | (14.8167, 19.8167, -3.3000) ctx_depth=0 |
| occ1.global (assembled) | (14.8167, 19.8167, -3.3000) |
| occ2.transform | (12.7661, 17.7661, -1.8000) ctx_depth=0 |
| occ2.global (assembled) | (12.7661, 17.7661, -1.8000) |
| **Picked origin (m)** | (0.148167, 0.198167, -0.033000) via `occ_one_global` |

#### 🔧 Joint: `Revolute_54` (regular)

| Property | Value |
|---|---|
| Defining component | HexNav (HexNav) |
| Suppressed | False |
| Motion type | revolute (enum=1) |
| Axis | (-0.0000, 0.0000, 1.0000) |
| **Connections** | |
| Parent (occ2) | `leg_5_mx28_coxa` |
| Parent path | `leg_5_mx28_coxa:1` |
| Child (occ1) | `leg_5_coxa` |
| Child path | `leg_5_coxa:1` |
| **Geometry (all sources, raw cm)** | |
| occ1.transform | (-10.2347, 15.2347, -1.8000) ctx_depth=0 |
| occ1.global (assembled) | (-10.2347, 15.2347, -1.8000) |
| occ2.transform | (-6.5577, 11.5577, -1.8000) ctx_depth=0 |
| occ2.global (assembled) | (-6.5577, 11.5577, -1.8000) |
| **Picked origin (m)** | (-0.102347, 0.152347, -0.018000) via `occ_one_global` |

#### 🔧 Joint: `Revolute_55` (regular)

| Property | Value |
|---|---|
| Defining component | HexNav (HexNav) |
| Suppressed | False |
| Motion type | revolute (enum=1) |
| Axis | (0.7071, 0.7071, 0.0000) |
| **Connections** | |
| Parent (occ2) | `leg_5_coxa` |
| Parent path | `leg_5_coxa:1` |
| Child (occ1) | `leg_5_mx28_femur` |
| Child path | `leg_5_mx28_femur:1` |
| **Geometry (all sources, raw cm)** | |
| occ1.transform | (-10.2347, 15.2347, -1.8000) ctx_depth=0 |
| occ1.global (assembled) | (-10.2347, 15.2347, -1.8000) |
| occ2.transform | (-10.2347, 15.2347, -1.8000) ctx_depth=0 |
| occ2.global (assembled) | (-10.2347, 15.2347, -1.8000) |
| **Picked origin (m)** | (-0.102347, 0.152347, -0.018000) via `occ_one_global` |

#### 🔧 Joint: `Revolute_57` (regular)

| Property | Value |
|---|---|
| Defining component | HexNav (HexNav) |
| Suppressed | False |
| Motion type | revolute (enum=1) |
| Axis | (0.7071, 0.7071, 0.0000) |
| **Connections** | |
| Parent (occ2) | `leg_5_femur` |
| Parent path | `leg_5_femur:1` |
| Child (occ1) | `leg_5_mx28_tibia` |
| Child path | `leg_5_mx28_tibia:1` |
| **Geometry (all sources, raw cm)** | |
| geometryOrOriginTwo | (-13.3318, 21.3016, -3.3000) |
| occ1.transform | (-14.8167, 19.8167, -3.3000) ctx_depth=0 |
| occ1.global (assembled) | (-14.8167, 19.8167, -3.3000) |
| occ2.transform | (-12.7661, 17.7661, -1.8000) ctx_depth=0 |
| occ2.global (assembled) | (-12.7661, 17.7661, -1.8000) |
| **Picked origin (m)** | (-0.148167, 0.198167, -0.033000) via `occ_one_global` |

#### 🔧 Joint: `Revolute_60` (regular)

| Property | Value |
|---|---|
| Defining component | HexNav (HexNav) |
| Suppressed | False |
| Motion type | revolute (enum=1) |
| Axis | (-0.0000, -0.0000, 1.0000) |
| **Connections** | |
| Parent (occ2) | `leg_6_mx28_coxa` |
| Parent path | `leg_6_mx28_coxa:1` |
| Child (occ1) | `leg_6_coxa` |
| Child path | `leg_6_coxa:1` |
| **Geometry (all sources, raw cm)** | |
| occ1.transform | (-12.1780, 0.0000, -1.8000) ctx_depth=0 |
| occ1.global (assembled) | (-12.1780, 0.0000, -1.8000) |
| occ2.transform | (-6.9780, 0.0000, -1.8000) ctx_depth=0 |
| occ2.global (assembled) | (-6.9780, 0.0000, -1.8000) |
| **Picked origin (m)** | (-0.121780, 0.000000, -0.018000) via `occ_one_global` |

#### 🔧 Joint: `Revolute_61` (regular)

| Property | Value |
|---|---|
| Defining component | HexNav (HexNav) |
| Suppressed | False |
| Motion type | revolute (enum=1) |
| Axis | (0.0000, 1.0000, -0.0000) |
| **Connections** | |
| Parent (occ2) | `leg_6_coxa` |
| Parent path | `leg_6_coxa:1` |
| Child (occ1) | `leg_6_mx28_femur` |
| Child path | `leg_6_mx28_femur:1` |
| **Geometry (all sources, raw cm)** | |
| occ1.transform | (-12.1780, 0.0000, -1.8000) ctx_depth=0 |
| occ1.global (assembled) | (-12.1780, 0.0000, -1.8000) |
| occ2.transform | (-12.1780, 0.0000, -1.8000) ctx_depth=0 |
| occ2.global (assembled) | (-12.1780, 0.0000, -1.8000) |
| **Picked origin (m)** | (-0.121780, 0.000000, -0.018000) via `occ_one_global` |

#### 🔧 Joint: `Revolute_63` (regular)

| Property | Value |
|---|---|
| Defining component | HexNav (HexNav) |
| Suppressed | False |
| Motion type | revolute (enum=1) |
| Axis | (0.0000, 1.0000, -0.0000) |
| **Connections** | |
| Parent (occ2) | `leg_6_femur` |
| Parent path | `leg_6_femur:1` |
| Child (occ1) | `leg_6_mx28_tibia` |
| Child path | `leg_6_mx28_tibia:1` |
| **Geometry (all sources, raw cm)** | |
| geometryOrOriginTwo | (-18.6580, 2.1000, -3.3000) |
| occ1.transform | (-18.6580, 0.0000, -3.3000) ctx_depth=0 |
| occ1.global (assembled) | (-18.6580, 0.0000, -3.3000) |
| occ2.transform | (-15.7580, 0.0000, -1.8000) ctx_depth=0 |
| occ2.global (assembled) | (-15.7580, 0.0000, -1.8000) |
| **Picked origin (m)** | (-0.186580, 0.000000, -0.033000) via `occ_one_global` |

#### 🔧 Joint: `Rigid_29` (regular)

| Property | Value |
|---|---|
| Defining component | HexNav (HexNav) |
| Suppressed | False |
| Motion type | rigid (enum=0) |
| Axis | (0.0000, 0.0000, 1.0000) |
| **Connections** | |
| Parent (occ2) | `top` |
| Parent path | `top:1` |
| Child (occ1) | `leg_1_mx28_coxa` |
| Child path | `leg_1_mx28_coxa:1` |
| **Geometry (all sources, raw cm)** | |
| geometryOrOriginTwo | (-5.5324, -8.4111, -0.3000) |
| occ1.transform | (-6.5577, -11.5577, -1.8000) ctx_depth=0 |
| occ1.global (assembled) | (-6.5577, -11.5577, -1.8000) |
| occ2.transform | (-7.6463, -12.6463, -0.1500) ctx_depth=0 |
| occ2.global (assembled) | (-7.6463, -12.6463, -0.1500) |
| **Picked origin (m)** | (-0.065577, -0.115577, -0.018000) via `occ_one_global` |

#### 🔧 Joint: `Rigid_32` (regular)

| Property | Value |
|---|---|
| Defining component | HexNav (HexNav) |
| Suppressed | False |
| Motion type | rigid (enum=0) |
| Axis | (0.0000, 0.0000, 1.0000) |
| **Connections** | |
| Parent (occ2) | `leg_1_mx28_femur` |
| Parent path | `leg_1_mx28_femur:1` |
| Child (occ1) | `leg_1_femur` |
| Child path | `leg_1_femur:1` |
| **Geometry (all sources, raw cm)** | |
| geometryOrOriginOne | (-13.8268, -16.7054, -0.9500) |
| occ1.transform | (-12.7661, -17.7661, -1.8000) ctx_depth=0 |
| occ1.global (assembled) | (-12.7661, -17.7661, -1.8000) |
| occ2.transform | (-10.2347, -15.2347, -1.8000) ctx_depth=0 |
| occ2.global (assembled) | (-10.2347, -15.2347, -1.8000) |
| **Picked origin (m)** | (-0.138268, -0.167054, -0.009500) via `geometryOrOriginOne` |

#### 🔧 Joint: `Rigid_34` (regular)

| Property | Value |
|---|---|
| Defining component | HexNav (HexNav) |
| Suppressed | False |
| Motion type | rigid (enum=0) |
| Axis | (0.0000, 0.0000, 1.0000) |
| **Connections** | |
| Parent (occ2) | `leg_1_mx28_tibia` |
| Parent path | `leg_1_mx28_tibia:1` |
| Child (occ1) | `leg_1_tibia` |
| Child path | `leg_1_tibia:1` |
| **Geometry (all sources, raw cm)** | |
| geometryOrOriginOne | (-16.0816, -23.2029, -4.9500) |
| occ1.transform | (-15.5371, -20.5371, -4.1549) ctx_depth=0 |
| occ1.global (assembled) | (-15.5371, -20.5371, -4.1549) |
| occ2.transform | (-14.8167, -19.8167, -3.3000) ctx_depth=0 |
| occ2.global (assembled) | (-14.8167, -19.8167, -3.3000) |
| **Picked origin (m)** | (-0.160816, -0.232029, -0.049500) via `geometryOrOriginOne` |

#### 🔧 Joint: `Rigid_35` (regular)

| Property | Value |
|---|---|
| Defining component | HexNav (HexNav) |
| Suppressed | False |
| Motion type | rigid (enum=0) |
| Axis | (0.0000, 0.0000, 1.0000) |
| **Connections** | |
| Parent (occ2) | `top` |
| Parent path | `top:1` |
| Child (occ1) | `leg_2_mx28_coxa` |
| Child path | `leg_2_mx28_coxa:1` |
| **Geometry (all sources, raw cm)** | |
| geometryOrOriginTwo | (4.6273, -8.4252, -0.3000) |
| occ1.transform | (6.5577, -11.5577, -1.8000) ctx_depth=0 |
| occ1.global (assembled) | (6.5577, -11.5577, -1.8000) |
| occ2.transform | (-7.6463, -12.6463, -0.1500) ctx_depth=0 |
| occ2.global (assembled) | (-7.6463, -12.6463, -0.1500) |
| **Picked origin (m)** | (0.065577, -0.115577, -0.018000) via `occ_one_global` |

#### 🔧 Joint: `Rigid_38` (regular)

| Property | Value |
|---|---|
| Defining component | HexNav (HexNav) |
| Suppressed | False |
| Motion type | rigid (enum=0) |
| Axis | (0.0000, 0.0000, 1.0000) |
| **Connections** | |
| Parent (occ2) | `leg_2_mx28_femur` |
| Parent path | `leg_2_mx28_femur:1` |
| Child (occ1) | `leg_2_femur` |
| Child path | `leg_2_femur:1` |
| **Geometry (all sources, raw cm)** | |
| geometryOrOriginOne | (13.8268, -16.7054, -0.9500) |
| occ1.transform | (12.7661, -17.7661, -1.8000) ctx_depth=0 |
| occ1.global (assembled) | (12.7661, -17.7661, -1.8000) |
| occ2.transform | (10.2347, -15.2347, -1.8000) ctx_depth=0 |
| occ2.global (assembled) | (10.2347, -15.2347, -1.8000) |
| **Picked origin (m)** | (0.138268, -0.167054, -0.009500) via `geometryOrOriginOne` |

#### 🔧 Joint: `Rigid_40` (regular)

| Property | Value |
|---|---|
| Defining component | HexNav (HexNav) |
| Suppressed | False |
| Motion type | rigid (enum=0) |
| Axis | (0.0000, 0.0000, 1.0000) |
| **Connections** | |
| Parent (occ2) | `leg_2_mx28_tibia` |
| Parent path | `leg_2_mx28_tibia:1` |
| Child (occ1) | `leg_2_tibia` |
| Child path | `leg_2_tibia:1` |
| **Geometry (all sources, raw cm)** | |
| geometryOrOriginOne | (16.0358, -23.1571, -4.0472) |
| occ1.transform | (15.5371, -20.5371, -4.1549) ctx_depth=0 |
| occ1.global (assembled) | (15.5371, -20.5371, -4.1549) |
| occ2.transform | (14.8167, -19.8167, -3.3000) ctx_depth=0 |
| occ2.global (assembled) | (14.8167, -19.8167, -3.3000) |
| **Picked origin (m)** | (0.160358, -0.231571, -0.040472) via `geometryOrOriginOne` |

#### 🔧 Joint: `Rigid_41` (regular)

| Property | Value |
|---|---|
| Defining component | HexNav (HexNav) |
| Suppressed | False |
| Motion type | rigid (enum=0) |
| Axis | (0.0000, 0.0000, 1.0000) |
| **Connections** | |
| Parent (occ2) | `top` |
| Parent path | `top:1` |
| Child (occ1) | `leg_3_mx28_coxa` |
| Child path | `leg_3_mx28_coxa:1` |
| **Geometry (all sources, raw cm)** | |
| geometryOrOriginTwo | (3.3980, 0.8500, -0.3000) |
| occ1.transform | (6.9780, -0.0000, -1.8000) ctx_depth=0 |
| occ1.global (assembled) | (6.9780, -0.0000, -1.8000) |
| occ2.transform | (-7.6463, -12.6463, -0.1500) ctx_depth=0 |
| occ2.global (assembled) | (-7.6463, -12.6463, -0.1500) |
| **Picked origin (m)** | (0.069780, -0.000000, -0.018000) via `occ_one_global` |

#### 🔧 Joint: `Rigid_44` (regular)

| Property | Value |
|---|---|
| Defining component | HexNav (HexNav) |
| Suppressed | False |
| Motion type | rigid (enum=0) |
| Axis | (0.0000, 0.0000, 1.0000) |
| **Connections** | |
| Parent (occ2) | `leg_3_mx28_femur` |
| Parent path | `leg_3_mx28_femur:1` |
| Child (occ1) | `leg_3_femur` |
| Child path | `leg_3_femur:1` |
| **Geometry (all sources, raw cm)** | |
| geometryOrOriginOne | (15.7580, -1.5000, -0.9500) |
| occ1.transform | (15.7580, -0.0000, -1.8000) ctx_depth=0 |
| occ1.global (assembled) | (15.7580, -0.0000, -1.8000) |
| occ2.transform | (12.1780, -0.0000, -1.8000) ctx_depth=0 |
| occ2.global (assembled) | (12.1780, -0.0000, -1.8000) |
| **Picked origin (m)** | (0.157580, -0.015000, -0.009500) via `geometryOrOriginOne` |

#### 🔧 Joint: `Rigid_46` (regular)

| Property | Value |
|---|---|
| Defining component | HexNav (HexNav) |
| Suppressed | False |
| Motion type | rigid (enum=0) |
| Axis | (0.0000, 0.0000, 1.0000) |
| **Connections** | |
| Parent (occ2) | `leg_3_mx28_tibia` |
| Parent path | `leg_3_mx28_tibia:1` |
| Child (occ1) | `leg_3_tibia` |
| Child path | `leg_3_tibia:1` |
| **Geometry (all sources, raw cm)** | |
| geometryOrOriginOne | (21.8820, -1.5000, -4.0472) |
| occ1.transform | (19.6768, -0.0000, -4.1549) ctx_depth=0 |
| occ1.global (assembled) | (19.6768, -0.0000, -4.1549) |
| occ2.transform | (18.6580, -0.0000, -3.3000) ctx_depth=0 |
| occ2.global (assembled) | (18.6580, -0.0000, -3.3000) |
| **Picked origin (m)** | (0.218820, -0.015000, -0.040472) via `geometryOrOriginOne` |

#### 🔧 Joint: `Rigid_47` (regular)

| Property | Value |
|---|---|
| Defining component | HexNav (HexNav) |
| Suppressed | False |
| Motion type | rigid (enum=0) |
| Axis | (0.0000, 0.0000, 1.0000) |
| **Connections** | |
| Parent (occ2) | `top` |
| Parent path | `top:1` |
| Child (occ1) | `leg_4_mx28_coxa` |
| Child path | `leg_4_mx28_coxa:1` |
| **Geometry (all sources, raw cm)** | |
| geometryOrOriginTwo | (3.4252, 9.6273, -0.3000) |
| occ1.transform | (6.5577, 11.5577, -1.8000) ctx_depth=0 |
| occ1.global (assembled) | (6.5577, 11.5577, -1.8000) |
| occ2.transform | (-7.6463, -12.6463, -0.1500) ctx_depth=0 |
| occ2.global (assembled) | (-7.6463, -12.6463, -0.1500) |
| **Picked origin (m)** | (0.065577, 0.115577, -0.018000) via `occ_one_global` |

#### 🔧 Joint: `Rigid_50` (regular)

| Property | Value |
|---|---|
| Defining component | HexNav (HexNav) |
| Suppressed | False |
| Motion type | rigid (enum=0) |
| Axis | (0.0000, 0.0000, 1.0000) |
| **Connections** | |
| Parent (occ2) | `leg_4_mx28_femur` |
| Parent path | `leg_4_mx28_femur:1` |
| Child (occ1) | `leg_4_femur` |
| Child path | `leg_4_femur:1` |
| **Geometry (all sources, raw cm)** | |
| geometryOrOriginOne | (13.8268, 16.7054, -0.9500) |
| occ1.transform | (12.7661, 17.7661, -1.8000) ctx_depth=0 |
| occ1.global (assembled) | (12.7661, 17.7661, -1.8000) |
| occ2.transform | (10.2347, 15.2347, -1.8000) ctx_depth=0 |
| occ2.global (assembled) | (10.2347, 15.2347, -1.8000) |
| **Picked origin (m)** | (0.138268, 0.167054, -0.009500) via `geometryOrOriginOne` |

#### 🔧 Joint: `Rigid_52` (regular)

| Property | Value |
|---|---|
| Defining component | HexNav (HexNav) |
| Suppressed | False |
| Motion type | rigid (enum=0) |
| Axis | (0.0000, 0.0000, 1.0000) |
| **Connections** | |
| Parent (occ2) | `leg_4_mx28_tibia` |
| Parent path | `leg_4_mx28_tibia:1` |
| Child (occ1) | `leg_4_tibia` |
| Child path | `leg_4_tibia:1` |
| **Geometry (all sources, raw cm)** | |
| geometryOrOriginOne | (18.1571, 21.0358, -4.0472) |
| occ1.transform | (15.5371, 20.5371, -4.1549) ctx_depth=0 |
| occ1.global (assembled) | (15.5371, 20.5371, -4.1549) |
| occ2.transform | (14.8167, 19.8167, -3.3000) ctx_depth=0 |
| occ2.global (assembled) | (14.8167, 19.8167, -3.3000) |
| **Picked origin (m)** | (0.181571, 0.210358, -0.040472) via `geometryOrOriginOne` |

#### 🔧 Joint: `Rigid_53` (regular)

| Property | Value |
|---|---|
| Defining component | HexNav (HexNav) |
| Suppressed | False |
| Motion type | rigid (enum=0) |
| Axis | (0.0000, 0.0000, 1.0000) |
| **Connections** | |
| Parent (occ2) | `top` |
| Parent path | `top:1` |
| Child (occ1) | `leg_5_mx28_coxa` |
| Child path | `leg_5_mx28_coxa:1` |
| **Geometry (all sources, raw cm)** | |
| geometryOrOriginTwo | (-4.6273, 8.4252, -0.3000) |
| occ1.transform | (-6.5577, 11.5577, -1.8000) ctx_depth=0 |
| occ1.global (assembled) | (-6.5577, 11.5577, -1.8000) |
| occ2.transform | (-7.6463, -12.6463, -0.1500) ctx_depth=0 |
| occ2.global (assembled) | (-7.6463, -12.6463, -0.1500) |
| **Picked origin (m)** | (-0.065577, 0.115577, -0.018000) via `occ_one_global` |

#### 🔧 Joint: `Rigid_56` (regular)

| Property | Value |
|---|---|
| Defining component | HexNav (HexNav) |
| Suppressed | False |
| Motion type | rigid (enum=0) |
| Axis | (0.0000, 0.0000, 1.0000) |
| **Connections** | |
| Parent (occ2) | `leg_5_mx28_femur` |
| Parent path | `leg_5_mx28_femur:1` |
| Child (occ1) | `leg_5_femur` |
| Child path | `leg_5_femur:1` |
| **Geometry (all sources, raw cm)** | |
| geometryOrOriginOne | (-11.7054, 18.8268, -0.9500) |
| occ1.transform | (-12.7661, 17.7661, -1.8000) ctx_depth=0 |
| occ1.global (assembled) | (-12.7661, 17.7661, -1.8000) |
| occ2.transform | (-10.2347, 15.2347, -1.8000) ctx_depth=0 |
| occ2.global (assembled) | (-10.2347, 15.2347, -1.8000) |
| **Picked origin (m)** | (-0.117054, 0.188268, -0.009500) via `geometryOrOriginOne` |

#### 🔧 Joint: `Rigid_58` (regular)

| Property | Value |
|---|---|
| Defining component | HexNav (HexNav) |
| Suppressed | False |
| Motion type | rigid (enum=0) |
| Axis | (0.0000, 0.0000, 1.0000) |
| **Connections** | |
| Parent (occ2) | `leg_5_mx28_tibia` |
| Parent path | `leg_5_mx28_tibia:1` |
| Child (occ1) | `leg_5_tibia` |
| Child path | `leg_5_tibia:1` |
| **Geometry (all sources, raw cm)** | |
| geometryOrOriginOne | (-16.0358, 23.1571, -4.0472) |
| occ1.transform | (-15.5371, 20.5371, -4.1549) ctx_depth=0 |
| occ1.global (assembled) | (-15.5371, 20.5371, -4.1549) |
| occ2.transform | (-14.8167, 19.8167, -3.3000) ctx_depth=0 |
| occ2.global (assembled) | (-14.8167, 19.8167, -3.3000) |
| **Picked origin (m)** | (-0.160358, 0.231571, -0.040472) via `geometryOrOriginOne` |

#### 🔧 Joint: `Rigid_59` (regular)

| Property | Value |
|---|---|
| Defining component | HexNav (HexNav) |
| Suppressed | False |
| Motion type | rigid (enum=0) |
| Axis | (0.0000, 0.0000, 1.0000) |
| **Connections** | |
| Parent (occ2) | `top` |
| Parent path | `top:1` |
| Child (occ1) | `leg_6_mx28_coxa` |
| Child path | `leg_6_mx28_coxa:1` |
| **Geometry (all sources, raw cm)** | |
| geometryOrOriginTwo | (-3.3980, -0.8500, -0.3000) |
| occ1.transform | (-6.9780, 0.0000, -1.8000) ctx_depth=0 |
| occ1.global (assembled) | (-6.9780, 0.0000, -1.8000) |
| occ2.transform | (-7.6463, -12.6463, -0.1500) ctx_depth=0 |
| occ2.global (assembled) | (-7.6463, -12.6463, -0.1500) |
| **Picked origin (m)** | (-0.069780, 0.000000, -0.018000) via `occ_one_global` |

#### 🔧 Joint: `Rigid_62` (regular)

| Property | Value |
|---|---|
| Defining component | HexNav (HexNav) |
| Suppressed | False |
| Motion type | rigid (enum=0) |
| Axis | (0.0000, 0.0000, 1.0000) |
| **Connections** | |
| Parent (occ2) | `leg_6_mx28_femur` |
| Parent path | `leg_6_mx28_femur:1` |
| Child (occ1) | `leg_6_femur` |
| Child path | `leg_6_femur:1` |
| **Geometry (all sources, raw cm)** | |
| geometryOrOriginOne | (-15.7580, 1.5000, -0.9500) |
| occ1.transform | (-15.7580, 0.0000, -1.8000) ctx_depth=0 |
| occ1.global (assembled) | (-15.7580, 0.0000, -1.8000) |
| occ2.transform | (-12.1780, 0.0000, -1.8000) ctx_depth=0 |
| occ2.global (assembled) | (-12.1780, 0.0000, -1.8000) |
| **Picked origin (m)** | (-0.157580, 0.015000, -0.009500) via `geometryOrOriginOne` |

#### 🔧 Joint: `Rigid_64` (regular)

| Property | Value |
|---|---|
| Defining component | HexNav (HexNav) |
| Suppressed | False |
| Motion type | rigid (enum=0) |
| Axis | (0.0000, 0.0000, 1.0000) |
| **Connections** | |
| Parent (occ2) | `leg_6_mx28_tibia` |
| Parent path | `leg_6_mx28_tibia:1` |
| Child (occ1) | `leg_6_tibia` |
| Child path | `leg_6_tibia:1` |
| **Geometry (all sources, raw cm)** | |
| geometryOrOriginOne | (-21.8820, 1.5000, -4.0472) |
| occ1.transform | (-19.6768, 0.0000, -4.1549) ctx_depth=0 |
| occ1.global (assembled) | (-19.6768, 0.0000, -4.1549) |
| occ2.transform | (-18.6580, 0.0000, -3.3000) ctx_depth=0 |
| occ2.global (assembled) | (-18.6580, 0.0000, -3.3000) |
| **Picked origin (m)** | (-0.218820, 0.015000, -0.040472) via `geometryOrOriginOne` |

#### 🔧 Joint: `Rigid_65` (regular)

| Property | Value |
|---|---|
| Defining component | HexNav (HexNav) |
| Suppressed | False |
| Motion type | rigid (enum=0) |
| Axis | (0.0000, 0.0000, 1.0000) |
| **Connections** | |
| Parent (occ2) | `leg_5_mx28_coxa` |
| Parent path | `leg_5_mx28_coxa:1` |
| Child (occ1) | `bot` |
| Child path | `bot:1` |
| **Geometry (all sources, raw cm)** | |
| geometryOrOriginOne | (-4.6132, 11.7345, -3.3000) |
| occ1.transform | (7.6463, -12.6463, -3.3000) ctx_depth=0 |
| occ1.global (assembled) | (7.6463, -12.6463, -3.3000) |
| occ2.transform | (-6.5577, 11.5577, -1.8000) ctx_depth=0 |
| occ2.global (assembled) | (-6.5577, 11.5577, -1.8000) |
| **Picked origin (m)** | (-0.046132, 0.117345, -0.033000) via `geometryOrOriginOne` |

## Quick Comparison Table

Compare these values with Fusion 360 Properties panel (right-click → Properties).

| Component | Mass (g) | World X,Y,Z (mm) | CoM X,Y,Z (mm) | Material |
|---|---|---|---|---|
| bot | 241.313 | (76.46, -126.46, -33.00) | (152.93, 0.00, -31.59) | Steel |
| leg_1_coxa | 192.968 | (-102.35, -152.35, -18.00) | (-128.35, -152.35, -18.00) | Steel |
| leg_1_femur | 127.034 | (-127.66, -177.66, -18.00) | (-125.45, -166.33, -18.00) | Steel |
| leg_1_mx28_coxa | 73.932 | (-65.58, -115.58, -18.00) | (-65.58, -126.79, -17.51) | custom_materials_MX_28 |
| leg_1_mx28_femur | 73.932 | (-102.35, -152.35, -18.00) | (-102.35, -163.56, -17.51) | custom_materials_MX_28 |
| leg_1_mx28_tibia | 73.932 | (-148.17, -198.17, -33.00) | (-148.17, -209.38, -32.51) | custom_materials_MX_28 |
| leg_1_tibia | 154.962 | (-155.37, -205.37, -41.55) | (-205.16, -248.83, -41.55) | Steel |
| leg_2_coxa | 192.968 | (102.35, -152.35, -18.00) | (76.34, -152.35, -18.00) | Steel |
| leg_2_femur | 127.034 | (127.66, -177.66, -18.00) | (129.87, -166.33, -18.00) | Steel |
| leg_2_mx28_coxa | 73.932 | (65.58, -115.58, -18.00) | (65.58, -126.79, -17.51) | custom_materials_MX_28 |
| leg_2_mx28_femur | 73.932 | (102.35, -152.35, -18.00) | (102.35, -163.56, -17.51) | custom_materials_MX_28 |
| leg_2_mx28_tibia | 73.932 | (148.17, -198.17, -33.00) | (148.17, -209.38, -32.51) | custom_materials_MX_28 |
| leg_2_tibia | 154.962 | (155.37, -205.37, -41.55) | (105.58, -248.83, -41.55) | Steel |
| leg_3_coxa | 192.968 | (121.78, -0.00, -18.00) | (95.77, 0.00, -18.00) | Steel |
| leg_3_femur | 127.034 | (157.58, -0.00, -18.00) | (159.79, 11.33, -18.00) | Steel |
| leg_3_mx28_coxa | 73.932 | (69.78, -0.00, -18.00) | (69.78, -11.21, -17.51) | custom_materials_MX_28 |
| leg_3_mx28_femur | 73.932 | (121.78, -0.00, -18.00) | (121.78, -11.21, -17.51) | custom_materials_MX_28 |
| leg_3_mx28_tibia | 73.932 | (186.58, -0.00, -33.00) | (186.58, -11.21, -32.51) | custom_materials_MX_28 |
| leg_3_tibia | 154.962 | (196.77, -0.00, -41.55) | (146.98, -43.46, -41.55) | Steel |
| leg_4_coxa | 192.968 | (102.35, 152.35, -18.00) | (76.34, 152.35, -18.00) | Steel |
| leg_4_femur | 127.034 | (127.66, 177.66, -18.00) | (129.87, 188.99, -18.00) | Steel |
| leg_4_mx28_coxa | 73.932 | (65.58, 115.58, -18.00) | (65.58, 104.37, -17.51) | custom_materials_MX_28 |
| leg_4_mx28_femur | 73.932 | (102.35, 152.35, -18.00) | (102.35, 141.14, -17.51) | custom_materials_MX_28 |
| leg_4_mx28_tibia | 73.932 | (148.17, 198.17, -33.00) | (148.17, 186.96, -32.51) | custom_materials_MX_28 |
| leg_4_tibia | 154.962 | (155.37, 205.37, -41.55) | (105.58, 161.91, -41.55) | Steel |
| leg_5_coxa | 192.968 | (-102.35, 152.35, -18.00) | (-128.35, 152.35, -18.00) | Steel |
| leg_5_femur | 127.034 | (-127.66, 177.66, -18.00) | (-125.45, 188.99, -18.00) | Steel |
| leg_5_mx28_coxa | 73.932 | (-65.58, 115.58, -18.00) | (-65.58, 104.37, -17.51) | custom_materials_MX_28 |
| leg_5_mx28_femur | 73.932 | (-102.35, 152.35, -18.00) | (-102.35, 141.14, -17.51) | custom_materials_MX_28 |
| leg_5_mx28_tibia | 73.932 | (-148.17, 198.17, -33.00) | (-148.17, 186.96, -32.51) | custom_materials_MX_28 |
| leg_5_tibia | 154.962 | (-155.37, 205.37, -41.55) | (-205.16, 161.91, -41.55) | Steel |
| leg_6_coxa | 192.968 | (-121.78, 0.00, -18.00) | (-147.79, 0.00, -18.00) | Steel |
| leg_6_femur | 127.034 | (-157.58, 0.00, -18.00) | (-155.37, 11.33, -18.00) | Steel |
| leg_6_mx28_coxa | 73.932 | (-69.78, 0.00, -18.00) | (-69.78, -11.21, -17.51) | custom_materials_MX_28 |
| leg_6_mx28_femur | 73.932 | (-121.78, 0.00, -18.00) | (-121.78, -11.21, -17.51) | custom_materials_MX_28 |
| leg_6_mx28_tibia | 73.932 | (-186.58, 0.00, -33.00) | (-186.58, -11.21, -32.51) | custom_materials_MX_28 |
| leg_6_tibia | 154.962 | (-196.77, 0.00, -41.55) | (-246.56, -43.46, -41.55) | Steel |
| top | 241.307 | (-76.46, -126.46, -1.50) | (0.00, 0.00, -1.59) | Steel |

## Joint Origins Comparison

All origins shown in multiple coordinate systems for debugging.

| Joint | Source | Origin (cm, raw) | Origin (m, picked) | Motion | Axis |
|---|---|---|---|---|---|
| Revolute_30 | occ_one_global | ctx(-10.23, -15.23, -1.80) | (-0.1023, -0.1523, -0.0180) | revolute | (-0.0, -0.0, 1.0) |
| Revolute_31 | occ_one_global | ctx(-10.23, -15.23, -1.80) | (-0.1023, -0.1523, -0.0180) | revolute | (-0.7, 0.7, 0.0) |
| Revolute_33 | occ_one_global | ctx(-14.82, -19.82, -3.30) | (-0.1482, -0.1982, -0.0330) | revolute | (-0.7, 0.7, 0.0) |
| Revolute_36 | occ_one_global | ctx(10.23, -15.23, -1.80) | (0.1023, -0.1523, -0.0180) | revolute | (-0.0, -0.0, 1.0) |
| Revolute_37 | occ_one_global | ctx(10.23, -15.23, -1.80) | (0.1023, -0.1523, -0.0180) | revolute | (-0.7, -0.7, -0.0) |
| Revolute_39 | occ_one_global | ctx(14.82, -19.82, -3.30) | (0.1482, -0.1982, -0.0330) | revolute | (-0.7, -0.7, -0.0) |
| Revolute_42 | occ_one_global | ctx(12.18, -0.00, -1.80) | (0.1218, -0.0000, -0.0180) | revolute | (-0.0, 0.0, 1.0) |
| Revolute_43 | occ_one_global | ctx(12.18, -0.00, -1.80) | (0.1218, -0.0000, -0.0180) | revolute | (0.0, -1.0, -0.0) |
| Revolute_45 | occ_one_global | ctx(18.66, -0.00, -3.30) | (0.1866, -0.0000, -0.0330) | revolute | (0.0, -1.0, -0.0) |
| Revolute_48 | occ_one_global | ctx(10.23, 15.23, -1.80) | (0.1023, 0.1523, -0.0180) | revolute | (-0.0, 0.0, 1.0) |
| Revolute_49 | occ_one_global | ctx(10.23, 15.23, -1.80) | (0.1023, 0.1523, -0.0180) | revolute | (0.7, -0.7, -0.0) |
| Revolute_51 | occ_one_global | ctx(14.82, 19.82, -3.30) | (0.1482, 0.1982, -0.0330) | revolute | (0.7, -0.7, -0.0) |
| Revolute_54 | occ_one_global | ctx(-10.23, 15.23, -1.80) | (-0.1023, 0.1523, -0.0180) | revolute | (-0.0, 0.0, 1.0) |
| Revolute_55 | occ_one_global | ctx(-10.23, 15.23, -1.80) | (-0.1023, 0.1523, -0.0180) | revolute | (0.7, 0.7, 0.0) |
| Revolute_57 | occ_one_global | ctx(-14.82, 19.82, -3.30) | (-0.1482, 0.1982, -0.0330) | revolute | (0.7, 0.7, 0.0) |
| Revolute_60 | occ_one_global | ctx(-12.18, 0.00, -1.80) | (-0.1218, 0.0000, -0.0180) | revolute | (-0.0, -0.0, 1.0) |
| Revolute_61 | occ_one_global | ctx(-12.18, 0.00, -1.80) | (-0.1218, 0.0000, -0.0180) | revolute | (0.0, 1.0, -0.0) |
| Revolute_63 | occ_one_global | ctx(-18.66, 0.00, -3.30) | (-0.1866, 0.0000, -0.0330) | revolute | (0.0, 1.0, -0.0) |
| Rigid_29 | occ_one_global | ctx(-6.56, -11.56, -1.80) | (-0.0656, -0.1156, -0.0180) | rigid | (0.0, 0.0, 1.0) |
| Rigid_32 | geometryOrOriginOne | goo1(-13.83, -16.71, -0.95) | (-0.1383, -0.1671, -0.0095) | rigid | (0.0, 0.0, 1.0) |
| Rigid_34 | geometryOrOriginOne | goo1(-16.08, -23.20, -4.95) | (-0.1608, -0.2320, -0.0495) | rigid | (0.0, 0.0, 1.0) |
| Rigid_35 | occ_one_global | ctx(6.56, -11.56, -1.80) | (0.0656, -0.1156, -0.0180) | rigid | (0.0, 0.0, 1.0) |
| Rigid_38 | geometryOrOriginOne | goo1(13.83, -16.71, -0.95) | (0.1383, -0.1671, -0.0095) | rigid | (0.0, 0.0, 1.0) |
| Rigid_40 | geometryOrOriginOne | goo1(16.04, -23.16, -4.05) | (0.1604, -0.2316, -0.0405) | rigid | (0.0, 0.0, 1.0) |
| Rigid_41 | occ_one_global | ctx(6.98, -0.00, -1.80) | (0.0698, -0.0000, -0.0180) | rigid | (0.0, 0.0, 1.0) |
| Rigid_44 | geometryOrOriginOne | goo1(15.76, -1.50, -0.95) | (0.1576, -0.0150, -0.0095) | rigid | (0.0, 0.0, 1.0) |
| Rigid_46 | geometryOrOriginOne | goo1(21.88, -1.50, -4.05) | (0.2188, -0.0150, -0.0405) | rigid | (0.0, 0.0, 1.0) |
| Rigid_47 | occ_one_global | ctx(6.56, 11.56, -1.80) | (0.0656, 0.1156, -0.0180) | rigid | (0.0, 0.0, 1.0) |
| Rigid_50 | geometryOrOriginOne | goo1(13.83, 16.71, -0.95) | (0.1383, 0.1671, -0.0095) | rigid | (0.0, 0.0, 1.0) |
| Rigid_52 | geometryOrOriginOne | goo1(18.16, 21.04, -4.05) | (0.1816, 0.2104, -0.0405) | rigid | (0.0, 0.0, 1.0) |
| Rigid_53 | occ_one_global | ctx(-6.56, 11.56, -1.80) | (-0.0656, 0.1156, -0.0180) | rigid | (0.0, 0.0, 1.0) |
| Rigid_56 | geometryOrOriginOne | goo1(-11.71, 18.83, -0.95) | (-0.1171, 0.1883, -0.0095) | rigid | (0.0, 0.0, 1.0) |
| Rigid_58 | geometryOrOriginOne | goo1(-16.04, 23.16, -4.05) | (-0.1604, 0.2316, -0.0405) | rigid | (0.0, 0.0, 1.0) |
| Rigid_59 | occ_one_global | ctx(-6.98, 0.00, -1.80) | (-0.0698, 0.0000, -0.0180) | rigid | (0.0, 0.0, 1.0) |
| Rigid_62 | geometryOrOriginOne | goo1(-15.76, 1.50, -0.95) | (-0.1576, 0.0150, -0.0095) | rigid | (0.0, 0.0, 1.0) |
| Rigid_64 | geometryOrOriginOne | goo1(-21.88, 1.50, -4.05) | (-0.2188, 0.0150, -0.0405) | rigid | (0.0, 0.0, 1.0) |
| Rigid_65 | geometryOrOriginOne | goo1(-4.61, 11.73, -3.30) | (-0.0461, 0.1173, -0.0330) | rigid | (0.0, 0.0, 1.0) |
