vitormhenrique/hexapod/docs/dimensions.md

measured on the cad, this is the source of truth of the dimensions

Size of coxa  52.00 mm
Size of  femur 66.513 mm
Size of  tibia 114.213 mm

The offset for the center legs, legs 3 and 6 should be in x,y coordinates (0,-69.78) and (0,+69.78)

The offset from the leg number 1 (115.577,65.577)
The offset from the leg number 2 (115.577,-65.577)
The offset from the leg number 4 (-115.577,-65.577)
The offset from the leg number 5 (-115.577,65.577)

Assuming x is towards the front of the robot, and y to the left.

Consider the center of the robot the middle of the top and bottom planes.

With all servos centered the distance between the center of hexapod and the center of legs 3 and 6 are 236.60 mm coordinates X,Y,Z are (0, 196.534 mm, -131.734 mm)

With all servos centered the distance between the center of the robot and the tip of leg 1 is 289.053 mm, coordinates X,Y,Z are (205.205, 155.205, -131.734)

for leg 6 coordinates from the center to the center of coxa rotation (0,69.78,0)
for leg 6 coordinates from the center to the center of femur rotation (0,121.78,0)
for leg 6 coordinates from the center to the center of tibia rotation (0,186.58,-15.00)
for leg 6 coordinates from the center to the tip of the leg (0,196.534,131.734)

for leg 1 coordinates from the center to the center of coxa rotation (115.577 mm, 65.577 mm,0)
for leg 1 coordinates from the center to the center of femur rotation  (152.347 mm, 102.347 mm , 0)
for leg 1 coordinates from the center to the center of tibia rotation (198.167 mm, 148.167 mm, -15)
for leg 1 coordinates from the center to the tip of the leg (205.205 mm,155.205 mm, -131.734 mm)
