vitormhenrique/hexapod/robot_ros_simulation/HexNav_description/images/robot.png

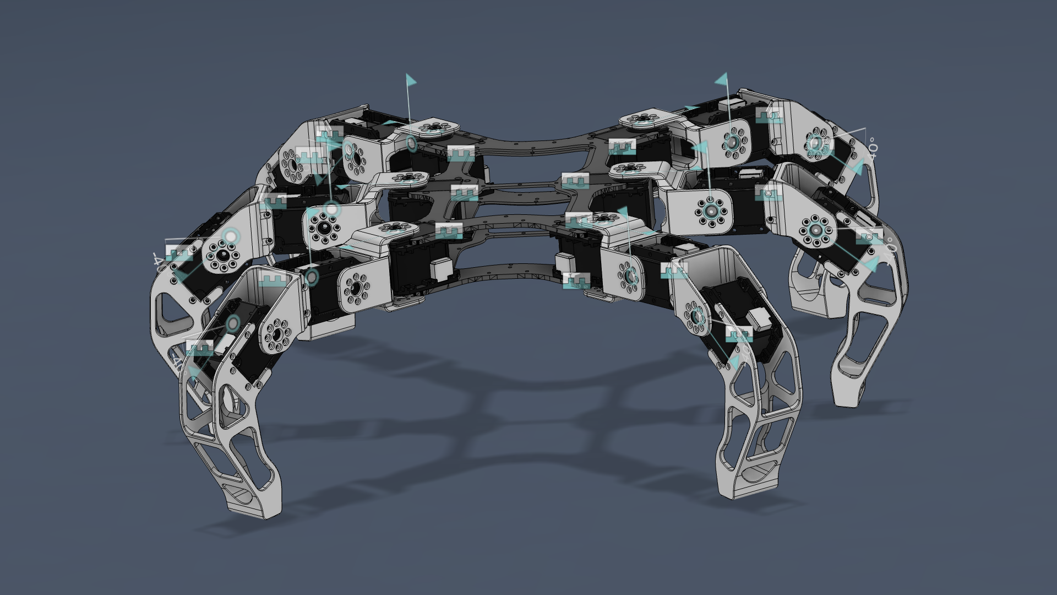
robot_ros_simulation/HexNav_description/images/robot.png
