vitormhenrique/hexapod/parts/5626 PCA9548 Stemma.step

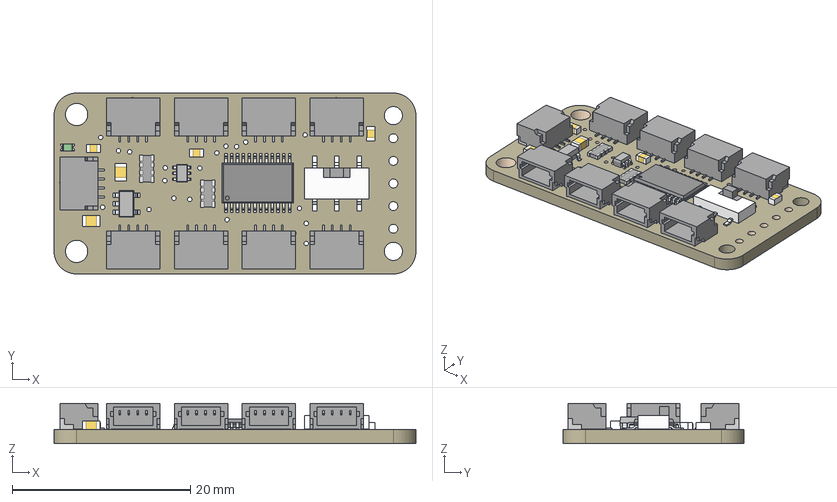
[picture p6: CAD file, 2026-06-27]
parts/5626 PCA9548 Stemma.step
40.6 x 20.3 x 4.53 mm
Board
xCA9548APWR
10K x 3
10uF x 2
AP2112K-3.3
10K Pack x 2
BSS138
STEMMA_I2C_QT x 9
GREEN
AYZ0202AGRLC
