vitormhenrique/hexapod/robot_ros_simulation/HexNav_description/meshes/HexNav/leg_3_mx28_coxa_collision.stl

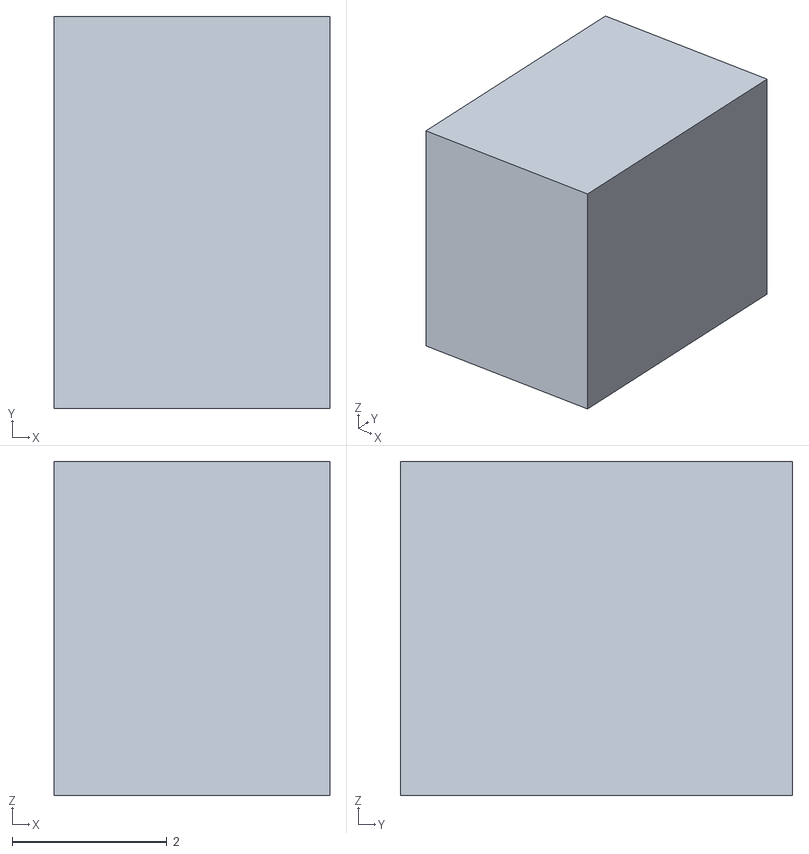
[picture p7: CAD file, 2026-06-25]
robot_ros_simulation/HexNav_description/meshes/HexNav/leg_3_mx28_coxa_collision.stl
3.56 x 5.06 x 4.31
