vitormhenrique/hexapod/parts/2472 BNO055 Breakout.step

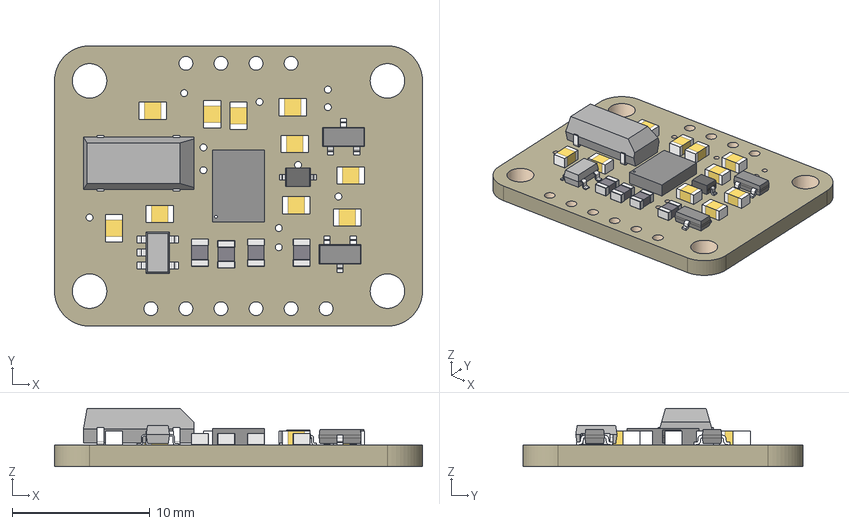
[picture p8: CAD file, 2026-06-27]
parts/2472 BNO055 Breakout.step
26.7 x 20.3 x 4.23 mm
Board
BNO055
10K x 10
32.768kHz
10uF x 2
BSS138 x 2
10K_1 x 2
MIC5225-3.3
1n4148
