vitormhenrique/hexapod/robot_ros_simulation/HexNav_description/meshes/HexNav/leg_1_femur_collision.stl

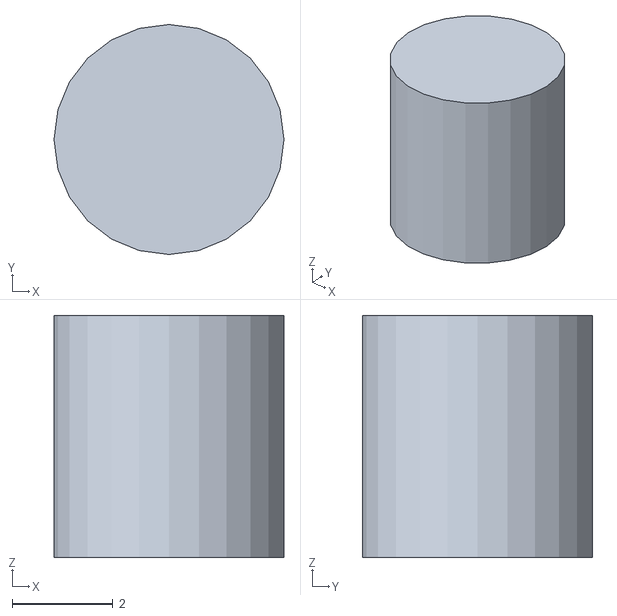
[picture p9: CAD file, 2026-06-25]
robot_ros_simulation/HexNav_description/meshes/HexNav/leg_1_femur_collision.stl
4.55 x 4.55 x 4.80
