vitormhenrique/hexapod/parts/5625 Stemma 5 Port Hub.step

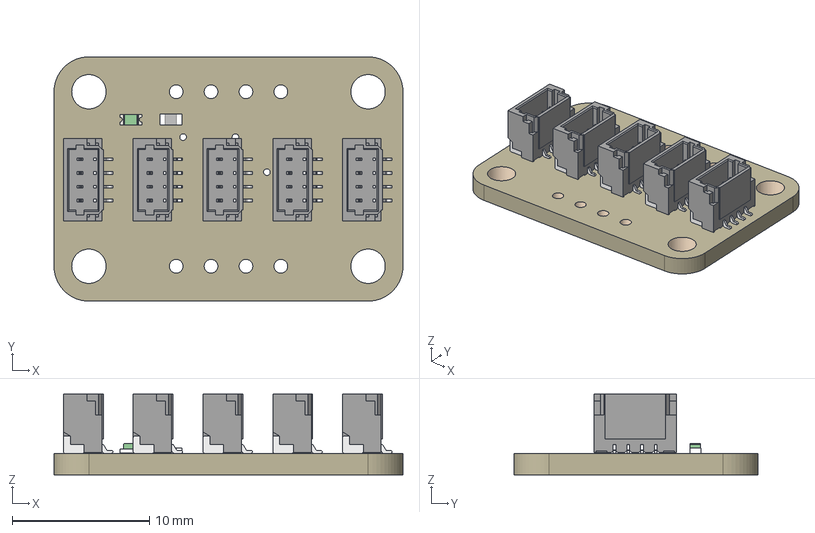
[picture p10: CAD file, 2026-06-27]
parts/5625 Stemma 5 Port Hub.step
25.4 x 17.8 x 5.87 mm
Board
STEMMA_I2C_QTRA x 5
GREEN
10K
