vitormhenrique/hexapod/parts/Qwiic Mux.step

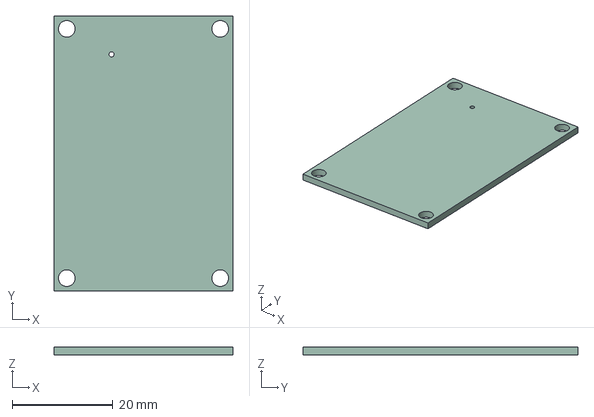
[picture p11: CAD file, 2026-06-27]
parts/Qwiic Mux.step
35.6 x 54.6 x 1.51 mm
