vitormhenrique/hexapod/robot_ros_simulation/HexNav_description/meshes/HexNav/leg_4_coxa_collision.stl

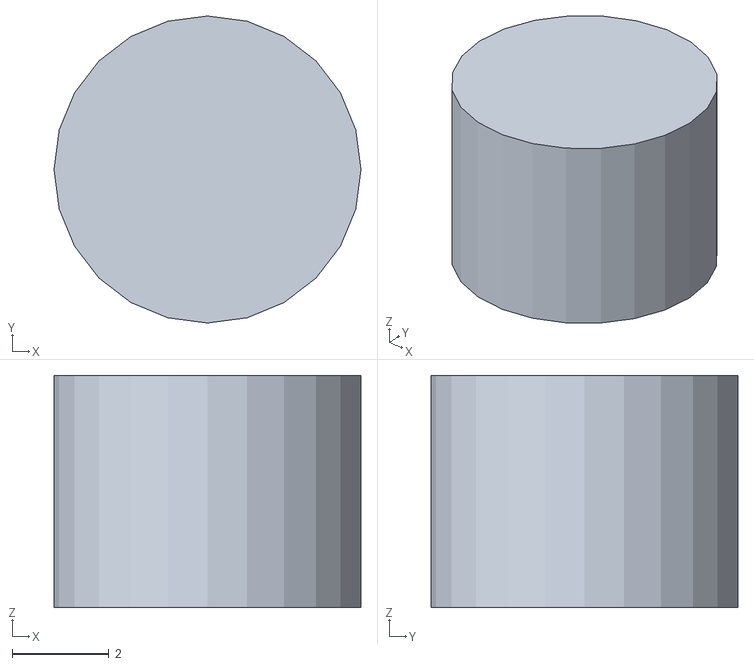
[picture p12: CAD file, 2026-06-25]
robot_ros_simulation/HexNav_description/meshes/HexNav/leg_4_coxa_collision.stl
6.35 x 6.35 x 4.80
