vitormhenrique/hexapod/robot_ros_simulation/HexNav_description/meshes/HexNav/leg_2_tibia_collision.stl

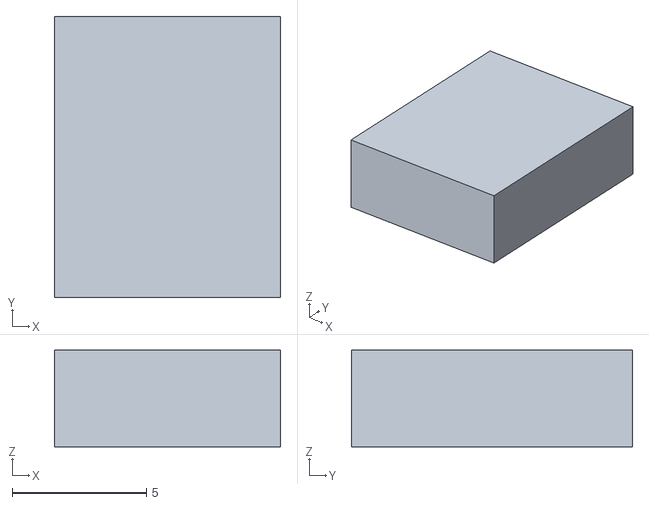
[picture p14: CAD file, 2026-06-25]
robot_ros_simulation/HexNav_description/meshes/HexNav/leg_2_tibia_collision.stl
8.41 x 10.5 x 3.60
