vitormhenrique/hexapod/robot_ros_simulation/HexNav_description/meshes/HexNav/bot_collision.stl

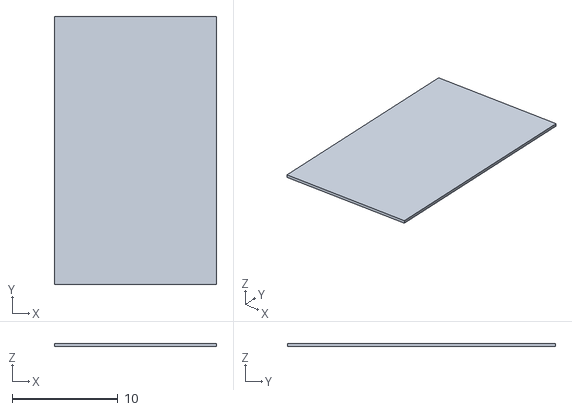
[picture p15: CAD file, 2026-06-25]
robot_ros_simulation/HexNav_description/meshes/HexNav/bot_collision.stl
15.3 x 25.3 x 0.3
