vitormhenrique/hexapod/(list of files, cad)

Other CAD files:
robot_ros_simulation/HexNav_description/meshes/HexNav/base_link_collision.stl
