vitormhenrique/hexapod/docs/operator_guide.md

# Operator Guide

This guide is for bench setup, calibration, operation, session capture, and
first-line troubleshooting. Read it before connecting DYNAMIXEL power.

## Safety Before Wiring

- Keep the robot supported so legs cannot strike a person or bench if a setup
  mistake occurs. Keep the RC kill/disarm control active until the intended
  test explicitly calls for arming.
- Firmware holds the OpenRB-150 DYNAMIXEL power FET off at boot. This is not a
  substitute for a fused external 12 V supply, a safe mechanical setup, or a
  reachable RC kill switch.
- Do not power all 18 MX-28AT servos through the OpenRB-150 DYNAMIXEL port
  current path. Use a properly rated 12 V DYNAMIXEL distribution system with
  fusing and a common ground to the controller.
- Use 3.3 V logic only. The OpenRB-150 logic pins are not 5 V tolerant.
- Do not flash, reset, or power-cycle the controller while a torque-enabled
  robot is unsupported.

## Wiring Checklist

| Connection | Required arrangement |
| --- | --- |
| DYNAMIXEL TTL bus | Connect the servo data bus to the OpenRB-150 `Serial1` DYNAMIXEL TTL bus. The firmware controls the board power FET, while the servo supply must be the external fused 12 V distribution described above. |
| Servo IDs | The assembled robot uses verified sequential IDs 1 through 18 in logical leg/joint order. Confirm the active map before motion; see the [canonical map](ros2_controller_interface_mapping.md#canonical-joint-map). |
| RC receiver | Connect the ExpressLRS CRSF UART to `Serial3`: D14 TX / D13 RX, crossed as a normal UART link, at 420000 baud. Keep the receiver and controller logic at 3.3 V. |
| Root I2C | Connect the TCA9548A mux at `0x70`, Qwiic OpenLog at `0x2A` (`0x29` jumper), and optional 1.3 inch Qwiic OLED at `0x3D` (`0x3C` alternate). Put one Robotic Finger Sensor v2 on mux channels 0 through 5; channels 6 and 7 are reserved. |
| Host connection | Use the OpenRB-150 USB CDC port directly for a Mac companion or Jetson bridge. When the Jetson owns USB, one Mac may use its authenticated TCP relay on a trusted network; see the [Jetson relay guide](../jetson/README.md#mac-tcp-relay). Only one high-authority USB client may control motion at once. |

The battery monitor uses `ADC_BATTERY`; validate the measured battery voltage
before any armed test. Do not infer a safe battery from a USB connection alone.

The optional OLED uses two detailed pages with a 10-second dwell:

- **System health:** safety state/fault, battery and RC link/arming, DXL servo
   count/power/fault, I2C error and foot mask, mux/OpenLog readiness, gait, and
   recording sample count.
- **Motion/tuning:** gait, body height, stride, step height, duty, speed,
   roll/pitch trim, active tuning parameter, and capture state/sample count.

Both pages use SparkFun's bundled 5x7 font.

Firmware uses SparkFun's official Qwiic OLED library and updates one 8-pixel
text row per I2C task pass. A missing or failed OLED never blocks robot control.

## Build, Flash, and First Connection

Install `just`, `uv`, and PlatformIO. If PlatformIO is installed outside its
default location, set `PIO` to its executable before using root recipes.

```bash
cd <clone>/hexapod
just doctor
just firmware-test
just firmware-build
```

Flash only when the robot is mechanically safe and DYNAMIXEL power is not
needed for the upload:

```bash
just firmware-flash
```

If the SAMD21 bootloader is not detected, double-tap the OpenRB-150 RESET
button, then retry. A reset cuts the board-controlled DYNAMIXEL power path.

Install the companion and confirm a framed-protocol handshake. The USB stream
is binary; prefer `hexapod-cli status` over a plain serial monitor for normal
verification.

```bash
cd companion
uv sync --extra dev
uv run hexapod-cli ports
uv run hexapod-cli status --port <USB_PORT>
```

`status` should report the protocol/firmware identity, safety state, features,
and capabilities. A serial device appearing in `ports` is not proof that it is
the OpenRB-150; a successful `status` response is the required check.

## Safe Operating Order

1. Inspect wiring, mechanical clearance, the external supply, and the RC kill
   state. Start disarmed.
2. Connect USB and run `hexapod-cli status`. Use the companion **Connect** and
   **Overview** pages to confirm state, battery, DXL/I2C health, and command
   source.
3. Use **Mode & Safety** to inspect why a feature or mode is unavailable. An
   unavailable feature is a safety signal, not an invitation to retry blindly.
4. Start with passive pose or a supported bench procedure. Do not send raw
   servo targets during normal walking.
5. For RC walking, arm only after the firmware reports ready state and the
   physical area is clear. RC kill/disarm always wins over host and Jetson.
6. Use **Gait Lab** for high-level gait/twist requests. Firmware may clamp or
   reject a request based on its current authority, limits, battery, DXL, and
   sensor state.

If an E-stop or fault occurs, remove the cause before requesting recovery. Do
not treat `CLEAR_FAULT` as a way to override an active hardware or RC safety
condition.

## Complete RC Control Map

The custom ESP32-S3 controller sends these defaults. Feature switch states are
requests; firmware capability, authority, and safety checks remain final.

| Physical control | Position / movement | Robot action |
| --- | --- | --- |
| Left gimbal X | Left / right | Strafe left / right — always, in every `SW_F` position |
| Left gimbal Y | Forward / back | Walk forward / backward — always, in every `SW_F` position |
| Right gimbal X | `SW_F` UP | Turn the robot left / right while walking |
| Right gimbal Y | `SW_F` UP | Unassigned |
| Right gimbal X/Y | `SW_F` CENTER | Shift body Y/X while the left gimbal keeps walking |
| Right gimbal X/Y | `SW_F` DOWN | Body roll/pitch while the left gimbal keeps walking |
| Pot 1 | 0..100% | Gait cadence and torque-enable recovery speed |
| Pot 2 | 0..100% | Body height, `65..150 mm`; center is `132 mm`. Fully down is the belly-near-ground crouch || Encoder 1 | Rotate | Unassigned (stride moved to the NAV1 gait-tune editor) |
| Encoder 2 | Rotate | Unassigned (step lift moved to the NAV1 gait-tune editor) |
| `SW_A` | ON | Request arm; ignored while kill/failsafe is active |
| `SW_B` | ON | Immediate E-stop/kill and disarm request |
| `SW_C` | ON | Request foot-contact detection |
| `SW_D` | ON | Request terrain leveling |
| `SW_E` | UP / CENTER / DOWN | **Left gimbal walk pattern**: wave / ripple / tripod |
| `SW_F` | UP / CENTER / DOWN | **Right gimbal job**: turn / translate body / rotate body |
| `SW_G` | ON / OFF | Enter gait tuning / restore NAV1 pose trim |
| `SW_H` | ON | Hand motion authority to the USB host or Jetson |
| `BTN_1` | Press | Stand-up choreography |
| `BTN_2` | Press | Sit-down choreography |
| `BTN_3` | Press | Standing body-rock wave choreography |
| `BTN_1` + `BTN_2` | Hold 3 seconds | Start `CAPTURE.CSV` recording |
| `BTN_4` | Press | Start recording; press again to stop and sync `CAPTURE.CSV` |
| `NAV1` Up / Down | Press | Trim pitch ±1° / select gait parameter while tuning |
| `NAV1` Left / Right | Press | Trim roll ±1° / decrease-increase the parameter while tuning |
| `NAV1` Center | Press | Reset trim / save gait settings to OpenLog while tuning |
| `NAV2` Up | Press | Twirl in place |
| `NAV2` Down | Press | Stretch/push-up sequence |
| `NAV2` Left | Press | Bounded jump-kick: crouch, fast capped extension, short tripod flick |
| `NAV2` Right | Press | Hold spider-attack stance until stick input cancels it |
| `NAV2` Center | Press | Loop dance until stick input cancels it |

Buttons and nav actions trigger immediately with a 150 ms refractory window.
Holding a trick button repeats its choreography every 2 seconds. Holding
`BTN_1` and `BTN_2` together for 3 seconds starts recording and suppresses
both individual tricks while the combination is held. BTN_4 is dedicated to
capture and no longer toggles crouch; use Pot 2 for crouched/tall body height.
Any active trick is cancelled when the operator moves a gait/body stick.
Centered walking sticks park all feet at home without advancing phase.
The detailed CRSF channel and TX16S-direct mappings are in the
[controller bridge reference](controller_bridge.md).

### Remote SD Capture

Press `BTN_4` once to start recording and press it again to stop and sync. A
held button does not retrigger; it must be released before the stop press.
Recording requires a detected,
SD-ready Qwiic OpenLog. The optional Qwiic OLED shows `HEXAPOD REC` and the
number of completed samples while capture is active.

`CAPTURE.CSV` is append-only and contains marked sessions. New sessions write
`BEGIN,...,2`; the final `2` is the capture schema version. All rows with one
sample number were copied from the same remote, goal-frame, and servo-status
snapshots before any OpenLog writes began:

- `BEGIN` / `END`: session uptime, timestamp, completed sample count; `BEGIN`
   also carries the capture schema version.
- `R`: raw gimbals, pots, encoders, switch/button/toggle/nav masks, and the
   conditioned remote targets: mode/gait, twist, body pose, and gait shape.
- `C`: the motion command that reached the gait pipeline: goal-frame sequence,
   command source, safety state, active gait, motion/reach/clamp flags, and the
   applied body height, stride, step height, duty, and speed.
- `L`: all six final gait foot targets in body-frame millimetres after reach
   limiting, with swing, reachable, and joint-clamp flags.
- `G`: final calibrated servo goal ticks and logical goal angles in centidegrees
   after IK, servo-map limits, and the arm-transition slew; each row packs up to
   six joints and carries the same goal-frame sequence as `C` and `L`.
- `S`: sample timestamp, servo ID, validity, present tick and logical present
   angle in centidegrees, velocity, raw load, input voltage in millivolts,
   temperature in Celsius, hardware error, and torque state.

Samples begin at 2 Hz and each snapshot is written in 24 bounded I2C task
passes: `R`, `C`, `L`, three `G` rows, and one `S` row per discovered servo.
DYNAMIXEL detail reads already rotate across the 18 servos, so
load/temperature/voltage values are the latest converged values. Each complete
sample is synced to the SD card. A storage failure stops capture and reports
`CAPTURE_WRITE_FAILED` through the normal error journal.

### Ride Height Range

Pot 2 spans `65..150 mm` measured from the coxa-axis plane down to the feet,
with the neutral `132 mm` centered-servo stance at mid-travel. The two halves
are deliberately asymmetric: the lower half buys 67 mm of real crouch travel
while the upper half is an 18 mm trim.

At the bottom of the range the robot sits belly-near-the-ground with the femur
about `+60°` and the tibia about `-50°` from their zero rest — what the Joint
Matrix page shows as roughly `240 deg` and `128 deg`. Stance X/Y does not
change, so the footprint stays the same as when standing.

Swing clearance remains the configured step height through the full ride-height
range, including the 65 mm crouch limit. The toe target cap leaves room for the
maximum 50 mm configured lift at that lowest height.

The NAV2 jump-kick is not a raw-servo or ballistic jump. It keeps the normal
state gate, IK reach checks, and servo travel clamps, then asks for 120 mm/s
height motion below the firmware’s 200 mm/s hard ceiling. First run it with the
robot supported and keep the surrounding floor clear.

## Tuning The Gait From The Handset

The gimbals have fixed jobs: the **left gimbal always walks** and the **right
gimbal turns or moves the body**. `SW_E` changes how the left gimbal walks (the
gait pattern) and `SW_F` changes what the right gimbal does. Because the two are
independent, the robot walks normally while the body is shifted or tilted —
body motion never needs a dedicated gait. Turning is available in `SW_F` UP
only, since the body modes use both right-hand axes for the pose overlay.

Stride, step height, and duty are edited from the NAV1 cluster:

1. Turn `SW_G` ON to engage the gait-tune editor. NAV1 stops trimming pose and
   starts editing gait parameters.
2. `NAV1 Up` / `Down` cycles step height → stride → duty. The handset telemetry
   page shows the selected parameter and its live value.
3. `NAV1 Right` / `Left` changes it by 5% of the safe range per press.
4. With the sticks centred and the robot armed, **leg 1 traces the swing arc**
   once every 2 s using the live values, so the change is visible on the robot.
   Moving a stick cancels the preview and returns to normal walking.
5. `NAV1 Center` appends the complete config to `CONFIG.TXT`. Saving is refused
   while the robot is moving or when OpenLog storage is unavailable; the reason appears on the handset
   `Error` row.
6. Turn `SW_G` OFF to leave the editor and restore pose trim.

While the editor is engaged the robot raises its status downlink from 5 Hz to
20 Hz so the readout keeps up with the knob. On boot the editor is seeded from
the stored `GaitDefaults`, so what you see is what is persisted.

Alternatives to the leg-1 preview, if it turns out to be inconvenient on your
bench: read the numbers only from the handset `Tuning` row (works disarmed), or
replay a recorded session in the companion Plot Workbench / URDF viewer. The
preview is deliberately gated on "armed, sticks centred" so it can be avoided
simply by tuning while disarmed.

## OpenRB User LED Status

The USER LED is a nonblocking status indicator. Short flashes are 100 ms;
count the flashes before the longer pause.

| LED pattern | Meaning |
| --- | --- |
| Fast 100 ms on / 100 ms off | Boot/config load, or arming checks complete and transitioning |
| One short flash every 2 seconds | Healthy and disarmed |
| Two short flashes, pause | Arming: discovering configured servo IDs |
| Three short flashes, pause | Arming: IDs found, waiting for all present-position reads |
| Solid on | Armed/ready/manual/contact/Jetson motion state |
| Two short flashes every 2 seconds | Mac maintenance lock active |
| 500 ms on / 500 ms off | Passive pose stream, torque off |
| 1..7 short flashes every 3 seconds | Fault code shown below |

Fault pulse codes:

| Pulses | Fault |
| ---: | --- |
| 1 | RC kill switch |
| 2 | Host E-stop |
| 3 | RC link lost/failsafe |
| 4 | Battery low |
| 5 | Watchdog/task stall |
| 6 | DYNAMIXEL hardware/bus fault |
| 7 | Arming timeout, usually incomplete servo ID or pose coverage |

After a seven-flash arming timeout, release `SW_A`, inspect DXL power/wiring and
IDs, clear the soft fault, then re-arm. Do not repeatedly arm against an
unresolved discovery failure.

## Config and Calibration

Persistent configuration belongs in **Servo Config** / **Robot Calibration &
Config**. It contains the EEPROM-backed servo map, zero trims, signs, travel
limits, leg geometry, gait defaults, and foot-sensor calibration.

Use this exact lifecycle:

1. Enter maintenance only while the robot is physically safe. Confirm target
   servo torque is off before any EEPROM-backed servo parameter change.
2. Load the current configuration and make changes in displayed units.
3. Inspect **Diff vs loaded**, then **Stage to robot** and **Validate staged**.
4. Commit only after firmware validation succeeds. Commit is intentionally
   unavailable when the 24LC32 EEPROM is missing or unsafe state prevents it.
5. Export the staged/committed JSON as a calibration backup.

The DXL UI and CLI use logical parameter names. The firmware automatically
maps legacy MX-28 CW/CCW angle limits or MX(2.0) min/max position limits based
on the detected servo profile. Do not use raw register writes as a normal
calibration workflow. EEPROM-requiring writes must be torque-off and read-back
verified.

### Foot Sensor Calibration

With each foot unloaded and live raw pressure telemetry current, use **Copy
live pressure baselines** in Robot Calibration & Config. Set nonzero `near`,
`touch`, and `load` thresholds, keep `load >= touch`, enable only calibrated
feet, then stage, validate, and commit.

The **Foot Contact** page and CLI can re-zero the live estimator for bench
tuning:

```bash
uv run hexapod-cli contact calibrate --foot 255 --port <USB_PORT>
uv run hexapod-cli contact enable --port <USB_PORT>
uv run hexapod-cli feature get --port <USB_PORT>
```

Runtime baseline/threshold changes are not persistent. Copy successful values
back into the staged RobotConfig and commit them if they must survive a reboot.
Firmware may reject contact or terrain-leveling enable requests when the mux,
sensor confidence, calibration, or safety state is unsuitable. Nominal gait
and IK remain available when optional contact features degrade.

## Passive Pose, Logging, Plotting, and URDF

Passive pose mode is the first physical workflow to use for a new robot. It
disables torque and stops goal writes while present positions continue to be
read. Do not manually pose the robot until passive mode is confirmed.

### CLI Workflow

```bash
cd companion

# Request torque-off passive pose mode.
uv run hexapod-cli passive enter --port <USB_PORT>

# Physically pose the torque-off robot while this command records telemetry.
uv run hexapod-cli log \
  --streams health,joint_state,servo_status,contact_state \
  --rate 20 --seconds 60 --name passive_pose --port <USB_PORT>

# Return to normal disarmed operation when recording is complete.
uv run hexapod-cli passive exit --port <USB_PORT>
```

The logger prints the session directory. Replay it in **Plot Workbench** to
compare servo goal/present position, voltage, temperature, contact state, and
other selected signals. From the CLI, export a selected CSV or text report:

```bash
uv run hexapod-cli export-csv data/sessions/<session> \
  --signals health.battery_mv,servo.1.position
uv run hexapod-cli export-report data/sessions/<session>
```

Use **Model Viewer** or **URDF Viewer** to inspect the same `joint_state`
telemetry against the flattened
`robot_ros_simulation/HexNav_description/urdf/HexNav.urdf` model. The viewer
uses the active servo map for tick-to-angle conversion; incorrect sign, trim,
or joint mapping is a calibration problem, not a visual-only issue.

## Troubleshooting

| Symptom | First safe checks |
| --- | --- |
| No upload port | Double-tap RESET, reconnect a known data-capable USB cable, then retry `just firmware-flash`. Do not reset an unsupported torque-enabled robot. |
| Port exists but `status` times out | Check that the selected port is the OpenRB-150, close competing clients, reconnect USB, then retry. A plain serial monitor can corrupt or consume binary frames. |
| No DXL scan or status | DXL power is expected to be off at boot. First inspect the external fused 12 V rail, common ground, bus connection, and maintenance/safety state. Do not repeatedly force power or torque. |
| Config commit rejected | Check OpenLog/SD readiness and I2C topology. Missing or unready storage uses volatile safe defaults. Missing files are initialized automatically; a damaged prefix is preserved and followed by a verified default recovery record. |
| OpenLog present but no files | The board can answer at `0x2A` while reporting `SD_INIT_GOOD=0`. Reseat the microSD, use a supported FAT-formatted card, and reboot. Crash/config/event files are not created until SD initialization succeeds. |
| Contact feature unavailable | Use **Sensor Dashboard** or `feature get`; inspect mux `0x70`, each channel 0 through 5, stale/fault state, and calibration before retrying. |
| Telemetry gaps | Lower requested stream rates and inspect `uv run hexapod-cli stream-stats --port <USB_PORT>` for transmit backlog or dropped frames. |
| Heat, voltage, or hardware fault | Stop motion, disarm, remove power if necessary, and diagnose supply capacity, wiring, temperature, and DXL status before clearing a fault. |
| URDF pose looks wrong | Verify the active servo map, sign, trim, and neutral geometry. Do not compensate by changing only the viewer. |

For board-specific details, see the [firmware README](../firmware/openrb150/README.md).
For RC mapping and failsafe semantics, see the
[controller bridge reference](controller_bridge.md).
