vitormhenrique/hexapod/firmware/openrb150/docs/20231130 OpenRB-150 schematic.pdf

# Release Date

# Circuit Release Notes

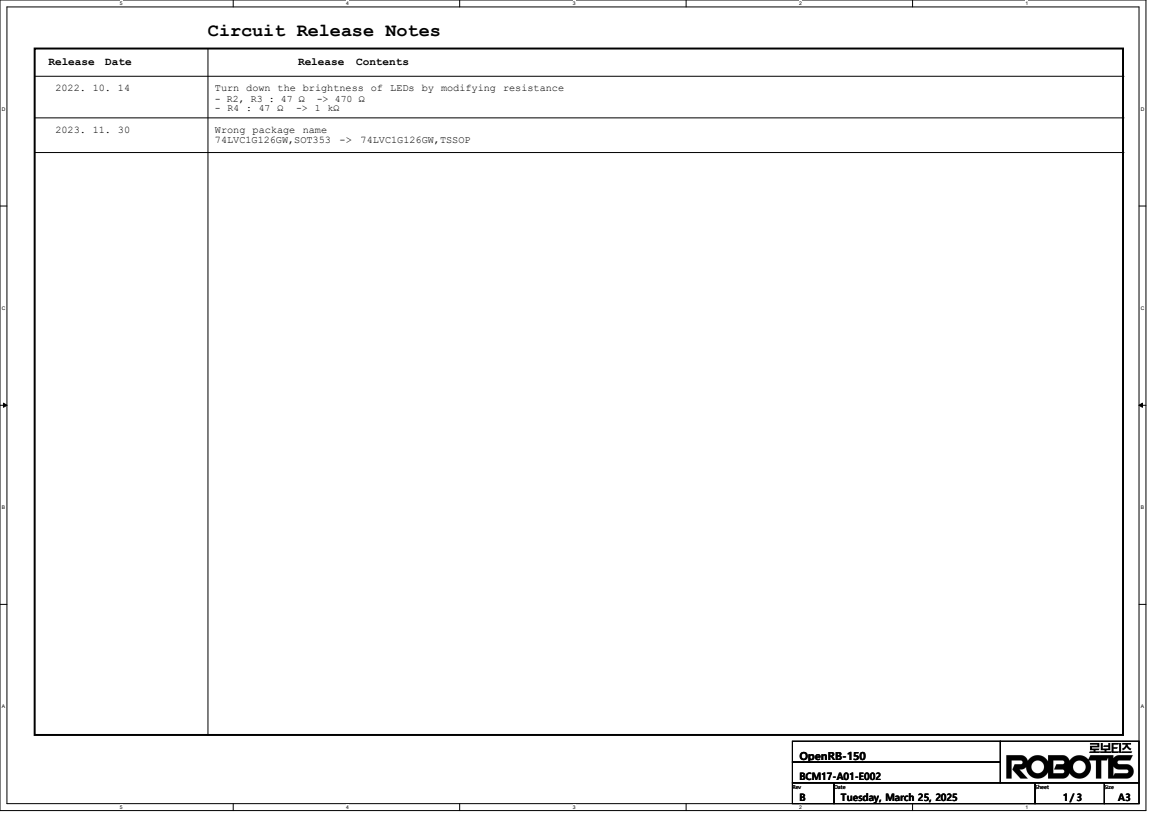
[picture p16: page 1]
Release Contents; Wrong package name; 74LVC1G126GW,SOT353 -> 74LVC1G126GW,TSSOP; Turn down the brightness of LEDs by modifying resistance; Rev; Sheet; Size; Date BCM17-A01-E002; OpenRB-150; Tuesday, March 25, 2025

# +3V3 Regulator

(J1)

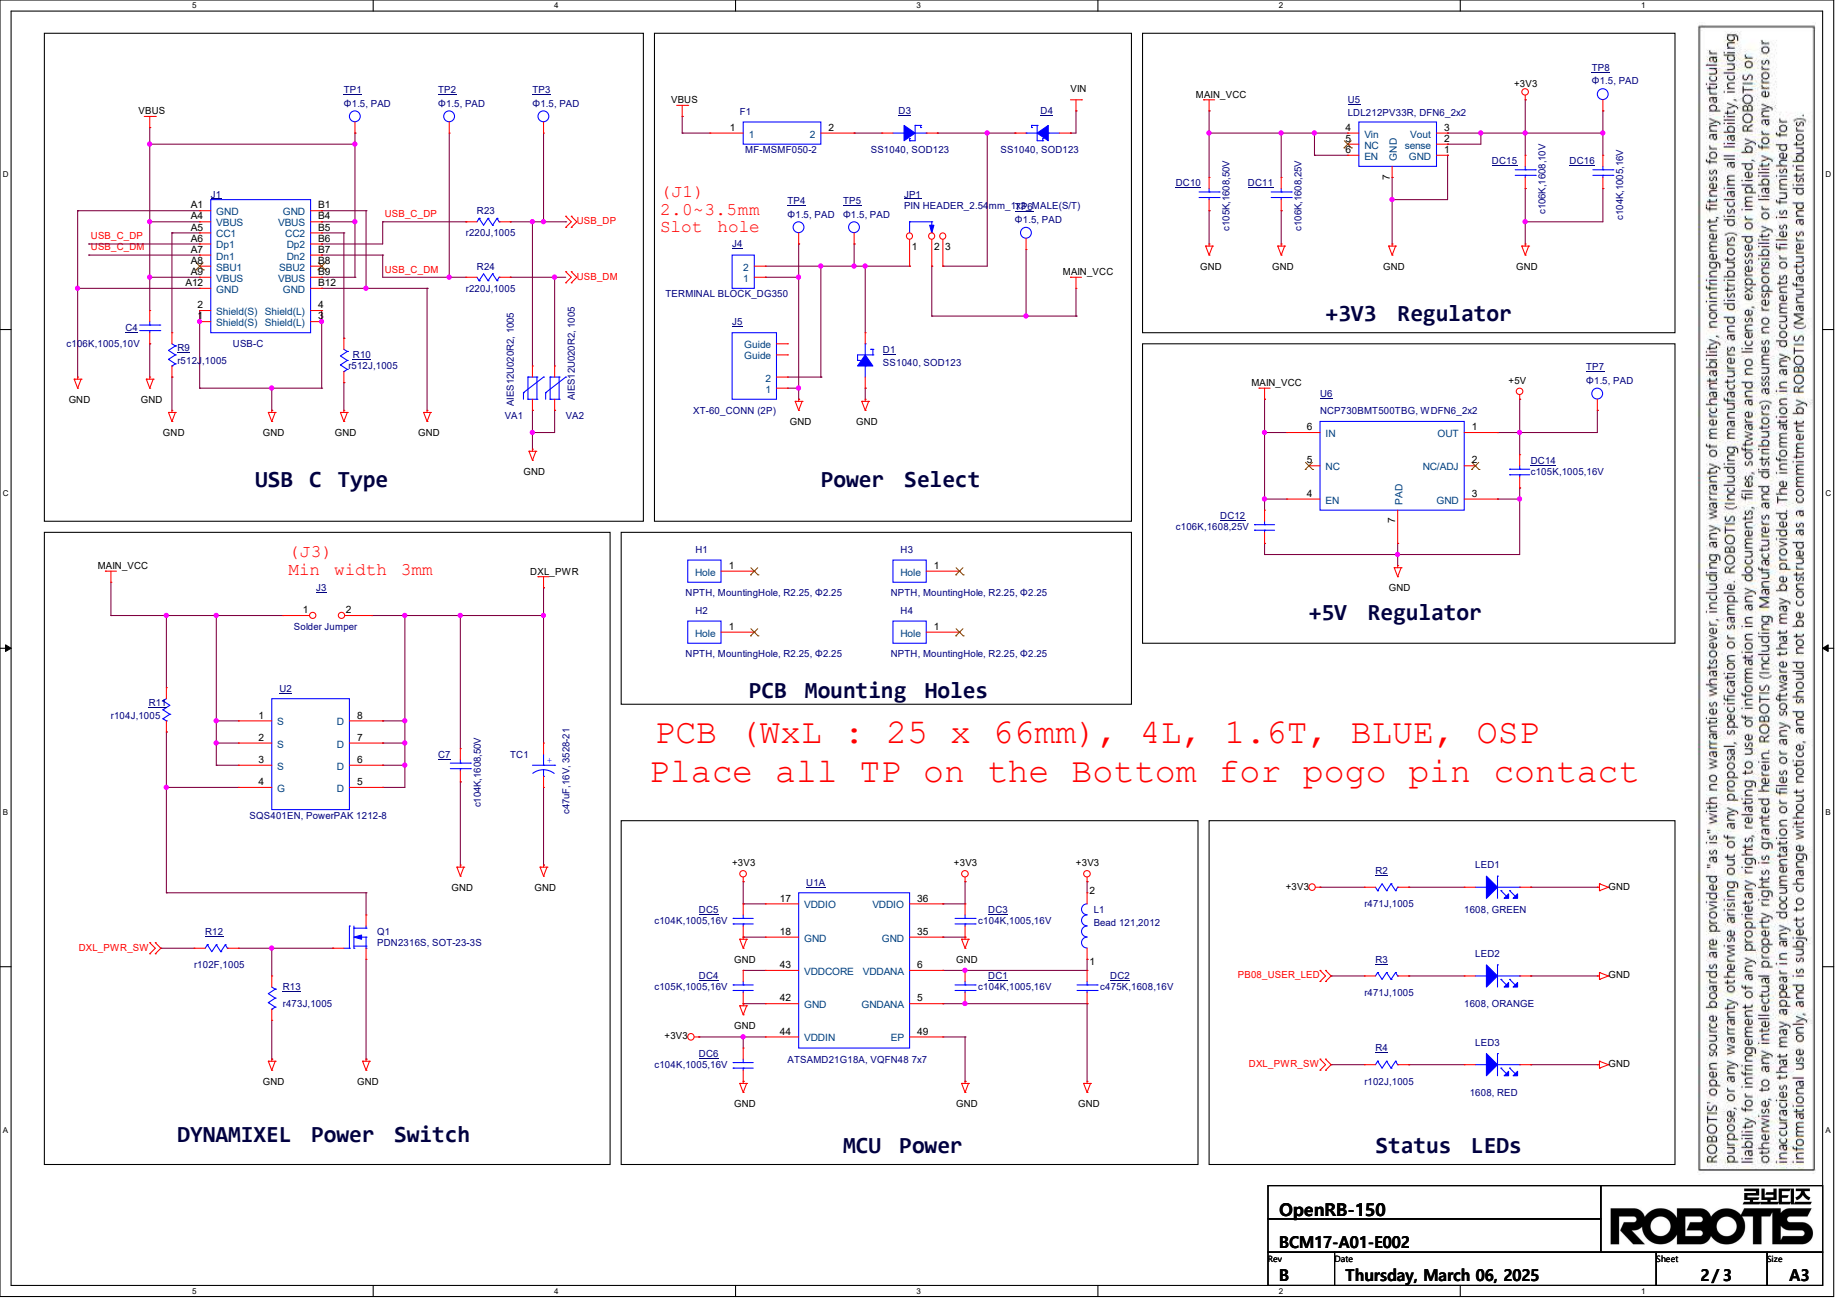
[picture p17: page 2]

PCB Mounting Holes
PCB (WxL : 25 x 66mm), 4L, 1.6T, BLUE, OSP
Place all TP on the Bottom for pogo pin contact

## VIN@16.8V, PB09 reads 3.22V

PA24/USB_DM 33 PA25/USB_DP 34 PA18 27 PA00/XIN32 1 PA01/XOUT32 2 PA14 23 PA12 21 PA13 22 PA15 24 PA27 39 PB08 7 PB09 8 PA28 41 PA02 3 PA04 9 PA05 10 PA06 11 PA07 12 PA08 13 PA09 14 PA10 15 PA11 16 PA16 25 PA17 26 PA19 28 PA20 29 PA21 30 PA22 31 PA23 32 PB02 47 PB03 48 PB10 19 PB11 20 PB22 37 PB23 38 PA03 4 RESETN 40 PA30/SWCLK 45 PA31/SWDIO 46

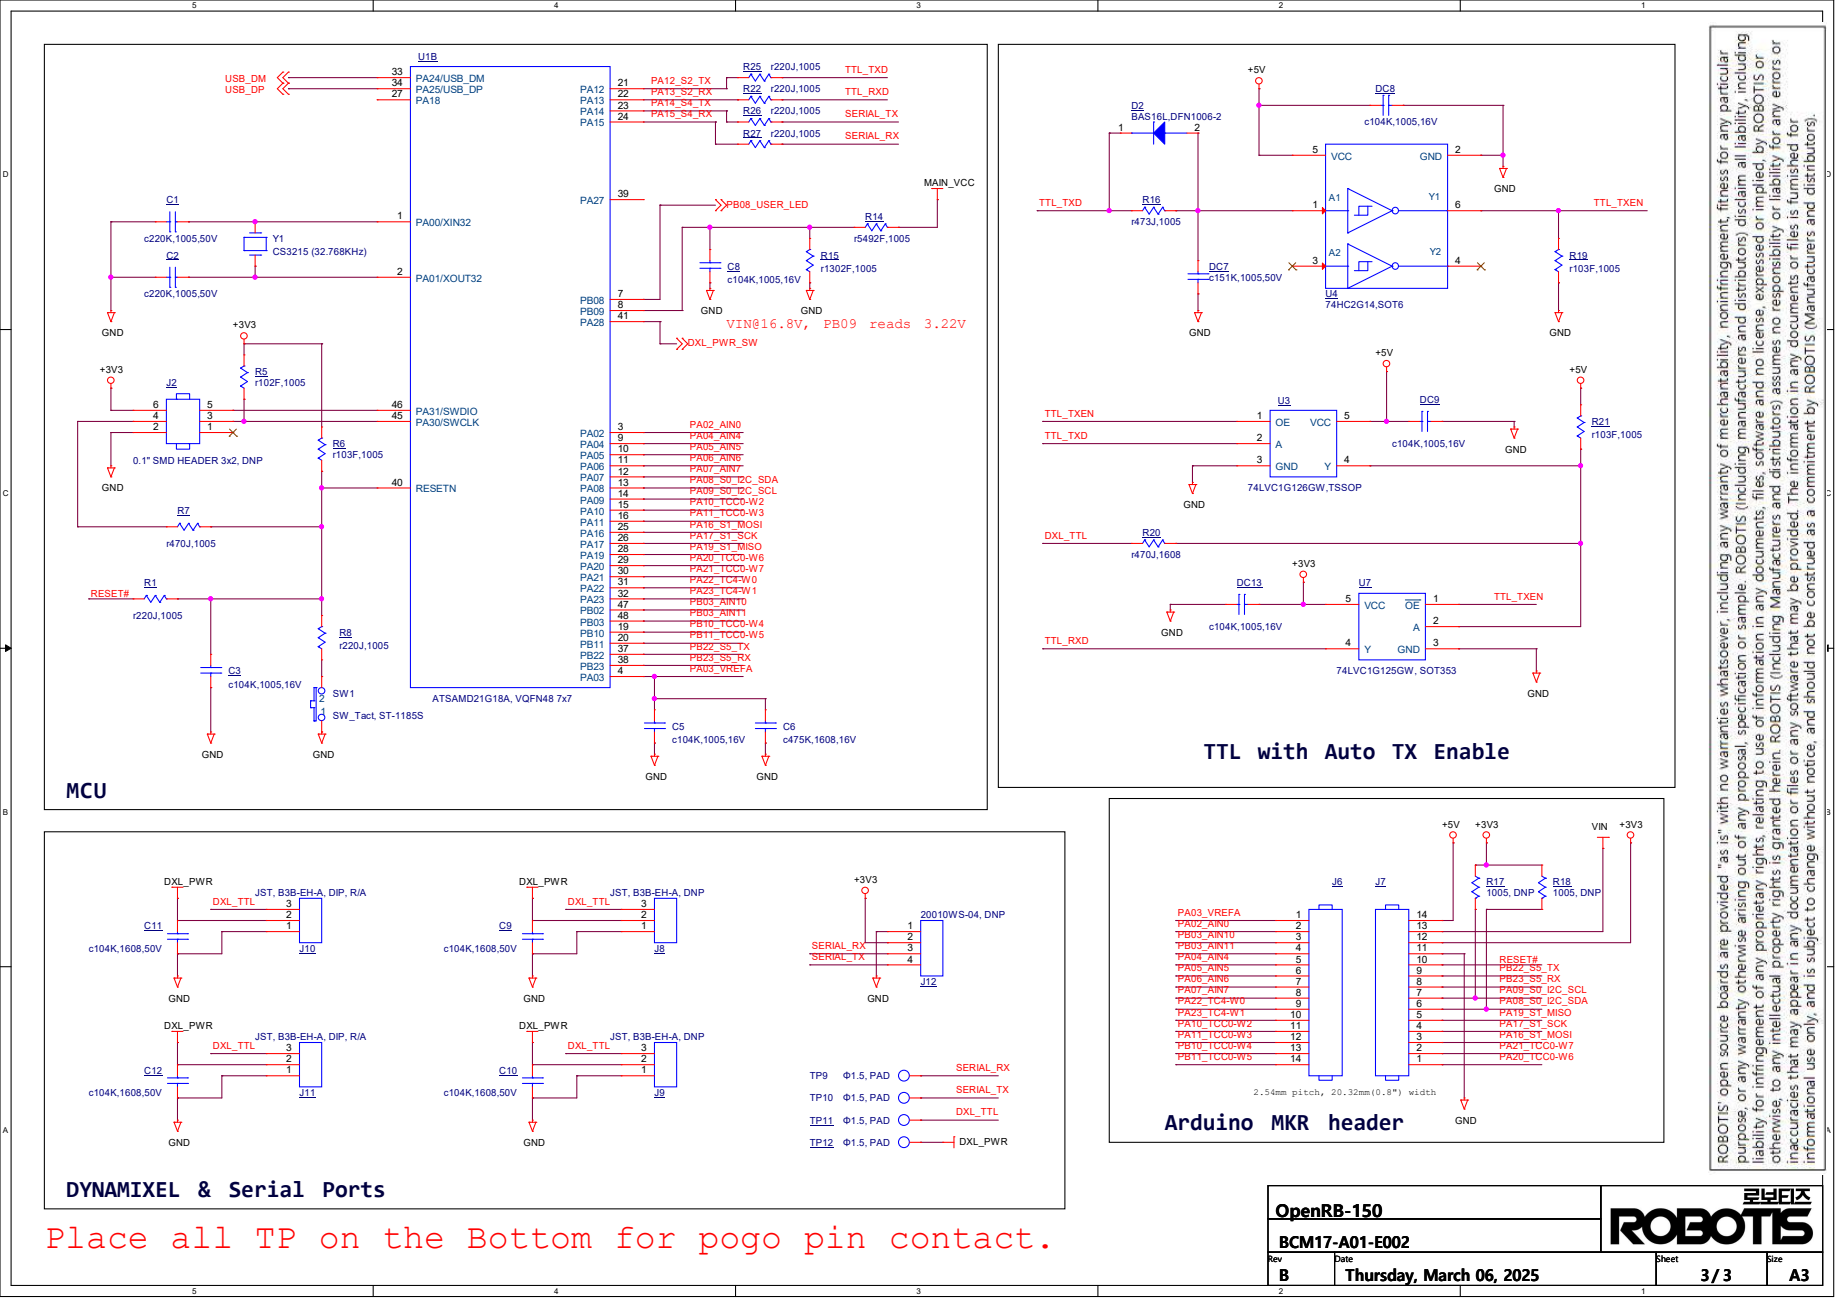
[picture p18: page 3]

R25 r220J,1005 TTL_TXD

TTL with Auto TX Enable

DYNAMIXEL & Serial Ports
Place all TP on the Bottom for pogo pin contact.
