vitormhenrique/hexapod/firmware/openrb150/src/safety/state_machine.h

#pragma once

// ===========================================================================
// Firmware safety state machine (AGENTS.md 5.3).
//
// This is a PORTABLE module: it contains no Arduino includes and is unit-tested
// on the host. The control task feeds it a snapshot of the latest health, RC,
// arbiter, and feature inputs each cycle and reads back the authoritative
// system State plus a fault reason. The numeric State values come from
// system_state.h and are part of the wire protocol, so they must not change.
//
// The machine is deterministic and side-effect free: it only computes the next
// state. The caller is responsible for acting on it (gating torque, goal
// writes, etc.). Motion and torque are only permitted in the states reported by
// stateAllowsMotion()/stateAllowsTorque().
// ===========================================================================

#include <stdint.h>

#include "system_state.h"

namespace safety {

// Why the machine is (or last was) in a fault/estop state. Reported in
// telemetry so an operator can see the cause of a safe stop.
enum class FaultReason : uint8_t {
  None = 0,
  RcKill = 1,
  HostEstop = 2,
  RcLinkLost = 3,
  BatteryLow = 4,
  Watchdog = 5,
  DxlHardware = 6,
  ArmingTimeout = 7,
};

// Tunable thresholds. Defaults are conservative; the config layer may override.
struct StateParams {
  // 10.0 V assumes a 3S LiPo (~3.33 V/cell): below this an armed pack is too
  // low to keep walking safely. This is meaningful only when battery_mv is a
  // HIL-calibrated reading (board.h kBatteryDividerRatio); 1S/2S packs are not
  // supported by this robot (12 V MX-28AT bus -> 3S).
  uint16_t battery_min_mv = 10000;  // below this (when valid) -> Estop
  // The low-battery reading must persist this long before it trips Estop.
  // Turning on the DXL power FET makes 18 idle MX-28s draw a large inrush
  // that sags a bench supply (and the ADC sense line) below battery_min_mv
  // for a couple of control cycles; a single-sample Estop then tears down an
  // active maintenance session the instant DXL power is enabled (HIL bug 7).
  // A genuinely dying pack stays low, so debouncing only filters transients.
  uint16_t battery_low_debounce_ms = 250;
  // Maximum time for DXL discovery, status checks, torque-off verification,
  // hold-goal seeding, and torque-on verification.
  uint16_t arming_timeout_ms = 10000;
  // Idle auto-disarm: an ARMED robot (StandReady / RC / contact / Jetson
  // states) with no motion activity for this long drops to Disarmed, which
  // cuts DXL power via stateAllowsDxlPower -- 18 idle MX-28s holding torque
  // waste watts and heat. Re-powering requires an explicit re-arm (the arm
  // switch must be released and re-asserted) or a maintenance power command.
  // 0 disables the timeout.
  uint32_t idle_disarm_ms = 60000;
};

// One cycle of inputs sampled from the rest of the firmware. All fields are
// plain values copied from cross-task snapshots so the machine never blocks.
struct StateInputs {
  // Boot / config.
  bool config_loaded = false;  // a config slot (or safe default) is loaded

  // Health.
  uint16_t battery_mv = 0;
  bool battery_valid = false;  // true only when a real pack reading exists
  bool watchdog_fault = false;  // motion-critical Control/DXL task stalled
  bool dxl_hard_fault = false;  // repeated bus failures / servo HW error

  // Estop / kill sources.
  bool host_estop = false;
  bool rc_kill = false;
  bool rc_failsafe = false;  // RC link lost

  // Arming.
  bool rc_ever_seen = false;
  bool rc_armed = false;          // RC arm switch asserted
  bool arming_checks_pass = false;  // battery + config + verified DXL arm ok
  bool host_disarm = false;       // host SET_ARMING(disarm): force Disarmed

  // Command authority (from CommandArbiter).
  uint8_t command_source = 0;  // safety::CommandSource value
  bool jetson_fresh = false;
  bool rc_autonomy = false;  // RC grants autonomy authority
  bool mac_lock_held = false;
  bool maintenance_request = false;  // explicit enter-maintenance command
  // Explicit USB recovery from a stale RC failsafe. The controller core sets
  // this only after validating non-RC safety conditions and torque-off state.
  bool maintenance_failsafe_recovery = false;

  // Passive pose streaming.
  bool passive_request = false;
  bool torque_off = false;  // all servo torque confirmed off

  // Contact-aware terrain.
  bool contact_enabled = false;
  bool contact_confident = false;

  // True when any command source is actively requesting motion this cycle
  // (sticks off-centre, host twist/pose/gait activity, trick running).
  // Feeds the idle auto-disarm timer; quiet cycles let it expire.
  bool motion_active = false;
};

// Returns true when servo goal writes are permitted in the given state.
bool stateAllowsMotion(State s);

// Returns true when servo torque may be enabled in the given state. Passive
// pose streaming is explicitly excluded (torque must stay off there).
bool stateAllowsTorque(State s);

// Returns true when the DXL power bus may be energized. ArmingChecks needs a
// powered, torque-off bus for discovery and present-position reads.
bool stateAllowsDxlPower(State s);

class StateMachine {
 public:
  void configure(const StateParams& params) { params_ = params; }

  // Reset to the power-on state. Call once at task start.
  void reset();

  // Advance one cycle and return the resulting state.
  State update(const StateInputs& in, uint32_t now_ms);

  // Operator request to clear a latched hard fault. Takes effect on the next
  // update() if the underlying fault condition has cleared.
  void requestClearFault() { clear_fault_requested_ = true; }

  State state() const { return state_; }
  FaultReason faultReason() const { return reason_; }
  FaultReason lastFaultReason() const { return last_fault_reason_; }
  uint32_t lastFaultTimestampMs() const { return last_fault_timestamp_ms_; }

 private:
  void latchFault(FaultReason reason, uint32_t now_ms);

  StateParams params_{};
  State state_ = State::Boot;
  FaultReason reason_ = FaultReason::None;
  FaultReason last_fault_reason_ = FaultReason::None;
  uint32_t last_fault_timestamp_ms_ = 0;
  bool clear_fault_requested_ = false;
  // Battery-low debounce: timestamp of the first consecutive low sample.
  bool batt_low_active_ = false;
  uint32_t batt_low_since_ms_ = 0;
  uint32_t arming_since_ms_ = 0;
  uint32_t last_activity_ms_ = 0;  // idle auto-disarm reference
  bool arm_release_required_ = true;
};

}  // namespace safety
