vitormhenrique/hexapod/firmware/openrb150/src/app/task_config.h

#pragma once

// ===========================================================================
// RTOS task configuration: stack depths (in FreeRTOS WORDS, 4 bytes each),
// priorities, and loop periods. Centralized so stack budgeting and timing are
// reviewable in one place.
//
// Priority ordering (higher number = higher priority) follows AGENTS.md 5.1:
//   control / dxl  : high   (real-time motion + servo bus)
//   rc             : high (failsafe-relevant UART drain)
//   api            : medium
//   health         : highest (brief watchdog evaluation only)
//   i2c            : low
// ===========================================================================

#include <stdint.h>

namespace app {

// Stack depth in words. configMINIMAL_STACK_SIZE on this port is small; these
// give comfortable headroom that the health task verifies via high-water marks.
namespace stack_words {
// Armed RC motion runs gait + body IK + six leg IK solves in this task. Live
// high-water tracing showed only 31 words free with a 384-word stack during
// production startup. Leave 95 words of margin at that observed peak for
// deeper commanded-pose and trick paths. NOTE: the OLED display-state staging
// in publishControllerCommand() must stay OFF this stack (file-scope static);
// as a stack local it consumed ~52 words and overflowed this task on arming.
constexpr uint16_t kControl = 448;
// dxl: Dynamixel2Arduino call chains (syncRead/readControlTableItem parsing)
// plus the 160-byte maintenance-job result buffer run on this stack; 256 words
// hard-faulted the MCU on the first status cycle after a real-servo scan
// (HIL hexapod_src-2e8 bring-up). The SAMD21 build uses 384 words: it retains
// a 128-word margin over the observed loaded path and returns 512 bytes to the
// main/interrupt stack, which the OLED-enabled image needs for USB setup ISR
// nesting. The Teensy has ample SRAM and keeps the more conservative 512.
#if defined(ARDUINO_ARCH_SAMD)
constexpr uint16_t kDxl = 384;
#else
constexpr uint16_t kDxl = 512;
#endif
// CRSF parsing, controller decoding, calibration handoff, and telemetry share
// this task. A retained FreeRTOS overflow record captured a receiver-triggered
// failure at 192 words, so reserve enough headroom for the complete frame path.
constexpr uint16_t kRc = 320;
// Request/response buffers are static, but live hardware retained an API-task
// overflow at 576 words while companion maintenance/config traffic was active.
// That chain included a ~568-byte RobotConfig stack temporary inside
// deserializeRobotConfig() which is now a flash-image copy (config_schema.cpp
// kZeroRobotConfig), cutting the measured worst case to ~450 words. 640 keeps
// >180 words of margin over that.
// The SAMD21 production image keeps 576 words: after the RobotConfig
// deserialization temporary was removed, measured worst-case use is 450 words.
// This recovers a further 256 bytes of main-stack headroom while keeping 126
// words for call-depth variation. HIL retains 768 and the Teensy retains 640.
#if defined(HEXAPOD_HIL_OUTPUT_DISABLED)
constexpr uint16_t kApi = 768;
#elif defined(ARDUINO_ARCH_SAMD)
constexpr uint16_t kApi = 576;
#else
constexpr uint16_t kApi = 640;
#endif
#if defined(HEXAPOD_HIL_OUTPUT_DISABLED)
constexpr uint16_t kI2c = 384;
#else
// SparkFun Qwiic1in3OLED initialization and dirty-row display calls add a deep
// graphics + Wire call chain. Keep measured headroom beyond the former 384-word
// stack, which could overflow before retained crash/config files were written.
constexpr uint16_t kI2c = 512;
#endif
// healthTask's -fstack-usage chain is tiny: healthTask(32 B) +
// watchdog::evaluate(24 B) + status_led::ledOn(16 B) + context save. 192 words
// still leaves >140 words of margin and stays above configMINIMAL_STACK_SIZE.
constexpr uint16_t kHealth = 192;
}  // namespace stack_words

// FreeRTOS task priorities. tskIDLE_PRIORITY == 0.
namespace priority {
constexpr uint8_t kControl = 3;
constexpr uint8_t kDxl = 3;
constexpr uint8_t kRc = 3;
constexpr uint8_t kApi = 2;
constexpr uint8_t kI2c = 1;
constexpr uint8_t kHealth = 4;
}  // namespace priority

// Nominal loop periods in milliseconds for the skeleton. Real rates are tuned
// as each task is fleshed out in later Phase 1/2 tasks.
namespace period_ms {
constexpr uint32_t kControl = 10;   // 100 Hz
constexpr uint32_t kDxl = 20;       // 50 Hz
constexpr uint32_t kRc = 10;        // 100 Hz
constexpr uint32_t kApi = 5;        // 200 Hz poll
constexpr uint32_t kI2c = 20;       // 50 Hz
constexpr uint32_t kHealth = 100;   // 10 Hz LED; watchdog remains 2 Hz

// Runtime-tunable bounds for the i2c/sensor poll loop period (SENSOR_SET_RATE,
// lmt.9). The host requests a poll rate in Hz; the i2c task derives its loop
// period from it and clamps to this window so a host cannot starve the loop
// (which also services config commits) or spin it pointlessly fast.
constexpr uint32_t kI2cMinMs = 5;    // 200 Hz ceiling
constexpr uint32_t kI2cMaxMs = 100;  // 10 Hz floor
}  // namespace period_ms

}  // namespace app
