vitormhenrique/hexapod/firmware/openrb150/src/protocol/sensor_api.cpp

#include "sensor_api.h"

namespace protocol {
namespace {

inline uint16_t get16(const uint8_t* p) {
  return static_cast<uint16_t>(p[0]) | (static_cast<uint16_t>(p[1]) << 8);
}

inline uint16_t put16(uint8_t* p, uint16_t v) {
  p[0] = static_cast<uint8_t>(v & 0xFF);
  p[1] = static_cast<uint8_t>((v >> 8) & 0xFF);
  return 2;
}

inline SensorResult mapResult(FeatureResult r) {
  switch (r) {
    case FeatureResult::Ok:
      return SensorResult::Ok;
    case FeatureResult::Rejected:
      return SensorResult::Rejected;
    default:
      return SensorResult::BadRequest;
  }
}

}  // namespace

void SensorApi::reset() {
  for (uint8_t i = 0; i < kSensorNumFeet; ++i) {
    thresholds_.near_thresh[i] = 0;
    thresholds_.touch_thresh[i] = 0;
    thresholds_.load_thresh[i] = 0;
  }
  threshold_seq_ = 0;
  leveling_.max_tilt_mdeg = 0;
  leveling_.rate_mdeg_s = 0;
  leveling_.response_x255 = 0;
  leveling_seq_ = 0;
  scan_seq_ = 0;
  calibrate_mask_ = 0;
  calibrate_seq_ = 0;
  rate_hz_ = 0;
  rate_seq_ = 0;
}

bool SensorApi::applyFeature(Feature f, bool enable, uint8_t* out,
                            size_t out_cap, uint16_t* out_len,
                            uint8_t* out_flags) {
  if (features_ == nullptr || out_cap < 5) {
    out[0] = static_cast<uint8_t>(SensorResult::Rejected);
    *out_len = 1;
    *out_flags = 0x02;
    return true;
  }
  const FeatureApplyResult r = features_->applyDesired(f, enable);
  out[0] = static_cast<uint8_t>(mapResult(r.result));
  out[1] = features_->liveState();
  out[2] = r.available ? 1 : 0;
  out[3] = r.enabled ? 1 : 0;
  out[4] = static_cast<uint8_t>(r.reason);
  *out_len = 5;
  *out_flags = (r.result == FeatureResult::Ok) ? 0 : 0x02;
  return true;
}

bool SensorApi::encodeTopology(uint8_t* out, size_t out_cap, uint16_t* out_len) {
  // [mux_present, config_storage_present, num_channels,
  //  {scanned, vcnl, lps, device_count, state} x num_channels,
  //  oled_initialized]. The OLED tail is additive so older hosts retain the
  // legacy topology layout unchanged.
  const uint8_t n = kSensorNumChannels;
  const size_t need = 4u + static_cast<size_t>(n) * 5u;
  if (out_cap < need) {
    out[0] = static_cast<uint8_t>(SensorResult::Rejected);
    *out_len = 1;
    return true;
  }
  uint16_t o = 0;
  if (topo_ != nullptr && topo_->valid) {
    out[o++] = topo_->mux_present;
    out[o++] = topo_->eeprom_present;
    out[o++] = n;
    for (uint8_t i = 0; i < n; ++i) {
      const TopologySnapshot::Channel& c = topo_->channels[i];
      out[o++] = c.scanned;
      out[o++] = c.vcnl_present;
      out[o++] = c.lps_present;
      out[o++] = c.device_count;
      out[o++] = c.state;
    }
    out[o++] = topo_->oled_present;
  } else {
    // No snapshot yet: report an all-absent topology so the host gets a
    // well-formed (if empty) response rather than an error.
    out[o++] = 0;  // mux
    out[o++] = 0;  // config storage
    out[o++] = n;
    for (uint8_t i = 0; i < n; ++i) {
      out[o++] = 0;
      out[o++] = 0;
      out[o++] = 0;
      out[o++] = 0;
      out[o++] = 0;
    }
    out[o++] = 0;
  }
  *out_len = o;
  return true;
}

bool SensorApi::encodeStatus(uint8_t* out, size_t out_cap, uint16_t* out_len) {
  // [num_feet, present_mask, polling, {state, conf, prox u16, delta i16, flags}
  //  x num_feet].
  const uint8_t n = kSensorNumFeet;
  const size_t need = 3u + static_cast<size_t>(n) * 7u;
  if (out_cap < need) {
    out[0] = static_cast<uint8_t>(SensorResult::Rejected);
    *out_len = 1;
    return true;
  }
  uint16_t o = 0;
  out[o++] = n;
  out[o++] = (status_ != nullptr && status_->valid) ? status_->present_mask : 0;
  out[o++] =
      (status_ != nullptr && status_->valid) ? status_->polling_enabled : 0;
  for (uint8_t i = 0; i < n; ++i) {
    if (status_ != nullptr && status_->valid) {
      const StatusSnapshot::Foot& f = status_->feet[i];
      out[o++] = f.state;
      out[o++] = f.confidence;
      o += put16(&out[o], f.proximity);
      o += put16(&out[o], static_cast<uint16_t>(f.pressure_delta));
      out[o++] = f.flags;
    } else {
      out[o++] = 0;
      out[o++] = 0;
      o += put16(&out[o], 0);
      o += put16(&out[o], 0);
      out[o++] = 0;
    }
  }
  *out_len = o;
  return true;
}

bool SensorApi::stageCalibrate(uint8_t mask, uint8_t* out, uint16_t* out_len,
                               uint8_t* out_flags) {
  // Reject if we know (from the published snapshot) that none of the requested
  // feet have a present sensor to baseline.
  if (status_ != nullptr && status_->valid &&
      (status_->present_mask & mask) == 0) {
    out[0] = static_cast<uint8_t>(SensorResult::Rejected);
    out[1] = mask;
    *out_len = 2;
    *out_flags = 0x02;
    return true;
  }
  calibrate_mask_ = mask;
  ++calibrate_seq_;
  out[0] = static_cast<uint8_t>(SensorResult::Ok);
  out[1] = mask;
  *out_len = 2;
  return true;
}

bool SensorApi::handle(uint8_t msg_id, const uint8_t* req, uint16_t req_len,
                       uint8_t* out, size_t out_cap, uint16_t* out_len,
                       uint8_t* out_flags) {
  if (!sensormsg::isSensorMsg(msg_id)) return false;
  *out_flags = 0;

  switch (msg_id) {
    case sensormsg::kContactEnable:
      return applyFeature(Feature::FootContact, true, out, out_cap, out_len,
                          out_flags);
    case sensormsg::kContactDisable:
      return applyFeature(Feature::FootContact, false, out, out_cap, out_len,
                          out_flags);
    case sensormsg::kLevelingEnable:
      return applyFeature(Feature::TerrainLeveling, true, out, out_cap, out_len,
                          out_flags);
    case sensormsg::kLevelingDisable:
      return applyFeature(Feature::TerrainLeveling, false, out, out_cap,
                          out_len, out_flags);

    case sensormsg::kContactSetThresholds: {
      // req: [foot, near u16, touch u16, load u16]. resp echoes applied values.
      if (req_len < 7) {
        out[0] = static_cast<uint8_t>(SensorResult::BadRequest);
        *out_len = 1;
        *out_flags = 0x02;
        return true;
      }
      const uint8_t foot = req[0];
      if (foot >= kSensorNumFeet) {
        out[0] = static_cast<uint8_t>(SensorResult::BadRequest);
        *out_len = 1;
        *out_flags = 0x02;
        return true;
      }
      const uint16_t near_t = get16(&req[1]);
      const uint16_t touch_t = get16(&req[3]);
      const uint16_t load_t = get16(&req[5]);
      thresholds_.near_thresh[foot] = near_t;
      thresholds_.touch_thresh[foot] = touch_t;
      thresholds_.load_thresh[foot] = load_t;
      ++threshold_seq_;
      out[0] = static_cast<uint8_t>(SensorResult::Ok);
      out[1] = foot;
      uint16_t o = 2;
      o += put16(&out[o], near_t);
      o += put16(&out[o], touch_t);
      o += put16(&out[o], load_t);
      *out_len = o;
      return true;
    }

    case sensormsg::kLevelingSetParams: {
      // req: [max_tilt_mdeg u16, rate_mdeg_s u16, response_x255 u16].
      if (req_len < 6) {
        out[0] = static_cast<uint8_t>(SensorResult::BadRequest);
        *out_len = 1;
        *out_flags = 0x02;
        return true;
      }
      leveling_.max_tilt_mdeg = get16(&req[0]);
      leveling_.rate_mdeg_s = get16(&req[2]);
      leveling_.response_x255 = get16(&req[4]);
      ++leveling_seq_;
      out[0] = static_cast<uint8_t>(SensorResult::Ok);
      uint16_t o = 1;
      o += put16(&out[o], leveling_.max_tilt_mdeg);
      o += put16(&out[o], leveling_.rate_mdeg_s);
      o += put16(&out[o], leveling_.response_x255);
      *out_len = o;
      return true;
    }

    case sensormsg::kI2cScan: {
      // Fire-and-forget re-scan request consumed by i2cTask (the Wire owner).
      // The host polls I2C_GET_TOPOLOGY for the refreshed result.
      ++scan_seq_;
      out[0] = static_cast<uint8_t>(SensorResult::Ok);
      uint16_t o = 1;
      o += put16(&out[o], static_cast<uint16_t>(scan_seq_));
      *out_len = o;
      return true;
    }

    case sensormsg::kI2cGetTopology:
      return encodeTopology(out, out_cap, out_len);

    case sensormsg::kSensorGetStatus:
      return encodeStatus(out, out_cap, out_len);

    case sensormsg::kSensorSetRate: {
      // req: [rate_hz u16]. Staged intent (the actual poll cadence is governed
      // by the i2cTask period); reflected so the host UI can round-trip it.
      if (req_len < 2) {
        out[0] = static_cast<uint8_t>(SensorResult::BadRequest);
        *out_len = 1;
        *out_flags = 0x02;
        return true;
      }
      const uint16_t rate = get16(&req[0]);
      if (rate == 0 || rate > 1000) {
        out[0] = static_cast<uint8_t>(SensorResult::BadRequest);
        *out_len = 1;
        *out_flags = 0x02;
        return true;
      }
      rate_hz_ = rate;
      ++rate_seq_;
      out[0] = static_cast<uint8_t>(SensorResult::Ok);
      uint16_t o = 1;
      o += put16(&out[o], rate_hz_);
      *out_len = o;
      return true;
    }

    case sensormsg::kContactCalibrate: {
      // req: [foot] (foot < kSensorNumFeet for one foot, 0xFF for all feet).
      if (req_len < 1) {
        out[0] = static_cast<uint8_t>(SensorResult::BadRequest);
        *out_len = 1;
        *out_flags = 0x02;
        return true;
      }
      const uint8_t foot = req[0];
      uint8_t mask;
      if (foot == 0xFF) {
        mask = static_cast<uint8_t>((1u << kSensorNumFeet) - 1u);
      } else if (foot < kSensorNumFeet) {
        mask = static_cast<uint8_t>(1u << foot);
      } else {
        out[0] = static_cast<uint8_t>(SensorResult::BadRequest);
        *out_len = 1;
        *out_flags = 0x02;
        return true;
      }
      return stageCalibrate(mask, out, out_len, out_flags);
    }

    case sensormsg::kSensorCalibrate: {
      // Re-baseline every foot (optional [foot] arg ignored; all feet).
      const uint8_t mask = static_cast<uint8_t>((1u << kSensorNumFeet) - 1u);
      return stageCalibrate(mask, out, out_len, out_flags);
    }

    default:
      // Unhandled ids in the 0x70-0x7F block (I2C/sensor query + calibrate) are
      // added by ubs.5.2; for now report unknown so the dispatcher errors.
      return false;
  }
}

}  // namespace protocol
