vitormhenrique/hexapod/firmware/openrb150/src/app/controller_time_adapter.h

#pragma once

// Target-only conversion from the FreeRTOS scheduler clock to the portable
// ControllerTime contract. ControllerCore includes controller_time.h directly;
// only the on-target task adapter includes this header.

#include "rtos.h"

#include "../controller/controller_time.h"

namespace app {

inline controller::ControllerTime controllerTimeFromFreeRtos(
    controller::ControllerClock& clock) {
  return controller::controllerTimeFromTickCount(
      clock, static_cast<uint32_t>(xTaskGetTickCount()),
      static_cast<uint32_t>(portTICK_PERIOD_MS));
}

}  // namespace app
