vitormhenrique/hexapod/firmware/openrb150/src/app/tasks.cpp

#include "tasks.h"

#include "rtos.h"
#include "benchmark.h"

#include <Arduino.h>
#include <math.h>

#include "../board/board.h"
#include "../board/board_pins.h"
#include "../config/config_bootstrap.h"
#include "../config/config_api.h"
#include "../config/qwiic_openlog.h"
#include "../controller/controller_core.h"
#include "../dxl/dxl_bus.h"
#include "../dxl/dxl_fault_monitor.h"
#include "../dxl/hold_targets.h"
#include "../dxl/dxl_params.h"
#include "../dxl/scan_cursor.h"
#include "../dxl/servo_map.h"
#include "../gait/gait_pipeline.h"
#include "../gait/trick_engine.h"
#include "../hil/observer_api.h"
#include "../hil/output_guard.h"
#if defined(HEXAPOD_HIL_OUTPUT_DISABLED)
#include "../hil/trace_codec.h"
#include "../hil/trace_recorder.h"
#endif
#include "../input/controller_bridge.h"
#include "../input/crsf_parser.h"
#include "../input/crsf_telemetry.h"
#include "../input/rc_frame_snapshot.h"
#include "../logging/capture_log.h"
#include "../protocol/api.h"
#include "../protocol/control_api.h"
#include "../protocol/controller_api.h"
#include "../protocol/dxl_job_api.h"
#include "../protocol/feature_api.h"
#include "../protocol/frame_reader.h"
#include "../protocol/framing.h"
#include "../protocol/maintenance_api.h"
#include "../protocol/maintenance_target_api.h"
#include "../protocol/motion_api.h"
#include "../protocol/passive_api.h"
#include "../protocol/sensor_api.h"
#include "../protocol/telemetry.h"
#include "../protocol/telemetry_encode.h"
#include "../sensors/bno085.h"
#include "../sensors/contact_estimator.h"
#include "../sensors/finger_sensor.h"
#include "../sensors/i2c_bus.h"
#include "../sensors/qwiic_debug_oled.h"
#include "../safety/command_arbiter.h"
#include "../safety/error_journal.h"
#include "../safety/event_log.h"
#include "../safety/fault_capture.h"
#include "../safety/state_machine.h"
#include "../safety/system_state.h"
#include "../safety/watchdog.h"
#include "task_config.h"
#include "controller_time_adapter.h"
#include "status_led.h"

#ifndef HEXAPOD_I2C_CLOCK_HZ
#define HEXAPOD_I2C_CLOCK_HZ 100000UL
#endif

namespace app {
namespace {

#if defined(ARDUINO_ARCH_SAMD)
// Boot-time FreeRTOS heap budget. Only meaningful on the SAMD21 port, whose
// project-owned freertos_config.h sizes a fixed configTOTAL_HEAP_SIZE. The
// Teensy port allocates task stacks through the (guarded) newlib heap in the
// 512 KB OCRAM region, so no compile-time budget is needed there.
constexpr size_t kHeapAlignmentBytes = 8;
constexpr size_t kHeapBlockHeaderBytes = 8;
constexpr size_t kHeapReserveBytes = 512;

constexpr size_t heapBlockBytes(size_t requested) {
  return (requested + kHeapBlockHeaderBytes + kHeapAlignmentBytes - 1u) &
     ~(kHeapAlignmentBytes - 1u);
}

constexpr size_t taskHeapBytes(uint16_t stack_words) {
  return heapBlockBytes(static_cast<size_t>(stack_words) * sizeof(StackType_t)) +
     heapBlockBytes(sizeof(StaticTask_t));
}

constexpr size_t kStartupTaskHeapBytes =
  taskHeapBytes(stack_words::kControl) + taskHeapBytes(stack_words::kDxl) +
  taskHeapBytes(stack_words::kRc) + taskHeapBytes(stack_words::kApi) +
  taskHeapBytes(stack_words::kI2c) + taskHeapBytes(stack_words::kHealth) +
  taskHeapBytes(configMINIMAL_STACK_SIZE);
constexpr size_t kStartupSemaphoreHeapBytes =
  3u * heapBlockBytes(sizeof(StaticSemaphore_t));

static_assert(configUSE_TIMERS == 0,
        "unused FreeRTOS timer daemon must stay disabled");
static_assert(configTOTAL_HEAP_SIZE >=
          kStartupTaskHeapBytes + kStartupSemaphoreHeapBytes +
            kHeapReserveBytes + (kHeapAlignmentBytes - 1u),
        "FreeRTOS heap no longer covers boot allocations plus reserve");
#endif  // ARDUINO_ARCH_SAMD

static_assert(priority::kHealth < configMAX_PRIORITIES,
        "FreeRTOS priority table must include healthTask");

// Task handles, indexed by watchdog::TaskId, so the health task can read each
// task's stack high-water mark.
TaskHandle_t g_handles[watchdog::kTaskCount] = {nullptr};

// Static description of this firmware build, reported by HELLO/GET_CAPABILITIES.
protocol::api::DeviceInfo g_deviceInfo;
uint8_t g_resetCause = 0;

// Single owner of the DYNAMIXEL TTL bus. Only dxlTask touches this,
// satisfying the AGENTS.md rule that one task owns Dynamixel2Arduino and its
// UART. The port and (optional) direction pin come from the board pin map.
dxl::DxlBus g_dxlBus(HEXAPOD_DXL_SERIAL, board::pins::kDxlDirPin);

// Latest per-servo status snapshot, published by dxlTask via Sync Read and read
// by telemetry/safety consumers. Single writer (dxlTask); readers take a copy.
dxl::ServoStatus g_servoStatus[dxl::DxlBus::kMaxServos];
volatile uint8_t g_servoStatusCount = 0;
volatile bool g_configuredServoCoverage = false;
volatile uint32_t g_poseKnownMask = 0;
volatile uint32_t g_servoReadinessConfigRev = 0;
volatile bool g_dxlArmingReady = false;
constexpr uint32_t kAllServoPosesKnown =
  (1u << config::kNumServos) - 1u;
// CRSF/ExpressLRS RC input state. Owned exclusively by rcTask (Serial3).
crsf::Parser g_crsfParser;
crsf::RcStatus g_rcStatus;

// Raw RC diagnostics snapshot (a8n): the CRSF layer the parsed g_rcStatus hides
// -- raw 11-bit ticks, frame-health counters, and decoded LINK_STATISTICS. Sole
// writer is rcTask; telemetry reads a copy for the rc_diagnostics stream and the
// companion RC troubleshooting page. Plain aggregate so {} value-initializes it
// to a safe zero state (no link seen, ticks 0).
struct RcDiagSnapshot {
  uint16_t raw_ticks[crsf::kNumChannels];
  uint32_t frames_decoded;
  uint32_t crc_errors;
  uint32_t link_stats_count;
  uint32_t last_frame_ms;
  bool ever_seen;
  bool failsafe;
  bool has_link_stats;
  crsf::LinkStatistics link_stats;
};
RcDiagSnapshot g_rcDiag{};

// Controller bridge (oha.2/oha.3): decodes the ChannelPack CRSF frame into a
// high-level ControllerCommand (modes, twist, body pose, gait, shape, tricks,
// arm/estop, feature requests). rcTask is the sole writer; controlTask reads a
// copy of the published snapshot each cycle. The derived RcStatus above feeds
// the existing safety FSM / arbiter / telemetry plumbing unchanged.
controller::ControllerBridge g_bridge;
controller::ControllerCommand g_ctrlCmd;
controller::RcFrameMailbox g_rcMailbox;
controller::RcFrameSnapshot g_controlRcSnapshot;
bool g_controlRcSnapshotValid = false;
// ConfigApi is owned by apiTask, while ControllerBridge is owned by rcTask.
// controlTask already consumes a validated, revisioned config snapshot; it
// publishes this small calibration block to rcTask so the bridge never reads a
// partially replaced RobotConfig directly.
config::RcInputCalibration g_pendingRcCalibration;
volatile uint32_t g_pendingRcCalibrationRevision = 0;
volatile bool g_pendingRcCalibrationValid = false;

volatile uint8_t g_commandSource = 0;       // safety::CommandSource value
volatile bool g_motionAuthorized = false;   // a source may drive servos
volatile bool g_killActive = true;          // RC kill / host estop asserted

// Only controlTask advances this adapter clock. It translates the FreeRTOS
// scheduler timestamp into the portable ControllerTime contract without making
// the future ControllerCore depend on FreeRTOS.
controller::ControllerClock g_controlClock(period_ms::kControl);
volatile uint8_t g_safetyState = static_cast<uint8_t>(safety::State::Boot);
volatile uint8_t g_faultReason = 0;  // safety::FaultReason value
volatile uint8_t g_lastFaultReason = 0;  // safety::FaultReason value
volatile uint32_t g_lastFaultTimestampMs = 0;
// True only when the current state permits motion AND a source owns authority.
volatile bool g_motionGate = false;
// True once i2cTask has finished its boot scan and seeded a (persisted or
// default) config; gates the ConfigLoad -> Disarmed transition.
volatile bool g_configReady = false;

// Battery voltage snapshot, published by controlTask each cycle. controlTask is
// the sole analogRead() caller: the SAMD21 core's analogRead busy-waits
// unbounded on RESRDY and disables the ADC on completion, so a second task
// reading concurrently can be preempted mid-conversion and spin forever on a
// flag that never sets (observed on hardware: apiTask wedged at priority 2,
// starving healthTask's WDT pet -> hardware reset ~2 s after every host
// request). All other tasks must read this snapshot, never the ADC.
volatile uint16_t g_batteryMv = 0;
volatile bool g_batteryValid = false;
bool g_batterySampled = false;
uint32_t g_lastBatterySampleMs = 0;
constexpr uint32_t kBatterySamplePeriodMs = 100;

// Telemetry subscription manager. apiTask routes the telemetry command range to
// it and walks the streams each loop, emitting due telemetry frames over USB.
protocol::SubscriptionManager g_subs;
#if defined(HEXAPOD_BENCHMARK)
bool g_benchmarkSessionActive = false;
#endif

// USB frame reader + rx-health counters (hexapod_src-lv6). Owned exclusively by
// apiTask (which also builds api_stats telemetry, so no cross-task access):
// g_frameReader counts complete frame bodies (framesOk) and overflow-dropped
// frames; g_apiRxBad counts bodies that failed COBS/CRC/magic/length decode.
protocol::FrameReader g_frameReader;
uint32_t g_apiRxBad = 0;

// Host safety control intent (ESTOP/CLEAR_FAULT/SET_ARMING/SET_MODE). apiTask
// records host intent into it; controlTask folds that intent into the safety
// state machine each cycle and publishes the live state/fault back for command
// responses to echo.
protocol::ControlApi g_controlApi;

// Host high-level motion intent (SET_GAIT/SET_GAIT_PARAMS/SET_BODY_TWIST/
// SET_BODY_POSE/STOP_MOTION). apiTask validates+stores the latest clamped
// MotionIntent here; controlTask echoes the live motion gate back so the host
// knows whether the intent is being honored. The goal-generation (gait/IK)
// path consumes g_motionApi.intent() and is gated by g_motionGate.
protocol::MotionApi g_motionApi;

// Servo goal frame published by controlTask's gait/IK pipeline (lmt.1) and
// consumed by dxlTask's Sync Write (lmt.2). Single writer (controlTask) and two
// readers (dxlTask drives the bus, apiTask renders the servo_goals telemetry),
// guarded by a briefly-held mutex (the critical section is a small fixed copy,
// so no task blocks meaningfully). Stores the full per-joint result (id, tick,
// leg, joint, clamped) so the goal-write path and the clamp-flag telemetry
// (audit 22l.3) share one source of truth. g_goalValid is cleared whenever
// motion is not gated open, so neither the bus write nor the telemetry renders
// a stale frame once authority is lost.
struct GoalFrame {
  uint8_t count = 0;
  gait::PipelineJoint joints[config::kNumServos];
  gait::PipelineLegTarget legs[config::kNumLegs];
  logging::AppliedMotionCapture applied;
};
GoalFrame g_goalFrame;
SemaphoreHandle_t g_goalMutex = nullptr;  // guards g_goalFrame
volatile bool g_goalValid = false;        // a fresh, gated goal frame is ready
volatile uint32_t g_goalSeq = 0;          // bumped on each published frame
// Max time dxlTask blocks to acquire g_goalMutex before falling back to the
// previously latched goal. controlTask (100 Hz, equal priority) holds the mutex
// only for a small fixed copy, so this bound is never meaningfully consumed; it
// exists purely to break the equal-priority zero-wait phase-lock that starved
// the reader for frames of >=16 joints (see dxlTask goal-write path).
constexpr uint32_t kGoalReadWaitMs = 4;
// True when the last published frame saturated any joint against the configured
// servo travel; surfaced for clamp diagnostics (lmt.2 / audit 22l.3).
volatile bool g_goalClamped = false;


// Host maintenance lock (ENTER/EXIT/HEARTBEAT). apiTask drives the lock token +
// TTL here; controlTask reads lockHeld() to feed the safety FSM's maintenance
// inputs and force-revokes the lock on E-stop / fault.
protocol::MaintenanceApi g_maintApi;

// Host maintenance leg/joint targets (SET_LEG_TARGET/SET_JOINT_TARGET). Runs the
// foot/joint request through body+leg IK and the servo map, storing clamped
// goal ticks. Only honored while in MacMaintenance with the lock held; the goal
// write path consumes the stored targets under MacMaintenance authority.
protocol::MaintTargetApi g_maintTargetApi;

// Host DXL maintenance command queue (DXL_SCAN/PING/TORQUE/PROFILE). apiTask
// enqueues a gated job here; dxlTask is the sole executor (it owns the bus) and
// writes the serialized result back for the host to poll via DXL_GET_RESULT.
protocol::DxlJobApi g_dxlJobApi;

// A DXL scan keeps the maintenance queue slot Running while it advances one
// ping per dxlTask iteration. The queue remains single-slot, but absent IDs no
// longer turn one host request into a watchdog-starving busy-wait burst.
struct DxlScanJobState {
  bool active = false;
  uint8_t job_id = 0;
  dxl::ScanCursor cursor;
};
DxlScanJobState g_dxlScanJob;

// Host feature-flag command surface (FEATURE_GET/SET/GET_REASONS/RESET). Stores
// the host's desired enable set; controlTask publishes per-feature availability
// each cycle and consumes the desired set to drive the real toggles. Effective
// enabled = desired && available, so the firmware can auto-disable a feature
// (e.g. when its hardware disappears) without losing the host's intent.
protocol::FeatureApi g_featureApi;

// Host sensor / contact / leveling command surface (CONTACT_*/LEVELING_*/
// I2C_*/SENSOR_*). Enable/disable route through g_featureApi (single source of
// truth); CONTACT_SET_THRESHOLDS stages per-foot thresholds consumed by i2cTask
// (the contact-estimator owner). Wired to g_featureApi once at apiTask startup.
protocol::SensorApi g_sensorApi;

// Published snapshots the SensorApi reads (apiTask) and i2cTask keeps current:
// the I2C topology (refreshed on each scan) and the fused foot-contact status.
// Single-writer (i2cTask) / multi-reader PODs, like g_footState.
protocol::TopologySnapshot g_sensorTopoSnap;
protocol::StatusSnapshot g_sensorStatusSnap;

// Host passive pose streaming command surface (PASSIVE_ENTER/EXIT/
// SET_STREAM_RATE/ZERO_REFERENCE). apiTask records the host's request here;
// controlTask folds requested() into the safety FSM (only enters
// PassivePoseStream once torque is confirmed off) and force-clears it on
// E-stop / fault.
protocol::PassiveApi g_passiveApi;

// Host controller command surface (CONTROLLER_GET_STATE/GET_BINDINGS/
// SET_BINDINGS, oha.4). apiTask refreshes its reported snapshot (decoded
// command + raw inputs + active bindings) before each request and, after a
// SET_BINDINGS, hands the staged BindingConfig to rcTask via the pending
// hand-off below (rcTask owns the ControllerBridge, so apiTask never touches
// it directly). Also feeds the controller_state telemetry stream.
protocol::ControllerApi g_controllerApi;

// HIL observer state exists only in the output-disabled image. The normal
// image answers the reserved command range statelessly with NotAvailable.
#if defined(HEXAPOD_HIL_OUTPUT_DISABLED)
hil::ObserverApi g_hilObserver;
#endif

#if defined(HEXAPOD_HIL_OUTPUT_DISABLED)
// The recorder has one fixed producer/consumer record handoff. This separate
// ring carries only tiny capture-control messages from apiTask to controlTask,
// so a serial request never mutates recorder state directly.
enum class HilTraceRequestType : uint8_t { Capture, Abort, Marker };

struct HilTraceRequest {
  HilTraceRequestType type = HilTraceRequestType::Capture;
  uint32_t session_id = 0;
  uint32_t capture_id = 0;
  uint32_t value = 0;
};

class HilTraceRequestRing {
 public:
  static constexpr uint8_t kCapacity = 4;

  bool hasSpace() const {
    taskENTER_CRITICAL();
    const bool available = count_ < kCapacity;
    taskEXIT_CRITICAL();
    return available;
  }

  bool push(const HilTraceRequest& request) {
    taskENTER_CRITICAL();
    if (count_ >= kCapacity) {
      taskEXIT_CRITICAL();
      return false;
    }
    entries_[write_index_] = request;
    write_index_ = static_cast<uint8_t>((write_index_ + 1u) % kCapacity);
    ++count_;
    taskEXIT_CRITICAL();
    return true;
  }

  bool pop(HilTraceRequest* request) {
    if (request == nullptr) return false;
    taskENTER_CRITICAL();
    if (count_ == 0) {
      taskEXIT_CRITICAL();
      return false;
    }
    *request = entries_[read_index_];
    read_index_ = static_cast<uint8_t>((read_index_ + 1u) % kCapacity);
    --count_;
    taskEXIT_CRITICAL();
    return true;
  }

 private:
  HilTraceRequest entries_[kCapacity] = {};
  uint8_t read_index_ = 0;
  uint8_t write_index_ = 0;
  uint8_t count_ = 0;
};

hil::trace::TraceRecorder g_hilTrace;
HilTraceRequestRing g_hilTraceRequests;
uint16_t g_hilTraceEventSeq = 0;
#endif

// Published controller snapshots (single writer rcTask, reader apiTask). Raw
// decoded ChannelPack inputs + the bridge's active binding map, copied each RC
// cycle so apiTask can report them without touching the bridge.
ChannelPackInputs_t g_ctrlRaw{};
controller::BindingConfig g_ctrlBindings;

// Lock-free bindings hand-off: apiTask stages a validated BindingConfig and
// sets the flag; rcTask adopts it into the bridge and clears the flag. Single
// producer (apiTask) / single consumer (rcTask); a SET_BINDINGS is rare and
// human-driven, and the bridge re-clamps all motion regardless, so a one-frame
// torn read is benign and self-corrected by the next adoption.
controller::BindingConfig g_ctrlPendingBindings;
volatile bool g_ctrlPendingBindingsValid = false;

// Torque-off confirmation published by dxlTask. The control task feeds this to
// the safety FSM as StateInputs.torque_off so PassivePoseStream is only entered
// when no servo is driven. Starts true (DXL power + torque are OFF at boot) and
// is set true again after dxlTask disables torque; the goal-write/torque-enable
// path (when wired) is the only place that clears it.
volatile bool g_dxlTorqueOff = true;
// Per-discovered-servo torque-off choices made through the maintenance logical
// parameter API. A released joint must stay limp even while maintenance goal
// frames continue and another torque-on path runs. dxlTask owns this mask.
uint32_t g_maintenanceReleasedMask = 0;
// Servos commanded through the generic maintenance Goal Position parameter.
// These IDs are excluded from the mapped controller Sync Write until
// maintenance ends, so their verified direct goals are not overwritten.
uint32_t g_maintenanceDirectGoalMask = 0;

bool maintenanceServoReleased(uint8_t id) {
  for (uint8_t i = 0; i < g_dxlBus.servoCount(); ++i) {
    if (g_dxlBus.profile(i).id == id) {
      return (g_maintenanceReleasedMask & (uint32_t{1} << i)) != 0;
    }
  }
  return false;
}

bool maintenanceServoDirect(uint8_t id) {
  for (uint8_t i = 0; i < g_dxlBus.servoCount(); ++i) {
    if (g_dxlBus.profile(i).id == id) {
      return (g_maintenanceDirectGoalMask & (uint32_t{1} << i)) != 0;
    }
  }
  return false;
}

// Hard DXL fault published by dxlTask (lmt.5). Set when a servo reports a
// hardware error bit (MX 2.0 Hardware Error Status) or the bus stops answering
// the present-status Sync Read for a sustained window. The control task feeds
// this to the safety FSM as StateInputs.dxl_hard_fault, which latches FaultHard
// until an operator CLEAR_FAULT and the underlying condition both clear. Starts
// false; only meaningful once a maintenance scan has populated the servo table.
volatile bool g_dxlHardFault = false;

// CRSF runs at 420000 baud on the OpenRB-150 D14 TX / D13 RX UART (Serial3).
constexpr uint32_t kCrsfBaud = 420000;
constexpr uint32_t kCrsfStatusPeriodMs = 200;    // 5 Hz
// While the operator is editing gait parameters from the handset the status
// frame is the feedback loop for the edit, so it is sent as fast as the RC
// cycle allows. rcTask still emits at most one telemetry frame per 10 ms cycle
// and still checks UART TX capacity first, so this can never starve RC parsing.
constexpr uint32_t kCrsfStatusBoostPeriodMs = 50;  // 20 Hz
// How long a boost lasts after the last gait-tune edit.
constexpr uint32_t kCrsfStatusBoostHoldMs = 3000;
constexpr uint32_t kCrsfAttitudePeriodMs = 100;  // 10 Hz
constexpr uint32_t kCrsfBatteryPeriodMs = 500;   // 2 Hz
constexpr uint32_t kImuFreshMs = 250;

// controlTask publishes this complete operator-facing snapshot; rcTask copies
// it atomically before adding i2cTask's IMU status and serializing a frame.
crsf::telemetry::HexapodStatus g_radioStatus;
// Set by controlTask while the handset gait-tune editor is engaged so rcTask
// raises the status-frame rate for the duration of the edit session.
volatile bool g_radioStatusBoost = false;

// Deduplicated firmware error journal (hexapod_src error reporting). Producers
// live in several tasks, so every access is wrapped in a short critical section
// by noteError()/takeError(); note() is bounded to a 12-entry table scan.
safety::ErrorJournal g_errorJournal;
safety::PersistentEventQueue g_persistentEvents;

void noteError(safety::ErrorCode code, uint8_t detail,
               safety::ErrorSeverity severity, uint32_t now_ms) {
  taskENTER_CRITICAL();
  const bool announced = g_errorJournal.note(code, detail, severity, now_ms);
  if (announced && severity != safety::ErrorSeverity::Info) {
    safety::PersistentEvent event;
    event.timestamp_ms = now_ms;
    event.code = code;
    event.detail = detail;
    event.severity = severity;
    g_persistentEvents.push(event);
  }
  taskEXIT_CRITICAL();
}


// Single owner of the root I2C bus (SERCOM0): mux, OpenLog, OLED, and muxed foot
// sensors. Only i2cTask touches this. Topology is the boot-scan
// result describing which optional devices were found.
i2c::I2cBus g_i2cBus;
i2c::I2cTopology g_i2cTopology;
sensors::Bno085 g_bno085(g_i2cBus);

struct ImuSnapshot {
  int16_t pitch_cdeg = 0;
  int16_t roll_cdeg = 0;
  int16_t yaw_cdeg = 0;
  uint8_t calibration = 0;
  bool present = false;
  bool valid = false;
  uint32_t sample_ms = 0;
};
ImuSnapshot g_imuSnapshot;

// Foot contact pipeline. The reader does bounded I2C/mux register I/O,
// the estimator runs the portable contact state machine, and the published
// snapshot is read by telemetry/safety consumers. All owned by i2cTask.
sensors::FingerSensorReader g_finger(g_i2cBus);
sensors::ContactEstimator g_contact;
sensors::LegContactState g_footState[sensors::kNumFeet];
volatile uint8_t g_footPresentMask = 0;
// Runtime sensor-polling toggle (feature.foot_sensor polling). Defaults on so
// present boards stream raw proximity/pressure; contact classification stays
// disabled per-foot until calibrated (FootSensorCal.enabled).
volatile bool g_sensorPollingEnabled = true;
volatile uint32_t g_i2cLastUpdateMs = 0;
constexpr uint32_t kI2cStaleMs = 500;

// CONFIG.TXT is a hex-encoded append journal containing the complete serialized
// RobotConfig. EVENTS.LOG is reserved for plain-text runtime diagnostics.
config::QwiicOpenLog g_openlog(g_i2cBus);
config::QwiicConfigFile g_configFile(g_openlog);
config::ConfigStore g_configStore(g_configFile);
bool g_configStorageAvailable = false;
bool g_configVolatile = true;
bool g_retainedCrashLogPending = false;
bool g_watchdogResetLogPending = false;
bool g_configBootstrapPending = false;
bool g_oledInitPending = false;
sensors::QwiicDebugOled g_debugOled(g_i2cBus);
sensors::DebugDisplayState g_debugDisplayState;

struct CaptureRuntime {
  bool recording = false;
  uint32_t handled_toggle_seq = 0;
  uint32_t handled_start_seq = 0;
  uint32_t session = 0;
  uint32_t sample = 0;
  uint32_t completed_samples = 0;
  uint32_t sample_ms = 0;
  uint32_t sample_file_size = 0;
  uint16_t sample_bytes = 0;
  uint32_t next_sample_ms = 0;
  uint8_t row = 0xFF;
  uint8_t servo_count = 0;
  uint8_t servo_index = 0;
  uint8_t goal_count = 0;
  uint8_t goal_index = 0;
  bool goal_valid = false;
  logging::RemoteCapture remote;
  logging::AppliedMotionCapture motion;
  logging::GoalCapture goals[config::kNumServos];
  gait::PipelineLegTarget legs[config::kNumLegs];
  dxl::ServoStatus servos[config::kNumServos];
  int16_t present_angle_centideg[config::kNumServos];
};

CaptureRuntime g_capture;
char g_captureLine[256];
constexpr uint32_t kCaptureIntervalMs = 500;
constexpr uint8_t kCaptureNoRow = 0xFF;
constexpr uint8_t kCaptureRowRemote = 0;
constexpr uint8_t kCaptureRowControl = 1;
constexpr uint8_t kCaptureRowLegs = 2;
constexpr uint8_t kCaptureRowGoals = 3;
constexpr uint8_t kCaptureRowServos = 4;
constexpr uint8_t kCaptureGoalsPerRow = 6;
constexpr const char* kCaptureFile = "CAPTURE.CSV";

bool openLogFileGrew(const char* file_name, uint32_t size_before,
                     uint32_t expected_growth) {
  uint32_t size_after = 0;
  bool exists_after = false;
  return g_openlog.fileSize(file_name, size_after, exists_after) &&
         exists_after && size_after >= size_before + expected_growth;
}

bool appendOpenLogLine(const char* file_name, const char* line, size_t len,
                       bool sync) {
  uint32_t size_before = 0;
  bool existed_before = false;
  if (!g_openlog.fileSize(file_name, size_before, existed_before)) return false;
  size_t offset = 0;
  while (offset < len) {
    const size_t remaining = len - offset;
    const uint8_t count = remaining < config::QwiicOpenLog::kMaxWriteBytes
                              ? static_cast<uint8_t>(remaining)
                              : config::QwiicOpenLog::kMaxWriteBytes;
    if (!g_openlog.append(file_name,
                          reinterpret_cast<const uint8_t*>(line + offset),
                          count)) {
      return false;
    }
    offset += count;
  }
  return !sync ||
         (g_openlog.sync() && openLogFileGrew(file_name, size_before,
                                               static_cast<uint32_t>(len)));
}

bool appendEventLogLine(const char* line, size_t len) {
  return appendOpenLogLine("EVENTS.LOG", line, len, true);
}

bool tryPersistRetainedCrash() {
  if (!g_retainedCrashLogPending) return true;
  const size_t length = safety::formatCrashLog(
      fault_capture::lastSnapshot(), g_captureLine, sizeof(g_captureLine));
  if (length == 0) {
    g_retainedCrashLogPending = false;
    return true;
  }
  uint32_t size_before = 0;
  bool existed_before = false;
  if (!g_openlog.fileSize("EVENTS.LOG", size_before, existed_before)) {
    return false;
  }
  if (!appendEventLogLine(g_captureLine, length)) return false;
  uint32_t size_after = 0;
  bool exists_after = false;
  if (!g_openlog.fileSize("EVENTS.LOG", size_after, exists_after) ||
      !exists_after || size_after < size_before + length) {
    return false;
  }
  fault_capture::acknowledgePersisted();
  g_retainedCrashLogPending = false;
  return true;
}

bool tryPersistWatchdogReset() {
  if (!g_watchdogResetLogPending) return true;
  const size_t length = safety::formatWatchdogResetLog(
      watchdog::lastResetMissedMask(), watchdog::lastResetProgressMarker(),
      watchdog::lastResetControlProgress(), watchdog::lastResetSafetyState(),
      g_captureLine, sizeof(g_captureLine));
  uint32_t size_before = 0;
  bool existed_before = false;
  if (length == 0 ||
      !g_openlog.fileSize("EVENTS.LOG", size_before, existed_before) ||
      !appendEventLogLine(g_captureLine, length)) {
    return false;
  }
  uint32_t size_after = 0;
  bool exists_after = false;
  if (!g_openlog.fileSize("EVENTS.LOG", size_after, exists_after) ||
      !exists_after || size_after < size_before + length) {
    return false;
  }
  g_watchdogResetLogPending = false;
  return true;
}

// --- Cross-task config plumbing (AGENTS.md 5.1: only i2cTask touches I2C) ---
//
// The config API runs in apiTask (it parses USB frames), but the storage commit
// is an I2C transaction that only i2cTask is allowed to perform. So apiTask
// edits/validates a RAM shadow locally, and a CFG_COMMIT hands the validated
// serialized payload to i2cTask through this mailbox and blocks (bounded) for
// the result. A separate one-shot boot-load buffer lets i2cTask pass a valid
// persisted config to apiTask so the ConfigApi shadow is still touched by only
// one task.
struct CommitMailbox {
  bool requested = false;
  bool ok = false;
  uint16_t len = 0;
  uint8_t payload[config::kConfigPayloadSize] = {0};
};
CommitMailbox g_commit;
SemaphoreHandle_t g_commitMutex = nullptr;  // guards g_commit
SemaphoreHandle_t g_commitDone = nullptr;   // i2cTask -> apiTask completion

struct BootLoad {
  bool ready = false;     // a valid persisted payload was loaded at boot
  bool consumed = false;  // apiTask has adopted it
  uint16_t len = 0;
  uint8_t payload[config::kConfigPayloadSize] = {0};
};
BootLoad g_bootLoad;

bool tryBootstrapConfig(const config::RobotConfig& defaults) {
  if (!g_configBootstrapPending) return true;
  const uint16_t defaults_len = config::serializeRobotConfig(
      defaults, g_bootLoad.payload, sizeof(g_bootLoad.payload));
  uint16_t loaded_len = 0;
  const config::BootstrapResult bootstrap =
      defaults_len == config::kConfigPayloadSize
          ? config::loadOrInitializeConfig(
                g_configFile, g_configStore, g_bootLoad.payload, defaults_len,
                g_bootLoad.payload, sizeof(g_bootLoad.payload), loaded_len)
          : config::BootstrapResult::StorageError;
  if (bootstrap == config::BootstrapResult::StorageError) {
    return false;
  }
  g_bootLoad.len = loaded_len;
  g_bootLoad.ready = true;
  g_configVolatile = false;
  g_configBootstrapPending = false;
  return true;
}

// Persistence sink used by the config API. commitPayload() is called from
// apiTask; it forwards the bytes to i2cTask and waits for the transaction.
class TaskConfigPersistence : public config::ConfigPersistence {
 public:
  bool commitPayload(const uint8_t* payload, uint16_t len) override {
    if (g_commitMutex == nullptr || g_commitDone == nullptr) return false;
    if (len > sizeof(g_commit.payload)) return false;
    if (xSemaphoreTake(g_commitMutex, pdMS_TO_TICKS(50)) != pdTRUE) {
      return false;
    }
    memcpy(g_commit.payload, payload, len);
    g_commit.len = len;
    g_commit.ok = false;
    g_commit.requested = true;
    xSemaphoreGive(g_commitMutex);
    // Wait for i2cTask to append and sync the OpenLog transaction.
    if (xSemaphoreTake(g_commitDone, pdMS_TO_TICKS(1500)) != pdTRUE) {
      return false;  // timed out
    }
    if (xSemaphoreTake(g_commitMutex, pdMS_TO_TICKS(50)) != pdTRUE) {
      return false;
    }
    const bool ok = g_commit.ok;
    xSemaphoreGive(g_commitMutex);
    return ok;
  }
  bool persistent() const override {
    return g_configStorageAvailable && !g_configVolatile;
  }
};

TaskConfigPersistence g_configPersist;
config::ConfigApi g_configApi(g_configPersist);

// Handset "save gait settings" hand-off. controlTask decides *whether* a save
// is allowed and stages the values; apiTask (the sole ConfigApi owner) runs the
// transaction. Guarded by short critical sections; the sequence comparison in
// controlTask makes the hand-off exactly-once.
config::GaitDefaults g_gaitSavePending;
volatile bool g_gaitSaveRequested = false;
uint32_t g_gaitSaveHandledSeq = 0;
// Battery level that starts warning the operator on the downlink. Above the
// safety FSM's cut-out, so it is advisory rather than a fault.
constexpr uint16_t kBatteryWarnMv = 10200;

// The portable controller owns algorithmic state. The snapshots below belong
// to the FreeRTOS adapter and stay static so the 384-word control-task stack
// is reserved for the existing gait/DXL call chains rather than large copies.
controller::ControllerCore g_controllerCore;
controller::RobotState g_controllerState;
controller::ControllerIntent g_controllerIntent;
controller::ControllerConfigSnapshot g_controllerConfig;
controller::RobotCommand g_controllerCommand;
uint32_t g_controllerConfigRevision = 0xFFFFFFFFu;

void initDeviceInfo() {
  g_deviceInfo.fw_major = 0;
  g_deviceInfo.fw_minor = 1;
  g_deviceInfo.fw_patch = 0;
  // Refreshed live from runtime feature availability before each request in
  // apiTask (4sa.4); this boot value just means "nothing available yet".
  g_deviceInfo.feature_bits = 0;
  const char name[] = "OpenRB150-Hex";
  size_t i = 0;
  for (; name[i] != '\0' && i < protocol::api::kDeviceNameLen; ++i) {
    g_deviceInfo.device_name[i] = name[i];
  }
  for (; i < protocol::api::kDeviceNameLen; ++i) {
    g_deviceInfo.device_name[i] = 0;
  }
}

inline void tick(watchdog::TaskId id) {
  watchdog::checkIn(id);
}

#if defined(HEXAPOD_BENCHMARK)
inline uint32_t benchmarkNowUs() { return micros(); }

inline void finishBenchmarkTask(benchmark::Task task, uint32_t started_us,
                                uint32_t period_ms) {
  benchmark::g_collector.recordTask(task, started_us, micros(),
                                    period_ms * 1000u);
}
#else
inline uint32_t benchmarkNowUs() { return 0; }
inline void finishBenchmarkTask(benchmark::Task, uint32_t, uint32_t) {}
#endif

// A full all-servo torque seed performs up to 18 bounded writes. Service the
// DXL heartbeat and yield between them so the 500 ms health window measures
// actual progress rather than treating intentional serial work as a stall.
void cooperativeDxlService() {
  tick(watchdog::TaskId::Dxl);
  vTaskDelay(pdMS_TO_TICKS(1));
}

// --- Telemetry payload encoding -------------------------------------------
// Little-endian writers for building telemetry frame payloads in place.
inline uint16_t put16(uint8_t* p, uint16_t v) {
  p[0] = static_cast<uint8_t>(v & 0xFF);
  p[1] = static_cast<uint8_t>((v >> 8) & 0xFF);
  return 2;
}
inline uint16_t put32(uint8_t* p, uint32_t v) {
  p[0] = static_cast<uint8_t>(v & 0xFF);
  p[1] = static_cast<uint8_t>((v >> 8) & 0xFF);
  p[2] = static_cast<uint8_t>((v >> 16) & 0xFF);
  p[3] = static_cast<uint8_t>((v >> 24) & 0xFF);
  return 4;
}

uint8_t packHilFlags(const hil::OutputGuardStatus& status) {
  uint8_t flags = 0;
  if (status.output_disabled) flags |= protocol::api::hilflag::kOutputDisabled;
  if (status.power_guard_active) {
    flags |= protocol::api::hilflag::kPowerGuardActive;
  }
  if (status.torque_guard_active) {
    flags |= protocol::api::hilflag::kTorqueGuardActive;
  }
  if (status.goal_guard_active) {
    flags |= protocol::api::hilflag::kGoalGuardActive;
  }
  if (status.write_guard_active) {
    flags |= protocol::api::hilflag::kWriteGuardActive;
  }
  return flags;
}

// Write one complete wire frame to USB CDC, reporting whether every byte was
// accepted. The stock SAMD21 core is unbuffered: Serial.availableForWrite()
// returns a constant (EPX_SIZE-1 = 63), so gating on it silently discarded
// every frame larger than one endpoint packet (servo_status is ~270 wire
// bytes and never reached the host).
//
// HIL bug (hexapod_src-2e8, plot workbench soak): a plain Serial.write(frame,
// n) tears most multi-packet frames. USBDeviceClass::send() waits for the
// previous 64-byte packet by polling the endpoint's TRCPT1 interrupt flag,
// but the core's USB ISR (USBCore.cpp ISRHandler -> epAckPendingInterrupts)
// clears that same flag first, so the poll spins the full 70 ms TX timeout
// and send() aborts mid-frame: exactly 128 bytes (two packets) hit the wire,
// the host resyncs on the next frame's 0x00 delimiter, and each torn frame
// also stalls apiTask ~70 ms (observed: >60% of servo_status frames torn even
// at 10 Hz).
//
// Fix: feed the core one sub-packet (<= 63 byte) chunk at a time and gate
// each chunk on the endpoint's BK1RDY hardware status bit, which is cleared
// by hardware when the bank drains and is never touched by the ISR. send()
// then always takes its fast path (bank idle -> copy, arm, return) and never
// enters the racy TRCPT1 wait. The inter-chunk wait yields via vTaskDelay and
// is bounded, so a wedged host (stopped draining) costs at most ~20 ms before
// the frame is dropped and counted as TX backlog by the caller.
bool txFrame(const uint8_t* frame, size_t n) {
#if defined(ARDUINO_ARCH_SAMD)
  // CDC is the only PluggableUSB module, so its endpoints are 1 (ACM), 2
  // (OUT), 3 (IN) — see CDC.cpp CDC_ENDPOINT_IN = pluggedEndpoint + 2.
  constexpr uint8_t kCdcInEp = 3;
  constexpr uint32_t kBankDrainTimeoutMs = 20;
  size_t off = 0;
  while (off < n) {
    uint32_t waited_ms = 0;
    while (USB->DEVICE.DeviceEndpoint[kCdcInEp].EPSTATUS.bit.BK1RDY) {
      if (waited_ms >= kBankDrainTimeoutMs) return false;  // host not draining
      vTaskDelay(pdMS_TO_TICKS(1));
      ++waited_ms;
    }
    const size_t chunk = (n - off < 63) ? (n - off) : 63;
    if (Serial.write(frame + off, chunk) != chunk) return false;
    off += chunk;
  }
  return true;
#else
  // Teensy 4.x USB CDC is buffered and multi-packet safe, and
  // availableForWrite() reports real buffer capacity. Gate each chunk on it
  // with a bounded yield so a wedged host (stopped draining) costs at most
  // ~20 ms before the frame is dropped and counted as TX backlog.
  constexpr uint32_t kBufferDrainTimeoutMs = 20;
  size_t off = 0;
  uint32_t waited_ms = 0;
  while (off < n) {
    const int room = Serial.availableForWrite();
    if (room <= 0) {
      if (waited_ms >= kBufferDrainTimeoutMs) return false;  // host not draining
      vTaskDelay(pdMS_TO_TICKS(1));
      ++waited_ms;
      continue;
    }
    const size_t chunk =
        (n - off < static_cast<size_t>(room)) ? (n - off)
                                              : static_cast<size_t>(room);
    if (Serial.write(frame + off, chunk) != chunk) return false;
    off += chunk;
  }
  return true;
#endif
}

#if defined(HEXAPOD_HIL_OUTPUT_DISABLED)
void refreshHilObserver(uint32_t now_ms,
                        const hil::OutputGuardStatus& guard_status) {
  g_hilObserver.setNow(now_ms);
  g_hilObserver.setLiveState(g_safetyState);
  g_hilObserver.setMaintenanceLock(g_maintApi.token(),
                                    g_maintApi.lockHeld(now_ms));
  g_hilObserver.setOutputGuard(guard_status);
#if defined(HEXAPOD_HIL_OUTPUT_DISABLED)
  g_hilObserver.setTaskRequestCapacity(g_hilTraceRequests.hasSpace());
#endif
  g_hilObserver.tick();
}

void queueHilObserverRequests() {
  // apiTask is the only producer. The observer refuses a new state-changing
  // command when this fixed ring has no space, so every successful take/push
  // pair below is nonblocking and cannot silently lose a request.
  while (g_hilTraceRequests.hasSpace()) {
    hil::CaptureRequest capture;
    if (g_hilObserver.takeCaptureRequest(&capture)) {
      HilTraceRequest request;
      request.type = HilTraceRequestType::Capture;
      request.session_id = capture.session_id;
      request.capture_id = capture.capture_id;
      request.value = capture.step_count;
      if (!g_hilTraceRequests.push(request)) return;
      continue;
    }
    hil::CaptureAbortRequest abort;
    if (g_hilObserver.takeAbortRequest(&abort)) {
      HilTraceRequest request;
      request.type = HilTraceRequestType::Abort;
      request.session_id = abort.session_id;
      request.capture_id = abort.capture_id;
      request.value = static_cast<uint8_t>(abort.reason);
      if (!g_hilTraceRequests.push(request)) return;
      continue;
    }
    hil::MarkerRequest marker;
    if (g_hilObserver.takeMarkerRequest(&marker)) {
      HilTraceRequest request;
      request.type = HilTraceRequestType::Marker;
      request.capture_id = marker.capture_id;
      request.value = marker.marker_id;
      if (!g_hilTraceRequests.push(request)) return;
      continue;
    }
    return;
  }
}

void consumeHilTraceRequests(const hil::OutputGuardStatus& guard_status) {
  HilTraceRequest request;
  while (g_hilTraceRequests.pop(&request)) {
    switch (request.type) {
      case HilTraceRequestType::Capture: {
        hil::CaptureRequest capture;
        capture.session_id = request.session_id;
        capture.capture_id = request.capture_id;
        capture.step_count = static_cast<uint8_t>(request.value);
        // The observer accepted this only after validating its token, state,
        // guard, and bounded request. begin() is a static-memory operation and
        // cannot open an alternate output or authority path.
        (void)g_hilTrace.begin(capture, guard_status, &g_controllerConfig);
        break;
      }
      case HilTraceRequestType::Abort:
        if (g_hilTrace.summary().capture_id == request.capture_id) {
          g_hilTrace.abort(
              static_cast<hil::CaptureEndReason>(request.value), guard_status);
        }
        break;
      case HilTraceRequestType::Marker:
        if (g_hilTrace.active() &&
            g_hilTrace.summary().capture_id == request.capture_id &&
            !g_hilTrace.markNext(request.value)) {
          g_hilTrace.abort(hil::CaptureEndReason::TransportOverflow,
                           guard_status);
        }
        break;
    }
  }
}

bool emitHilTraceRecord(uint32_t now_ms, uint8_t* frame_out,
                        size_t frame_out_cap) {
  hil::trace::RecordView record;
  if (!g_hilTrace.peek(&record)) return true;

  const uint16_t fragment_data_capacity =
      hil::trace::maxFragmentData(protocol::kMaxPayload);
  if (fragment_data_capacity == 0) {
    g_hilTrace.abandonCurrent(hil::CaptureEndReason::TransportOverflow,
                              hil::outputGuard().status());
    return false;
  }
  const uint8_t fragment_count = static_cast<uint8_t>(
      (record.logical_length + fragment_data_capacity - 1u) /
      fragment_data_capacity);
  for (uint8_t fragment_index = 0; fragment_index < fragment_count;
       ++fragment_index) {
    const uint16_t offset = static_cast<uint16_t>(
        static_cast<uint32_t>(fragment_index) * fragment_data_capacity);
    const uint16_t remaining =
        static_cast<uint16_t>(record.logical_length - offset);
    const uint16_t fragment_length =
        remaining < fragment_data_capacity ? remaining : fragment_data_capacity;
    if (!g_hilTrace.copySlice(
            record, offset, &frame_out[hil::trace::kFragmentPrefixBytes],
            static_cast<uint16_t>(protocol::kMaxPayload -
                                  hil::trace::kFragmentPrefixBytes),
            fragment_length)) {
      g_hilTrace.abandonCurrent(hil::CaptureEndReason::TransportOverflow,
                                hil::outputGuard().status());
      return false;
    }

    hil::trace::FragmentHeader fragment;
    fragment.session_id = record.session_id;
    fragment.capture_id = record.capture_id;
    fragment.record_seq = record.record_seq;
    fragment.record_type = record.type;
    fragment.fragment_index = fragment_index;
    fragment.fragment_count = fragment_count;
    fragment.logical_length = record.logical_length;
    fragment.logical_crc16 = record.logical_crc16;
    uint16_t payload_length = 0;
    if (!hil::trace::encodeFragmentSlice(
            fragment, &frame_out[hil::trace::kFragmentPrefixBytes],
            fragment_length, frame_out, protocol::kMaxPayload,
            &payload_length)) {
      g_hilTrace.abandonCurrent(hil::CaptureEndReason::TransportOverflow,
                                hil::outputGuard().status());
      return false;
    }

    protocol::Header header;
    header.msg_type = static_cast<uint8_t>(protocol::MsgType::Event);
    header.msg_id = record.type == hil::trace::RecordType::OutputBlocked
                        ? hil::trace::kOutputBlockedEvent
                        : hil::trace::kTraceFragmentEvent;
    header.flags = protocol::api::flag::kFragment;
    header.seq = g_hilTraceEventSeq++;
    header.timestamp_ms = now_ms;
    header.payload_len = payload_length;
    // encodeFrame first copies payload bytes into a local body, so frame_out
    // can safely serve as both the bounded fragment payload and wire output.
    const size_t frame_length = protocol::encodeFrame(
        header, frame_out, frame_out, frame_out_cap);
    if (frame_length == 0 || !txFrame(frame_out, frame_length)) {
      g_subs.noteTxBacklog();
      g_hilTrace.abandonCurrent(hil::CaptureEndReason::TransportTimeout,
                                hil::outputGuard().status());
      return false;
    }
    g_hilTrace.noteFragmentsSent(1);
  }
  g_hilTrace.acknowledge(record);

  uint32_t session_id = 0;
  uint32_t capture_id = 0;
  hil::CaptureEndReason reason = hil::CaptureEndReason::Complete;
  if (g_hilTrace.takeCompletion(&session_id, &capture_id, &reason)) {
    (void)session_id;
    (void)reason;
    g_hilObserver.noteCaptureFinished(capture_id);
  }
  return true;
}
#endif

// Build the payload for telemetry `stream` into `p` (capacity kMaxPayload).
// Returns the payload length. Reads only the published cross-task snapshots, so
// it never touches a peripheral or blocks. Payloads stay within 256 bytes.
uint16_t buildTelemetry(protocol::StreamId stream, uint8_t* p,
                        uint32_t now_ms) {
  using protocol::StreamId;
  uint16_t o = 0;
  switch (stream) {
    case StreamId::Health: {
      o += put32(&p[o], now_ms);
      p[o++] = g_safetyState;
      p[o++] = g_faultReason;
      o += put32(&p[o], watchdog::missedMask());
      o += put16(&p[o], g_batteryMv);  // snapshot; ADC is controlTask-only
      const hil::OutputGuardStatus guard_status = hil::outputGuard().status();
      p[o++] = packHilFlags(guard_status);
      o += put32(&p[o], guard_status.blocked_power_enable);
      o += put32(&p[o], guard_status.blocked_torque_enable);
      o += put32(&p[o], guard_status.blocked_goal_write);
      o += put32(&p[o], guard_status.blocked_dxl_write);
      o += put32(&p[o], guard_status.last_goal_sequence);
      p[o++] = guard_status.last_goal_count;
      p[o++] = g_lastFaultReason;
      o += put32(&p[o], g_lastFaultTimestampMs);
      break;
    }
    case StreamId::ControlState: {
      p[o++] = g_commandSource;
      p[o++] = g_motionAuthorized ? 1 : 0;
      p[o++] = g_killActive ? 1 : 0;
      p[o++] = g_safetyState;
      p[o++] = g_faultReason;
      p[o++] = g_motionGate ? 1 : 0;
      break;
    }
    case StreamId::ServoStatus: {
      // count(1) then 14 bytes/servo: id, pos(4), vel(2), load(2), volt_mv(2),
      // temp(1), err(1), torque_enable(1). 18 servos -> 253 bytes, within the
      // 256 payload cap. Position is refreshed for all servos every cycle by the
      // all-servo Sync Read; the detail fields (vel/load/volt/temp/torque) are
      // filled by the dxlTask round-robin per-servo read (eax.6), so they are
      // valid once each servo has been polled at least once. Byte layout lives
      // in the portable encoder (lmt.12) so it is host-vector-tested.
      o = protocol::encodeServoStatus(g_servoStatus, g_servoStatusCount, p);
      break;
    }
    case StreamId::ContactState: {
      // 6 feet x 4 bytes: state(1), confidence(1), pressure_delta(2).
      for (uint8_t i = 0; i < sensors::kNumFeet; ++i) {
        const sensors::LegContactState& f = g_footState[i];
        p[o++] = static_cast<uint8_t>(f.state);
        p[o++] = f.confidence;
        o += put16(&p[o], static_cast<uint16_t>(f.pressure_delta));
      }
      break;
    }
    case StreamId::I2cSensorsRaw: {
      // 6 feet x 6 bytes: proximity(2), pressure_raw(4).
      for (uint8_t i = 0; i < sensors::kNumFeet; ++i) {
        const sensors::LegContactState& f = g_footState[i];
        o += put16(&p[o], f.proximity_raw);
        o += put32(&p[o], static_cast<uint32_t>(f.pressure_raw));
      }
      break;
    }
    case StreamId::RcInput: {
      // flags(1): bit0 armed, bit1 kill, bit2 failsafe, bit3 autonomy.
      uint8_t flags = 0;
      if (g_rcStatus.armed) flags |= 0x01;
      if (g_rcStatus.kill) flags |= 0x02;
      if (g_rcStatus.failsafe) flags |= 0x04;
      if (g_rcStatus.autonomy) flags |= 0x08;
      p[o++] = flags;
      p[o++] = g_rcStatus.gait_index;
      for (uint8_t i = 0; i < crsf::kNumChannels; ++i) {
        o += put16(&p[o], g_rcStatus.channels_us[i]);
      }
      break;
    }
    case StreamId::ApiStats: {
      // tx_backlog(4), per-stream dropped(4) x kNumStreams, then USB rx health
      // (hexapod_src-lv6): rx_frames(4) complete frame bodies received,
      // rx_bad(4) COBS/CRC/magic/length decode failures, rx_overflow(4) frames
      // dropped for exceeding the reader buffer. Older hosts that only parse
      // the tx fields ignore the appended tail.
      o += put32(&p[o], g_subs.txBacklog());
      for (uint8_t i = 0; i < protocol::kNumStreams; ++i) {
        o += put32(&p[o], g_subs.dropped(static_cast<StreamId>(i)));
      }
      o += put32(&p[o], g_frameReader.framesOk());
      o += put32(&p[o], g_apiRxBad);
      o += put32(&p[o], g_frameReader.overflowsDropped());
      break;
    }
    case StreamId::JointState: {
      // Mapped present joint angles, ready to render without the host needing
      // the servo map (eax.1). count(1) then 4 bytes/joint: leg(1), joint(1),
      // angle_centideg(int16). Angles come from the active config's servo map
      // (sign/trim/center 2048, 4096 ticks/rev), so they read correctly in both
      // active and passive (torque-off) modes from the present-position snapshot.
      // 18 joints -> 1 + 18*4 = 73 bytes, within the 256 payload cap. Byte
      // layout + tick->angle mapping live in the portable encoder (lmt.12).
      const dxl::ServoMap map(g_configApi.config());
      o = protocol::encodeJointState(map, g_servoStatus, g_servoStatusCount, p);
      break;
    }
    case StreamId::ServoGoals: {
      // Per-joint commanded goal after IK + servo-map clamping (eax.2). Lets the
      // host overlay commanded vs present pose in the animation. count(1) then
      // 5 bytes/joint: leg(1), joint(1), angle_centideg(int16), flags(1). flags
      // bit0 = clamped (goal saturated against configured servo travel).
      // While motion is gated open the live gait/IK goal frame (lmt.2) is the
      // authoritative source; on the bench (motion not gated) the stored
      // maintenance target set is rendered instead. Either way only joints with
      // a real command are emitted, so an idle robot yields a zero count.
      // 18 joints -> 1 + 18*5 = 91 bytes, within the 256 payload cap. The byte
      // layout lives in the portable encoder (lmt.12); this case keeps only the
      // task glue (source selection + the zero-wait goal mutex).
      const dxl::ServoMap map(g_configApi.config());
      bool used_gait = false;
      // Live gait goals take priority while motion is authorised. Copy under a
      // zero-wait lock; if controlTask is mid-publish, fall back to the bench
      // target set for this frame rather than block the telemetry task.
      if (g_motionGate && g_goalValid && g_goalMutex != nullptr &&
          xSemaphoreTake(g_goalMutex, 0) == pdTRUE) {
        o = protocol::encodeServoGoals(map, g_goalFrame.joints,
                                       g_goalFrame.count, p);
        xSemaphoreGive(g_goalMutex);
        used_gait = true;
      }
      if (!used_gait) {
        o = protocol::encodeServoGoals(map, g_maintTargetApi.target(), p);
      }
      break;
    }
    case StreamId::LegState: {
      // Per-leg commanded foot target + IK verdict (eax.3). Lets the animation
      // draw the commanded foot positions and flag unreachable poses. count(1)
      // then 8 bytes/leg: leg(1), foot_x(i16), foot_y(i16), foot_z(i16, mm body
      // frame), flags(1). flags bit0 = reachable, bit1 = clamped (a joint hit
      // its configured travel). Only legs with a recorded SET_LEG_TARGET attempt
      // are emitted, so until a leg target is sent the payload is a zero count.
      // 6 legs -> 1 + 6*8 = 49 bytes, within the 256 payload cap. Byte layout
      // lives in the portable encoder (lmt.12).
      o = protocol::encodeLegState(g_maintTargetApi.target(), p);
      break;
    }
    case StreamId::ControllerState: {
      // Decoded hand-controller intent + raw ChannelPack inputs (oha.4). Mirrors
      // the CONTROLLER_GET_STATE response so a host can watch the live remote
      // (modes, twist, body pose, shape, tricks, arm/estop) and every raw
      // gimbal/pot/encoder/switch/button/nav input. 57-byte fixed layout lives
      // in the portable ControllerApi codec; rcTask publishes g_ctrlCmd/g_ctrlRaw.
      o = protocol::ControllerApi::encodeState(g_ctrlCmd, g_ctrlRaw, p);
      break;
    }
    case StreamId::RcDiagnostics: {
      // Raw CRSF layer for RC troubleshooting (a8n): the raw 11-bit ticks, frame
      // health counters, last-frame age, and decoded LINK_STATISTICS signal
      // quality. Complements the parsed RcInput stream (microsecond channels +
      // decoded arm/kill/gait/autonomy flags) so the host can show both.
      // Layout: flags(1), 16 x raw_tick(u16), frames_decoded(u32),
      // crc_errors(u32), link_stats_count(u32), last_frame_age_ms(u16), then the
      // 10-byte link-stats block = 57 bytes, within the 256 payload cap.
      // flags: bit0 ever_seen, bit1 failsafe, bit2 link_stats_valid.
      uint8_t flags = 0;
      if (g_rcDiag.ever_seen) flags |= 0x01;
      if (g_rcDiag.failsafe) flags |= 0x02;
      if (g_rcDiag.has_link_stats) flags |= 0x04;
      p[o++] = flags;
      for (uint8_t i = 0; i < crsf::kNumChannels; ++i) {
        o += put16(&p[o], g_rcDiag.raw_ticks[i]);
      }
      o += put32(&p[o], g_rcDiag.frames_decoded);
      o += put32(&p[o], g_rcDiag.crc_errors);
      o += put32(&p[o], g_rcDiag.link_stats_count);
      // Elapsed ms since the last valid RC frame, capped at 0xFFFF; 0xFFFF also
      // encodes "never seen" so the host can show a clear dropout indicator.
      uint32_t age = g_rcDiag.ever_seen ? (now_ms - g_rcDiag.last_frame_ms)
                                        : 0xFFFFu;
      if (age > 0xFFFFu) age = 0xFFFFu;
      o += put16(&p[o], static_cast<uint16_t>(age));
      const crsf::LinkStatistics& ls = g_rcDiag.link_stats;
      p[o++] = ls.up_rssi_ant1;
      p[o++] = ls.up_rssi_ant2;
      p[o++] = ls.up_link_quality;
      p[o++] = static_cast<uint8_t>(ls.up_snr);
      p[o++] = ls.active_antenna;
      p[o++] = ls.rf_mode;
      p[o++] = ls.up_tx_power;
      p[o++] = ls.down_rssi;
      p[o++] = ls.down_link_quality;
      p[o++] = static_cast<uint8_t>(ls.down_snr);
      break;
    }
    case StreamId::HilStatus: {
      const hil::OutputGuardStatus guard_status = hil::outputGuard().status();
      hil::GoalTargetRecord goals[hil::kMaxRecordedGoalTargets] = {};
      const uint8_t goal_count = hil::outputGuard().copyLastBlockedGoals(
          goals, hil::kMaxRecordedGoalTargets);
      p[o++] = packHilFlags(guard_status);
      p[o++] = goal_count;
      o += put32(&p[o], guard_status.last_goal_sequence);
      o += put32(&p[o], guard_status.blocked_power_enable);
      o += put32(&p[o], guard_status.blocked_torque_enable);
      o += put32(&p[o], guard_status.blocked_goal_write);
      o += put32(&p[o], guard_status.blocked_dxl_write);
      for (uint8_t i = 0; i < goal_count; ++i) {
        p[o++] = goals[i].id;
        o += put32(&p[o], static_cast<uint32_t>(goals[i].tick));
      }
      break;
    }
        case StreamId::Benchmark: {
      // Build-gated benchmark payload. Layout:
      // enabled(1), board(1: SAMD=1, Teensy=2), cpu_mhz(u16), snapshot_ms(u32),
      // then 12 metrics x [count, mean_us, max_us, max_jitter_us, overruns] u32.
      // Metrics are the six task loops followed by control_step,
      // motion_control_step, motion_dxl_cycle, i2c_oled, i2c_imu, and
      // i2c_storage. The normal image emits only enabled=0 so a host can
      // distinguish an unsupported benchmark build.
    #if defined(HEXAPOD_BENCHMARK)
      p[o++] = 1;
    #if defined(ARDUINO_TEENSY_MICROMOD)
      p[o++] = 2;
      o += put16(&p[o], static_cast<uint16_t>(F_CPU_ACTUAL / 1000000u));
    #elif defined(ARDUINO_ARCH_SAMD)
      p[o++] = 1;
      o += put16(&p[o], static_cast<uint16_t>(F_CPU / 1000000u));
    #else
      p[o++] = 0;
      o += put16(&p[o], 0);
    #endif
      o += put32(&p[o], now_ms);
      benchmark::Snapshot snap;
      taskENTER_CRITICAL();
      snap = benchmark::g_collector.snapshot();
      taskEXIT_CRITICAL();
      const benchmark::Metric* metrics[] = {
          &snap.tasks[0], &snap.tasks[1], &snap.tasks[2],
          &snap.tasks[3], &snap.tasks[4], &snap.tasks[5],
          &snap.control_step, &snap.motion_control_step,
          &snap.motion_dxl_cycle, &snap.i2c_oled, &snap.i2c_imu,
          &snap.i2c_storage,
      };
      for (const benchmark::Metric* metric : metrics) {
        const uint32_t mean_us = metric->count == 0
                 ? 0
                 : metric->total_us / metric->count;
        o += put32(&p[o], metric->count);
        o += put32(&p[o], mean_us);
        o += put32(&p[o], metric->max_us);
        o += put32(&p[o], metric->max_release_jitter_us);
        o += put32(&p[o], metric->overruns);
      }
    #else
      p[o++] = 0;
    #endif
      break;
        }
  }
  return o;
}

// Publish per-feature availability to the FeatureApi and drive the real runtime
// toggles from the host's desired set. Effective enabled = desired && available,
// so a feature whose hardware/state disappears is auto-disabled while the host's
// intent is preserved (AGENTS.md 1.3). Runs each control cycle.
//
// Availability today:
//   * SensorPolling   - available when the I2C mux is present; the one fully
//                        wired runtime toggle (drives g_sensorPollingEnabled).
//   * FootContact     - needs mux + >=1 present foot sensor + polling on; the
//                        gait-engine consumption lands in ubs.5, so it reports
//                        available for streaming but is not yet fed to the gait.
//   * TerrainLeveling - depends on FootContact (ubs.5); reports DependencyOff.
//   * PassivePose     - torque-off pose streaming lands in ubs.6; available
//                        once wired (the passive command group enters the
//                        torque-off PassivePoseStream state).
//   * JetsonControl   - Jetson heartbeat -> arbiter authority is wired
//                        (lmt.13); available, defaults off, gated by RC.
// NOTE: the controlTask-loop helpers below are marked noinline deliberately.
// GCC inlines single-call-site functions, which merged all of their locals
// into controlTask's frame -- ~760 bytes that stayed live during the deep
// ControllerCore::step -> gait/IK descent and overflowed the 448-word stack.
// As real calls, each frame is popped before step() recurses deeper.
//
// Flash-resident default images. Assigning `g_x = X{}` materializes the
// temporary on the caller's stack (628 B RobotState / 320 B ControllerIntent /
// 508 B ControllerConfigSnapshot); copy-assigning from these constants does a
// flash->RAM memberwise copy with no stack temporary.
const controller::RobotState kDefaultRobotState{};
constexpr controller::ControllerIntent kDefaultControllerIntent{};
const controller::ControllerConfigSnapshot kDefaultControllerConfigSnapshot{};

__attribute__((noinline)) void updateFeatureFlags(uint32_t now_ms) {
  using protocol::Feature;
  using protocol::FeatureReason;

  const bool i2c_fresh = g_i2cLastUpdateMs != 0 &&
                         (now_ms - g_i2cLastUpdateMs) <= kI2cStaleMs;
  const bool mux = i2c_fresh && g_i2cTopology.mux_present;
  const bool any_foot = i2c_fresh && g_footPresentMask != 0;

  // SensorPolling: real toggle, available whenever the mux is present.
  g_featureApi.setAvailability(
      Feature::SensorPolling, mux,
      mux ? FeatureReason::None : FeatureReason::HardwareMissing);

  // FootContact: estimator can run when sensors are present and polled.
  const bool polling = g_featureApi.effectiveEnabled(Feature::SensorPolling);
  FeatureReason contact_reason = FeatureReason::None;
  bool contact_avail = true;
  if (!mux || !any_foot) {
    contact_avail = false;
    contact_reason = FeatureReason::HardwareMissing;
  } else if (!polling) {
    contact_avail = false;
    contact_reason = FeatureReason::DependencyOff;
  }
  g_featureApi.setAvailability(Feature::FootContact, contact_avail,
                               contact_reason);

  // TerrainLeveling: needs FootContact active (gait consumption is ubs.5).
  const bool contact_on = g_featureApi.effectiveEnabled(Feature::FootContact);
  g_featureApi.setAvailability(
      Feature::TerrainLeveling, false,
      contact_on ? FeatureReason::NotImplemented : FeatureReason::DependencyOff);

  // PassivePose: torque-off present-position streaming is wired (ubs.6). The
  // passive command group + safety FSM own the actual mode; this just reports
  // the capability as available so GET_CAPABILITIES / feature_state are honest.
  g_featureApi.setAvailability(Feature::PassivePose, true, FeatureReason::None);
  // JetsonControl: the Jetson heartbeat -> arbiter authority path is wired
  // (lmt.13). Report the capability as available so a host can opt in via
  // FEATURE_SET; it defaults off and only becomes effective authority when the
  // RC autonomy switch + RC arm + a fresh Jetson heartbeat all agree.
  g_featureApi.setAvailability(Feature::JetsonControl, true,
                               FeatureReason::None);

  g_featureApi.setLiveState(g_safetyState);

  // Drive the one real toggle: raw foot-sensor polling.
  g_sensorPollingEnabled =
      g_featureApi.effectiveEnabled(Feature::SensorPolling);
}

// --- Task bodies ----------------------------------------------------------
// Each task runs a fixed-period loop with vTaskDelayUntil so timing does not
// drift with body execution time. Bodies are stubs for the skeleton.

// Project the decoded ControllerCommand onto the legacy RcStatus the safety
// FSM / arbiter / rc_input telemetry still consume (oha.3). The bridge is the
// single decoder of truth; this keeps the rest of the safety plumbing working
// without re-plumbing it. channels_us is refreshed (for the rc_input telemetry)
// only on a fresh frame so a dropped link does not zero the last-known sticks.
void deriveRcStatus(const controller::ControllerCommand& cc,
                    const crsf::ChannelData& frame, bool fresh, uint32_t now_ms,
                    crsf::RcStatus& rc) {
  if (fresh) {
    for (uint8_t i = 0; i < crsf::kNumChannels; ++i) {
      rc.channels_us[i] = crsf::ticksToMicros(frame.channels[i]);
    }
    rc.last_frame_ms = now_ms;
  }
  rc.armed = cc.arm_request;       // SW_A (and not failsafe; bridge clears it)  // Kill requires an RC system to have existed: the bridge's failsafe hold
  // synthesises estop when no receiver has ever been seen, which must not
  // assert a kill that locks the arbiter's maintenance lock and the FSM out
  // of Disarmed on an RC-less bench (AGENTS.md mode 4). ever_seen latches, so
  // a link that drops mid-operation still kills.
  rc.kill = cc.estop && cc.ever_seen;
  rc.gait_index = cc.gait_index;   // SW_E 3-pos (wave / ripple / tripod)
  rc.autonomy = cc.host_authority; // SW_H grants host/Jetson authority
  rc.failsafe = cc.failsafe;
  rc.ever_seen = cc.ever_seen;
}

uint8_t fractionToByte(float value) {
  if (value <= 0.0f) return 0;
  if (value >= 1.0f) return 255;
  return static_cast<uint8_t>(value * 255.0f + 0.5f);
}

int16_t scaledI16(float value, float scale) {
  const float scaled = value * scale;
  if (scaled >= 32767.0f) return 32767;
  if (scaled <= -32768.0f) return -32768;
  return static_cast<int16_t>(scaled >= 0.0f ? scaled + 0.5f : scaled - 0.5f);
}

int16_t servoAngleCentideg(const dxl::ServoMap& map, uint8_t leg,
                            uint8_t joint, int32_t tick) {
  if (tick < 0 || tick > config::kServoMaxTick) return 0;
  return scaledI16(map.tickToAngle(leg, joint,
                                   static_cast<uint16_t>(tick)),
                   5729.578f);
}

logging::RemoteCapture buildRemoteCapture(
    const controller::ControllerCommand& command,
    const ChannelPackInputs_t& raw, uint32_t frame_sequence,
    uint32_t now_ms) {
  logging::RemoteCapture capture;
  capture.timestamp_ms = now_ms;
  capture.frame_sequence = frame_sequence;
  for (uint8_t i = 0; i < 4; ++i) capture.gimbal[i] = raw.gimbal[i];
  for (uint8_t i = 0; i < 2; ++i) {
    capture.pot[i] = raw.pot[i];
    capture.encoder[i] = raw.encoder[i];
    capture.toggle[i] = raw.toggles[i];
    for (uint8_t direction = 0; direction < 5; ++direction) {
      if (raw.nav[i][direction]) {
        capture.nav_mask[i] |= static_cast<uint8_t>(1u << direction);
      }
    }
  }
  for (uint8_t i = 0; i < 8; ++i) {
    if (raw.switches[i]) capture.switch_mask |= static_cast<uint8_t>(1u << i);
  }
  for (uint8_t i = 0; i < 4; ++i) {
    if (raw.buttons[i]) capture.button_mask |= static_cast<uint8_t>(1u << i);
  }
  if (command.valid) capture.flags |= 0x01;
  if (command.failsafe) capture.flags |= 0x02;
  if (command.arm_request) capture.flags |= 0x04;
  if (command.estop) capture.flags |= 0x08;
  if (command.host_authority) capture.flags |= 0x10;
  capture.mode = static_cast<uint8_t>(command.mode);
  capture.gait = command.gait_index;
  capture.twist_milli[0] = scaledI16(command.twist_vx, 1000.0f);
  capture.twist_milli[1] = scaledI16(command.twist_vy, 1000.0f);
  capture.twist_milli[2] = scaledI16(command.twist_wz, 1000.0f);
  capture.pose[0] = scaledI16(command.pose_x_mm, 1.0f);
  capture.pose[1] = scaledI16(command.pose_y_mm, 1.0f);
  capture.pose[2] = scaledI16(command.pose_z_mm, 1.0f);
  capture.pose[3] = scaledI16(command.pose_roll, 1000.0f);
  capture.pose[4] = scaledI16(command.pose_pitch, 1000.0f);
  capture.pose[5] = scaledI16(command.pose_yaw, 1000.0f);
  capture.speed_x255 = fractionToByte(command.speed);
  capture.body_height_x255 = fractionToByte(command.body_height);
  capture.stride_x255 = fractionToByte(command.stride);
  capture.step_height_x255 = fractionToByte(command.step_height);
  capture.duty_x255 = fractionToByte(command.duty);
  capture.capture_toggle_seq = command.capture_toggle_seq;
  capture.capture_start_seq = command.capture_start_seq;
  return capture;
}

uint8_t rcGaitForTelemetry(const controller::ControllerCommand& command) {
  // SW_E selects the walking gait in every right-gimbal mode, so translate and
  // rotate no longer force a Stand pose: the operator can walk while moving
  // the body.
  return static_cast<uint8_t>(
      controller::rcGaitFromIndex(command.gait_index));
}

uint8_t batteryPercent(uint16_t millivolts) {
  constexpr uint16_t kEmptyMv = 9900;
  constexpr uint16_t kFullMv = 12600;
  if (millivolts <= kEmptyMv) return 0;
  if (millivolts >= kFullMv) return 100;
  return static_cast<uint8_t>(
      (static_cast<uint32_t>(millivolts - kEmptyMv) * 100u) /
      (kFullMv - kEmptyMv));
}

bool sendCrsfTelemetry(uint8_t type, const uint8_t* payload,
                       uint8_t payload_len) {
#if HEXAPOD_HAS_CRSF_UART
  uint8_t frame[crsf::kMaxFrameLen];
  const uint8_t frame_len = crsf::telemetry::buildFrame(
      type, payload, payload_len, frame, sizeof(frame));
  if (frame_len == 0 || HEXAPOD_CRSF_SERIAL.availableForWrite() < frame_len)
    return false;
  return HEXAPOD_CRSF_SERIAL.write(frame, frame_len) == frame_len;
#else
  (void)type;
  (void)payload;
  (void)payload_len;
  return false;
#endif
}

bool configuredServoCoverageFromBus() {
  if (g_dxlBus.servoCount() < config::kNumServos) return false;
  const config::RobotConfig& cfg = g_configApi.config();
  for (uint8_t i = 0; i < config::kNumServos; ++i) {
    if (g_dxlBus.profileById(cfg.servos[i].id) == nullptr) return false;
  }
  return true;
}

uint32_t configuredPoseMaskFromStatus() {
  uint32_t mask = 0;
  const config::RobotConfig& cfg = g_configApi.config();
  for (uint8_t i = 0; i < config::kNumServos; ++i) {
    for (uint8_t s = 0; s < g_servoStatusCount; ++s) {
      if (g_servoStatus[s].id == cfg.servos[i].id && g_servoStatus[s].ok) {
        mask |= (1u << i);
        break;
      }
    }
  }
  return mask;
}

void publishServoReadiness() {
  g_configuredServoCoverage = configuredServoCoverageFromBus();
  g_poseKnownMask = configuredPoseMaskFromStatus();
  // Publish the revision last. controlTask only consumes the readiness values
  // when this tag matches the active config, so evidence from an old servo map
  // cannot authorize a newly committed map.
  g_servoReadinessConfigRev = g_configApi.revision();
}

bool buildConfiguredHoldTargets(dxl::GoalTarget* hold) {
  if (configuredPoseMaskFromStatus() != kAllServoPosesKnown) {
    return false;
  }
  const config::RobotConfig& cfg = g_configApi.config();
  uint8_t ids[config::kNumServos];
  for (uint8_t i = 0; i < config::kNumServos; ++i) {
    ids[i] = cfg.servos[i].id;
  }
  return dxl::buildHoldTargets(ids, config::kNumServos, g_servoStatus,
                               g_servoStatusCount, hold,
                               config::kNumServos);
}

bool buildDiscoveredHoldTargets(dxl::GoalTarget* hold, uint8_t& count) {
  count = g_dxlBus.servoCount();
  if (count == 0 || count > dxl::DxlBus::kMaxServos) return false;
  uint8_t ids[dxl::DxlBus::kMaxServos];
  for (uint8_t i = 0; i < count; ++i) {
    ids[i] = g_dxlBus.profile(i).id;
  }
  return dxl::buildHoldTargets(ids, count, g_servoStatus,
                               g_servoStatusCount, hold,
                               dxl::DxlBus::kMaxServos);
}

bool refreshDiscoveredPositions() {
  const uint8_t count = g_dxlBus.servoCount();
  if (count == 0) return false;
  for (uint8_t i = 0; i < count; ++i) {
    if (g_dxlBus.syncReadStatus(g_servoStatus, dxl::DxlBus::kMaxServos) != 1) {
      return false;
    }
    cooperativeDxlService();
  }
  g_servoStatusCount = count;
  publishServoReadiness();
  return true;
}

bool verifyDiscoveredTorqueOff() {
  const uint8_t count = g_dxlBus.servoCount();
  for (uint8_t i = 0; i < count; ++i) {
    const dxl::ServoProfile& profile = g_dxlBus.profile(i);
    bool on = true;
    if (!g_dxlBus.torqueState(profile.id, profile.table_kind, on) || on) {
      return false;
    }
  }
  return true;
}

bool verifyDiscoveredTorqueOn() {
#if defined(HEXAPOD_DXL_POWER_ONLY)
  return true;
#else
  const uint8_t count = g_dxlBus.servoCount();
  for (uint8_t i = 0; i < count; ++i) {
    const dxl::ServoProfile& profile = g_dxlBus.profile(i);
    bool on = false;
    if (!g_dxlBus.torqueState(profile.id, profile.table_kind, on) || !on) {
      return false;
    }
  }
  return count == config::kNumServos;
#endif
}

__attribute__((noinline)) bool refreshControllerConfigSnapshot() {
  const uint32_t revision = g_configApi.revision();
  if (g_controllerConfig.valid &&
      revision == g_controllerConfigRevision) {
    return true;
  }

  if (!controller::makeControllerConfigSnapshot(
          g_configApi.config(), revision, !g_configVolatile,
          g_controllerConfig)) {
    g_controllerConfig = kDefaultControllerConfigSnapshot;
    g_controllerConfig.revision = revision;
    g_controllerConfig.persistent = !g_configVolatile;
    return false;
  }
  g_controllerConfigRevision = revision;
  taskENTER_CRITICAL();
  g_pendingRcCalibration = g_controllerConfig.robot.rc_input;
  g_pendingRcCalibrationRevision = revision;
  g_pendingRcCalibrationValid = true;
  taskEXIT_CRITICAL();
  return true;
}

__attribute__((noinline)) void collectControllerState(uint32_t now_ms) {
  controller::RobotState& state = g_controllerState;
  state = kDefaultRobotState;
  state.config_ready = g_configReady;

  if (!g_batterySampled ||
      (now_ms - g_lastBatterySampleMs) >= kBatterySamplePeriodMs) {
    uint16_t battery_mv = 0;
    g_batteryValid = board::readBatteryMilliVolts(battery_mv) &&
                     battery_mv > 6000;
    g_batteryMv = battery_mv;
    g_lastBatterySampleMs = now_ms;
    g_batterySampled = true;
  }
  state.battery.millivolts = g_batteryMv;
  state.battery.valid = g_batteryValid;
  state.battery.validity = state.battery.valid
                               ? controller::SnapshotValidity::Fresh
                               : controller::SnapshotValidity::Unknown;

  uint8_t servo_count = g_servoStatusCount;
  if (servo_count > config::kNumServos) servo_count = config::kNumServos;
  state.dxl.servo_count = servo_count;
  state.dxl.validity = controller::SnapshotValidity::Fresh;
  state.dxl.configured_servo_coverage = g_configuredServoCoverage;
  state.dxl.pose_known_mask = g_poseKnownMask;
  state.dxl.config_revision = g_servoReadinessConfigRev;
  state.dxl.arming_ready = g_dxlArmingReady;
  state.dxl.torque_off = g_dxlTorqueOff;
  state.dxl.hard_fault = g_dxlHardFault;
  for (uint8_t index = 0; index < servo_count; ++index) {
    state.dxl.servos[index] = g_servoStatus[index];
  }

  state.contact.present_mask = g_footPresentMask;
  state.contact.validity = controller::SnapshotValidity::Fresh;
  for (uint8_t leg = 0; leg < sensors::kNumFeet; ++leg) {
    state.contact.feet[leg] = g_footState[leg];
  }
  state.watchdog_fault = watchdog::criticalStalled();
}

__attribute__((noinline)) void collectControllerIntent(bool maintenance_held,
                                                        bool maintenance_recovery,
                                                        bool host_disarm) {
  controller::ControllerIntent& intent = g_controllerIntent;
  intent = kDefaultControllerIntent;
  controller::RcFrameSnapshot latest_rc;
  taskENTER_CRITICAL();
  const bool rc_snapshot_available = g_rcMailbox.copy(latest_rc);
  taskEXIT_CRITICAL();
  if (rc_snapshot_available) {
    g_controlRcSnapshot = latest_rc;
    g_controlRcSnapshotValid = true;
  }
  if (g_controlRcSnapshotValid) {
    const controller::RcFrameSnapshot& rc = g_controlRcSnapshot;
    intent.rc.command = rc.command;
    intent.rc.ever_seen = rc.status.ever_seen;
    intent.rc.kill = rc.status.kill;
    intent.rc.armed = rc.status.armed;
    intent.rc.failsafe = rc.status.failsafe;
    intent.rc.autonomy_enabled = rc.status.autonomy;
  }
  intent.motion = g_motionApi.intent();
  intent.maintenance.lock_held = maintenance_held;
  intent.maintenance.recovery_lock = maintenance_recovery;
  intent.maintenance.lock_token = g_maintApi.token();
  intent.maintenance.control_mode = g_maintTargetApi.controlMode();
  intent.maintenance.targets = g_maintTargetApi.target();
  intent.features.foot_contact_enabled =
      g_featureApi.effectiveEnabled(protocol::Feature::FootContact);
  intent.features.terrain_leveling_enabled =
      g_featureApi.effectiveEnabled(protocol::Feature::TerrainLeveling);
  intent.features.sensor_polling_enabled =
      g_featureApi.effectiveEnabled(protocol::Feature::SensorPolling);
  intent.features.jetson_control_enabled =
      g_featureApi.effectiveEnabled(protocol::Feature::JetsonControl);
  intent.features.passive_pose_enabled =
      g_featureApi.effectiveEnabled(protocol::Feature::PassivePose);
  intent.host_estop = g_controlApi.estopActive();
  intent.host_disarm = host_disarm;
  intent.clear_fault_requested = g_controlApi.consumeClearFault();
  intent.passive_requested = g_passiveApi.requested();
  intent.jetson_heartbeat_received = g_controlApi.consumeJetsonHeartbeat();
}
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
