vitormhenrique/hexapod/firmware/openrb150/variants/OpenRB-150/variant.cpp

/*
  Copyright (c) 2014-2015 Arduino LLC.  All right reserved.

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
  You should have received a copy of the GNU Lesser General Public
  License along with this library; if not, write to the Free Software
  Foundation, Inc., 51 Franklin St, Fifth Floor, Boston, MA  02110-1301  USA
*/

#include "variant.h"

const PinDescription g_APinDescription[] = {

/*
 +------------+------------------+--------+-----------------+--------+-----------------------+---------+---------+--------+--------+----------+----------+
 | Pin number |  MKR  Board pin  |  PIN   | Notes           | Peri.A |     Peripheral B      | Perip.C | Perip.D | Peri.E | Peri.F | Periph.G | Periph.H |
 |            |                  |        |                 |   EIC  | ADC |  AC | PTC | DAC | SERCOMx | SERCOMx |  TCCx  |  TCCx  |    COM   | AC/GLCK  |
 |            |                  |        |                 |(EXTINT)|(AIN)|(AIN)|     |     | (x/PAD) | (x/PAD) | (x/WO) | (x/WO) |          |          |
 +------------+------------------+--------+-----------------+--------+-----+-----+-----+-----+---------+---------+--------+--------+----------+----------+
 | 00         | D0               |  PA22  |                 |  *06   |     |     | X10 |     |   3/00  |   5/00  |* TC4/0 | TCC0/4 |          | GCLK_IO6 |
 | 01         | D1               |  PA23  |                 |  *07   |     |     | X11 |     |   3/01  |   5/01  |* TC4/1 | TCC0/5 | USB/SOF  | GCLK_IO7 |
 | 02         | D2               |  PA10  |                 |   10   | *18 |     | X02 |     |   0/02  |   2/02  |*TCC1/0 | TCC0/2 | I2S/SCK0 | GCLK_IO4 |
 | 03         | D3               |  PA11  |                 |   11   | *19 |     | X03 |     |   0/03  |   2/03  |*TCC1/1 | TCC0/3 | I2S/FS0  | GCLK_IO5 |
 | 04         | D4               |  PB10  |                 |  *10   |     |     |     |     |         |   4/02  |* TC5/0 | TCC0/4 | I2S/MCK1 | GCLK_IO4 |
 | 05         | D5               |  PB11  |                 |  *11   |     |     |     |     |         |   4/03  |* TC5/1 | TCC0/5 | I2S/SCK1 | GCLK_IO5 |
 | 06         | D6               |  PA20  |                 |  *04   |     |     | X08 |     |   5/02  |   3/02  |        |*TCC0/6 | I2S/SCK0 | GCLK_IO4 |
 | 07         | D7               |  PA21  |                 |  *05   |     |     | X09 |     |   5/03  |   3/03  |        |*TCC0/7 | I2S/FS0  | GCLK_IO5 |
 +------------+------------------+--------+-----------------+--------+-----+-----+-----+-----+---------+---------+--------+--------+----------+----------+
 */
  { PORTA, 22, PIO_DIGITAL, (PIN_ATTR_DIGITAL|PIN_ATTR_PWM|PIN_ATTR_TIMER    ), No_ADC_Channel, PWM4_CH0,   TC4_CH0,      EXTERNAL_INT_6    },
  { PORTA, 23, PIO_DIGITAL, (PIN_ATTR_DIGITAL|PIN_ATTR_PWM|PIN_ATTR_TIMER    ), No_ADC_Channel, PWM4_CH1,   TC4_CH1,      EXTERNAL_INT_7    },
  { PORTA, 10, PIO_DIGITAL, (PIN_ATTR_DIGITAL|PIN_ATTR_PWM|PIN_ATTR_TIMER    ), ADC_Channel18,  PWM1_CH0,   TCC1_CH0,     EXTERNAL_INT_NONE },
  { PORTA, 11, PIO_DIGITAL, (PIN_ATTR_DIGITAL|PIN_ATTR_PWM|PIN_ATTR_TIMER    ), ADC_Channel19,  PWM1_CH1,   TCC1_CH1,     EXTERNAL_INT_NONE },
  { PORTB, 10, PIO_DIGITAL, (PIN_ATTR_DIGITAL|PIN_ATTR_PWM|PIN_ATTR_TIMER    ), No_ADC_Channel, PWM5_CH0,   TC5_CH0,      EXTERNAL_INT_10   },
  { PORTB, 11, PIO_DIGITAL, (PIN_ATTR_DIGITAL|PIN_ATTR_PWM|PIN_ATTR_TIMER    ), No_ADC_Channel, PWM5_CH1,   TC5_CH1,      EXTERNAL_INT_11   },
  { PORTA, 20, PIO_DIGITAL, (PIN_ATTR_DIGITAL|PIN_ATTR_PWM|PIN_ATTR_TIMER_ALT), No_ADC_Channel, PWM0_CH6,   TCC0_CH6,     EXTERNAL_INT_4    },
  { PORTA, 21, PIO_DIGITAL, (PIN_ATTR_DIGITAL|PIN_ATTR_PWM|PIN_ATTR_TIMER_ALT), No_ADC_Channel, PWM0_CH7,   TCC0_CH7,     EXTERNAL_INT_5    },
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
