vitormhenrique/hexapod/(commit log)

2026-06-25 Add project documentation and seed initial backlog for hexapod development
    - Create CLAUDE.md for AI agent instructions and task tracking using Beads.
    - Add COMPANION_APP_PLAN.md detailing the companion app's purpose, principles, features, and implementation architecture.
    - Introduce JETSON_AUTONOMY_PLAN.md outlining the Jetson's role in autonomy, software stack, runtime architecture, and development features.
    - Implement seed_beads_backlog.sh to automate the creation of epics and tasks for the hexapod project phases.
2026-06-25 Add OpenRB-150 variant files including linker script, variant.cpp, and variant.h
    - Created linker script for OpenRB-150 to configure memory regions without bootloader.
    - Implemented variant.cpp to define pin descriptions and serial communication for OpenRB-150.
    - Added variant.h to declare board-specific configurations, including pin mappings and peripheral definitions.
2026-06-25 Add OpenRB-150 firmware with FreeRTOS task management and safety features
    - Introduced README.md for OpenRB-150 firmware documentation.
    - Updated platformio.ini to include FreeRTOS dependency.
    - Created task_config.h for centralized RTOS task configuration.
    - Implemented tasks.cpp and tasks.h for managing FreeRTOS tasks: control, dxl, rc, api, i2c, and health.
    - Developed board.cpp and board.h for hardware abstraction layer (HAL) to manage board I/O and safety features.
    - Added openrb150_pins.h for centralized pin mapping.
    - Refactored main.cpp to initialize board and start FreeRTOS scheduler.
    - Implemented watchdog.cpp and watchdog.h for cooperative software watchdog functionality.
2026-06-25 Implement hexapod wire protocol with COBS encoding and CRC-16/CCITT-FALSE
    - Added protocol framing header definition and encoding/decoding functions in C++.
    - Implemented host-side reference protocol in Python, mirroring the firmware implementation.
    - Created tests for CRC-16, COBS encoding/decoding, and full frame encoding/decoding.
    - Generated shared golden test vectors for consistent validation across implementations.
    - Documented protocol format and testing instructions in README and vector generation script.
2026-06-25 feat(api): Implement USB API v0 message layer with command handling
    - Added `api.h` and `api.cpp` for USB API v0 message definitions and handling.
    - Introduced `FrameReader` class for streaming COBS frame reading.
    - Implemented `handleRequest` function to process incoming commands and generate responses.
    - Updated `task_config.h` to increase stack size for API task.
    - Enhanced `tasks.cpp` to include device info initialization and command processing in `apiTask`.
    - Created unit tests for API message handling and frame reading.
    - Added Python API module for building and parsing USB API messages.
    - Updated test vectors to include API message cases for consistency across firmware and host.
2026-06-25 fix(docs): Update servo home position from 90° to 180° in inverse kinematics documentation and GUI
    [joint_gui.py]
2026-06-25 feat(crsf): Implement CRSF parser and RC failsafe status handling with unit tests
    [crsf_parser.cpp, crsf_parser.h, dxl_bus.cpp, tasks.cpp]
2026-06-25 feat(i2c): Implement I2C bus manager and topology with unit tests
2026-06-25 Add EEPROM-based config store and HIL smoke test for OpenRB-150 firmware
    - Implemented a transactional A/B config store using the 24LC32 EEPROM.
    - Added serialization and deserialization functions for config headers.
    - Created a new Eeprom24LC32 driver for I2C communication with the EEPROM.
    - Integrated the config store into the main application, allowing for persistent configuration.
    - Developed a native unit test suite for the config store, covering various scenarios including commit, load, and corruption handling.
    - Introduced a Phase 1 hardware-in-loop (HIL) smoke test script to validate USB API functionality and boot safety invariants.
    - Updated platformio.ini to include new source file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
2026-06-25 Implement persistent robot configuration schema with serialization and validation
    - Added `config_schema.h` and `config_schema.cpp` to define the robot's persistent configuration, including robot identity, leg geometry, servo mapping, gait defaults, and sensor calibration.
    - Implemented serialization and deserialization functions for the `RobotConfig` structure to enable saving and loading from EEPROM.
    - Introduced validation checks to ensure the integrity of the configuration data.
    - Updated `platformio.ini` to include the new source files in the build process.
    - Created unit tests in `test_config_schema.cpp` to validate default configurations, serialization, and deserialization processes,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
2026-06-25 Implement Config API and Servo Map with unit tests
    - Added config_api.h and config_api.cpp to handle CFG_* commands over USB, implementing a RAM shadow and transactional EEPROM commit model.
    - Updated config_schema.cpp to adjust servo ID mapping based on joint and leg configuration.
    - Introduced servo_map.cpp and servo_map.h to convert logical joint angles to DYNAMIXEL ticks, enforcing joint limits.
    - Enhanced protocol API to delegate CFG_* command handling to ConfigApi.
    - Created unit tests for ConfigApi covering summary retrieval, block read/write, validation, and commit functionality.
    - Added tests for ServoMap to validate joint angle to tick conversion and joint limit enforcement.
    - Ensu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
2026-06-25 feat: Add body kinematics and leg inverse kinematics implementations with unit tests
2026-06-25 feat(gait): implement gait engine v1 with unit tests
    - Added gait engine implementation in `gait_engine.cpp` and `gait_engine.h` to generate bounded foot targets for hexapod gaits.
    - Introduced unit tests for the gait engine in `test_gait_engine.cpp` to validate functionality including stance, swing, and duty factors.
    - Updated `platformio.ini` to include the new gait engine source files in the build process.
    - Modified issue tracking to reflect the progress of gait engine development.
    [gait_engine.cpp, gait_engine.h]
2026-06-25 Add support for DYNAMIXEL sync-write and status-read operations
    - Updated platformio.ini to include dxl_sync.cpp for native builds.
    - Enhanced tasks.cpp to publish servo status via sync read.
    - Modified dxl_bus.cpp to implement sync write and read functions for servo positions and statuses.
    - Introduced dxl_sync.h and dxl_sync.cpp for addressing and serialization of DYNAMIXEL commands.
    - Added GoalTarget struct for managing goal positions.
    - Implemented unit tests for sync operations in test_dxl_sync.cpp, covering encoding, decoding, and address resolution for both legacy and V2 protocols.
2026-06-25 Add foot contact estimation and sensor reading functionality
    - Introduced `ContactEstimator` class to manage foot contact states based on sensor readings.
    - Implemented `FingerSensorReader` for interfacing with VCNL4040 and LPS25HB sensors.
    - Updated `tasks.cpp` to include foot contact estimation logic and integrate with existing I2C tasks.
    - Added new source files for `contact_estimator` and `finger_sensor` implementations.
    - Created unit tests for `ContactEstimator` to validate functionality and ensure reliability.
    - Modified `platformio.ini` to include new source files in the build process.
2026-06-25 Implement command-source arbitration and authority management
    - Added CommandArbiter class to manage motion authority between RC, Jetson, and Mac.
    - Introduced safety checks for RC kill, host estop, and Mac maintenance lock.
    - Updated control and DXL tasks to integrate command arbitration logic.
    - Modified CRSF parser to include autonomy switch for Jetson authority.
    - Created unit tests for command arbiter functionality, covering various scenarios.
    - Updated project configuration to include new source files and dependencies.
2026-06-25 Implement telemetry subscription manager and safety state machine
    - Added telemetry.h to define telemetry streams, subscription management, and command handling for telemetry data.
    - Implemented state_machine.cpp and state_machine.h to manage safety states, including transitions based on various inputs and fault conditions.
    - Created unit tests for the safety state machine to validate state transitions and fault handling.
    - Developed unit tests for the telemetry subscription manager to ensure correct subscription behavior, rate limiting, and command handling.
    [api.cpp, api.h, state_machine.cpp, state_machine.h, tasks.cpp, telemetry.cpp, telemetry.h]
2026-06-25 Add README for hexapod-protocol Python implementation
    - Introduced a README.md file detailing the host-side Python implementation of the OpenRB-150 hexapod USB serial protocol.
    - Included sections on contents, wire format, and installation/testing instructions.
    - Documented the structure and functionality of the protocol, including framing, wire primitives, API commands, and telemetry decoders.
2026-06-25 Backlog: firmware control surface (ubs), companion control coverage (kj8), joint-pose/servo telemetry + animation (eax)
2026-06-25 firmware: motion command group (ubs.2)
    SET_GAIT/SET_GAIT_PARAMS/SET_BODY_TWIST/SET_BODY_POSE/STOP_MOTION via
    portable MotionApi (0x34-0x38). Validates+clamps to gait-engine limits,
    stores MotionIntent, echoes live motion gate. Python builders+golden
    vectors. native(191)+protocol(56) tests pass; openrb150 builds.
2026-06-25 firmware: maintenance lock commands (ENTER/EXIT/HEARTBEAT, 0x50-0x52)
    Add portable MaintenanceApi handling the maintenance lock command surface.
    ENTER grants a fresh nonzero token only in a safe live state and reports Busy
    when a valid lock is held; EXIT/HEARTBEAT require a matching token. The handler
    owns the token + TTL (1s default, auto-expiry on missed heartbeat). apiTask
    refreshes now/live-state before dispatch; controlTask folds lockHeld() into the
    safety FSM (maintenance_request / mac_lock_held) and force-revokes on fault or
    E-stop. handleRequest gains a 5th delegate.
    Tests: test_maintenance_api (11), full native suite 202 pass, openrb150 builds.
    Python builders/parser (build_enter/e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
    [api.cpp, api.h, api.py, maintenance_api.cpp, maintenance_api.h, tasks.cpp]
2026-06-25 firmware: maintenance leg/joint targets (SET_LEG_TARGET/SET_JOINT_TARGET, 0x53-0x54)
    Add portable MaintTargetApi for low-authority bench moves. SET_LEG_TARGET
    takes a body-frame foot (leg + x/y/z mm), runs body+leg IK then the servo map
    to clamped goal ticks, and reports reachability + per-joint clamp flags; an
    unreachable solution is reported but not stored so the leg never lunges to a
    saturated boundary. SET_JOINT_TARGET maps one joint angle (centidegrees) to a
    clamped tick. Both are honored only in MacMaintenance with the lock held and
    clamp to the configured servo travel; the resulting MaintTargetSet feeds the
    goal-write path (gated by MacMaintenance authority).
    A 6th api dispatcher del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
2026-06-25 firmware: DXL scan/ping/torque/profile via async dxlTask job queue (0x60-0x64)
    The DYNAMIXEL bus is Arduino-only and owned solely by dxlTask, so the USB API
    (apiTask) cannot drive it directly. Add a portable single-slot SPSC job queue:
    DxlJobApi enqueues a maintenance-gated job, dxlTask claims one job per loop and
    runs it against DxlBus, then writes a serialized result back for the host to
    collect by polling DXL_GET_RESULT with the returned job id.
    Commands: DXL_SCAN, DXL_PING, DXL_TORQUE, DXL_GET_SERVO_PROFILE (submits,
    gated on MacMaintenance + lock) and DXL_GET_RESULT (always allowed so a result
    can still be retrieved after the state changes). The executor reports PowerOff
    when DXL power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
2026-06-25 Add logical parameter access and related API for DYNAMIXEL servos
    - Introduced readRegister, writeRegister, setTorqueOne, and torqueState methods in DxlBus for direct register access.
    - Implemented logical parameter mapping in dxl_params.h and dxl_params.cpp to handle different control tables (legacy and V2).
    - Enhanced DxlJobApi to support new message types for getting and setting logical parameters, including validation and error handling.
    - Added tests for new API functionalities, ensuring correct behavior for parameter retrieval and updates.
    - Updated Python protocol to include new message types and structures for logical parameter operations.
    - Extended test coverage for new functionali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
    [api.py, dxl_bus.cpp, dxl_bus.h, dxl_job_api.cpp, dxl_job_api.h, dxl_params.cpp, dxl_params.h]
2026-06-25 firmware(ubs.4.4): DXL logical parameter get/set + servo limits
    Add DXL_GET_PARAM/SET_PARAM/SET_SERVO_LIMITS on the async job queue:
    - src/dxl/dxl_params.{h,cpp}: table-aware logical->register map (24 params),
    legacy CW/CCW angle limits vs MX(2.0) min/max position limits.
    - DxlBus raw readRegister/writeRegister/setTorqueOne/torqueState (Arduino).
    - Executor disables torque for EEPROM writes, writes, reads back, verifies.
    - Python builders/parsers + golden vectors; native + python tests.
    234 native pass, openrb150 builds, 78 python pass.
2026-06-25 firmware(ubs.4.5): expert-gated DXL raw register read/write
    Add DXL_READ_REGISTER/DXL_WRITE_REGISTER on the async job queue:
    - Raw address/length access bypassing the logical table, gated by an
    expert flag (off by default, reset-cleared; firmware enables only under
    HEXAPOD_ENABLE_DXL_RAW_REGISTER) on top of the maintenance lock gate.
    - Write flags bit0 marks EEPROM region -> executor disables torque first;
    write + read-back verify (BusError/VerifyFailed codes).
    - Python builders/parsers + golden vectors; native tests.
    Completes ubs.4. 238 native pass, openrb150 builds, 82 python pass.
    [api.py, dxl_job_api.cpp, dxl_job_api.h, tasks.cpp, test_dxl_job_api.cpp]
2026-06-26 firmware(ubs.3): feature flag command group (FEATURE_GET/SET/GET_REASONS/RESET)
    Add the runtime feature-flag USB commands (0x39-0x3C) via a new portable
    FeatureApi:
    - Stores the host's desired enable set; the control task publishes per-feature
    availability + reason each cycle. Effective enabled = desired && available,
    so enabling an unavailable feature is Rejected (reason echoed) and a feature
    whose hardware/state disappears auto-disables without losing host intent.
    - Covers foot_contact, terrain_leveling, sensor_polling, jetson_control,
    passive_pose; sensor_polling is the one fully wired toggle (drives
    g_sensorPollingEnabled), others report honest reasons pending ubs.5/ubs.6.
    - Py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
    [api.cpp, api.h, api.py, feature_api.cpp, feature_api.h, tasks.cpp]
2026-06-26 firmware(ubs.5.1): contact/leveling control commands 0x70-0x75
    Add portable SensorApi (CONTACT_ENABLE/DISABLE/SET_THRESHOLDS,
    LEVELING_ENABLE/DISABLE/SET_PARAMS) as the 9th api dispatcher delegate.
    Enable/disable route through FeatureApi.applyDesired so the desired-feature
    set has one source of truth and unavailable features are rejected with the
    reason echoed. Per-foot thresholds are staged and applied by i2cTask via the
    new ContactEstimator::setThresholds (baselines/counters untouched). Leveling
    params are staged (no engine yet).
    Native: 260 pass; openrb150 builds (RAM 74.6%). Python: 100 pass.
2026-06-26 firmware(ubs.5.2): I2C + sensor query/calibration commands 0x76-0x7B
    Complete the sensor command block (0x70-0x7F) in SensorApi with the I2C
    scan / topology / sensor-status / rate / calibrate surface:
    - I2C_SCAN bumps a sequence i2cTask consumes to re-run scanAll (Wire owner).
    - I2C_GET_TOPOLOGY / SENSOR_GET_STATUS encode portable POD snapshots that
    i2cTask republishes (apiTask is a reader only).
    - SENSOR_SET_RATE stages a poll-rate intent (reflected; cadence fixed).
    - CONTACT_CALIBRATE / SENSOR_CALIBRATE stage a per-foot/all baseline-capture
    request applied by i2cTask via the new ContactEstimator::captureBaseline;
    rejected when the snapshot shows no present sensors.
    Native: 273 pass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
    [api.py, contact_estimator.cpp, contact_estimator.h, sensor_api.cpp, sensor_api.h, tasks.cpp, test_contact_estimator.cpp, test_sensor_api.cpp]
2026-06-26 firmware(ubs.6): passive pose streaming commands 0x80-0x83
    New PassiveApi handler (PASSIVE_ENTER/EXIT/SET_STREAM_RATE/ZERO_REFERENCE)
    as the 10th dispatcher delegate. ENTER gated to maintenance-safe states and
    idempotent while streaming; EXIT always clears; rate/zero require active
    passive intent. controlTask folds requested() into the safety FSM with a new
    dxlTask g_dxlTorqueOff publish so PassivePoseStream is only entered torque-off.
    MotionApi rejects gait/twist/pose while passive (STOP_MOTION honoured).
    PassivePose feature now reported available. Python builders/parsers + golden
    vectors. 287 native + 118 py pass; openrb150 builds (Flash 25.9%).
2026-06-26 firmware(eax.1): joint_state telemetry stream (mapped per-joint angles)
    New StreamId::JointState (id 7, appended; kNumStreams 7->8) emits, per joint,
    the leg index, joint role, and present angle in centidegrees derived from the
    active servo map (sign/trim/center 2048, 4096 ticks/rev). Works in active and
    passive torque-off modes off the present-position snapshot; angles are
    URDF-zero-relative so the host renders without the full config. Python
    telemetry.py decode_joint_state + golden vectors and decode tests. 288 native +
    122 py pass; openrb150 builds (Flash 26.1%).
2026-06-26 eax.4: host RobotConfig decoder + servo-map/tick<->angle helpers + golden vectors
2026-06-26 eax.5: companion animated hexapod model (kinematic pose model + pyqtgraph widget + Model Viewer page)
2026-06-26 eax.2: servo_goals telemetry stream (commanded angle + clamp flags)
2026-06-26 eax.6: enrich servo_status payload (torque_enable + round-robin full per-servo read)
2026-06-26 kj8.2: client typed control methods + ConnectionService real ESTOP/arm/disarm wiring
2026-06-26 kj8.4: Mode & Safety Center page (arm/disarm/clear-fault/mode, maintenance+passive locks, feature toggle cards)
2026-06-26 kj8.5: Servo Monitor & DXL Tuning page (live status table + logical param/limits editor + expert raw registers)
2026-06-26 kj8.6+kj8.7: Foot Contact & Leveling and Passive Pose companion pages
    - ProtocolClient: contact thresholds/calibrate, leveling params, sensor
    calibrate/rate, passive zero-reference convenience methods.
    - ConnectionService: sensor-feature/threshold/calibrate + passive result
    signals; passive_enter/exit now emit results.
    - FootContactPage: per-leg contact table, enable/disable with reasons,
    threshold editor, baseline calibration.
    - PassivePosePage: torque-off enter/exit, stream rate, zero reference,
    live joint-angle table.
    - main_window: register both pages (8 total). 10 new Qt tests (51 pass).
2026-06-26 qqi.4: session replay reader + round-trip tests
    Add SessionReplay (data/session_replay.py): manifest access, telemetry/event
    JSONL iterators, lossless raw-frame reader, and iter_decoded_frames that
    re-decodes raw frames through the protocol stack (telemetry frames carry
    stream name + decoded record; corrupt frames skipped). 4 round-trip tests
    exercise the logger+replay path without hardware (companion 55 pass).
2026-06-26 qqi.6+qqi.7+eax.7: theme test, connection-service cycle test, per-servo detail inspector
2026-06-27 step files
    [2472 BNO055 Breakout.step, 4754 BNO085 STEMMA QT.step, 5625 Stemma 5 Port Hub.step, 5626 PCA9548 Stemma.step, Qwiic Mux.step]
2026-06-27 nzi.2: Overview DXL/I2C health badges + self-subscribe; Connect/Overview pages complete
2026-06-29 lmt.1: wire GaitEngine -> body IK -> servo map goal pipeline into controlTask
    Add portable gait::GaitPipeline (gait/gait_pipeline.{h,cpp}) translating
    MotionIntent into concrete per-joint DXL goal ticks. controlTask runs it as a
    producer when the motion gate is open and publishes a mutex-guarded GoalFrame
    for dxlTask (lmt.2) to consume. 6 native tests added; 297 native pass.
2026-06-29 lmt.2: drive writeGoalPositions in dxlTask under the motion gate
    dxlTask enables torque on the authorisation rising edge, Sync-Writes the live
    gait goal frame every cycle while gated (feeding any bus watchdog), and disables
    torque on the falling edge. The goal frame now carries per-joint leg/joint/clamped
    so the servo_goals telemetry reports clamp flags through the real goal-write path
    (audit 22l.3), falling back to the maintenance target set on the bench.
2026-06-29 lmt.3: consume RC gait switch + body-twist sticks in controlTask
    When the arbiter grants motion to CommandSource::Rc, the controlTask gait
    pipeline selects its gait from the 3-position CRSF gait switch (0=Stand for
    safety, 1=Tripod, 2=Ripple) and drives body twist from the pitch/roll/yaw
    sticks via a new portable crsf::stickToUnit (deadband + clamp). Otherwise the
    host MotionApi intent drives; shape params always come from the host intent
    (seeded from config gait defaults). Adds 3 native tests for stickToUnit.
2026-06-29 lmt.4: actuate maintenance targets to DXL goals; seed goal=present before torque-enable
2026-06-29 lmt.6: back g_dxlTorqueOff with real per-servo torque cache (allTorqueOff)
2026-06-29 lmt.5: wire live dxl_hard_fault, arming checks, and contact confidence into safety FSM
2026-06-29 lmt.7: propagate adopted/committed config to runtime consumers
    ConfigApi gains a revision() counter (bumped on reset/adopt/commit, not on
    set_block). controlTask rebuilds the gait pipeline body-IK via new
    GaitPipeline::reconfigure() and i2cTask re-seeds contact calibration, motion
    defaults and FeatureApi (new applyDefaults) from the live config shadow when
    the revision advances. Default feature mask now encodes SensorPolling
    (kFeatureDefaultMask) so adopted configs keep polling on; regenerated golden
    vectors (config crc 23403->37274). 304 native + 167 protocol tests pass.
    [config.py, config_api.cpp, config_api.h, config_schema.cpp, config_schema.h, feature_api.cpp, feature_api.h, gait_pipeline.cpp]
2026-06-29 lmt.8: strengthen validateRobotConfig (feature bits, gait envelope, foot cal)
    [config_schema.cpp, config_schema.h, test_config_schema.cpp]
2026-06-29 lmt.9: complete sensor runtime integration (rate, calibrate-enable, mux-fault)
2026-06-29 lmt.10: chunk syncReadStatus for >DXL_MAX_NODE same-table servos
2026-06-29 lmt.11: persist leg geometry calibration (BodyGeometry config block)
    Move kHomeRadiusMm/kHomeFootZMm (leg_ik.h) and kCoxaLiftMm (body_ik.h) from
    compile-time constants into a persisted config BodyGeometry block so measured
    hardware stance/coxa geometry can override the reference model.
    - config_schema: +BodyGeometry{home_radius_cmm u16, home_foot_z_cmm i16,
    coxa_lift_cmm u16} (0.01mm) after links/before legs; schema v1->v2,
    payload 331->337; defaults 12700/-4455/2100 == old constants (IK unchanged);
    validate rejects home_radius==0.
    - LegIk/BodyKinematics ctors take & use config geometry (constants kept as defaults).
    - protocol/python config.py + golden vectors regen (crc 32283, schema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
2026-06-29 lmt.12: extract host-testable telemetry payload encoders
    The concrete servo_status/joint_state/servo_goals/leg_state payload byte
    layouts lived inline in app/tasks.cpp::buildTelemetry (target-only: reads
    cross-task globals + takes the goal mutex), so the wire layouts could not be
    unit-tested on the host.
    - New portable protocol/telemetry_encode.{h,cpp} with the 4 encoders; built
    natively via the protocol/ glob.
    - Move dxl::ServoStatus POD into Arduino-free dxl/dxl_status.h (dxl_bus.h
    includes it) so encoders compile without Dynamixel2Arduino.
    - buildTelemetry keeps only task glue (goal-mutex + gait-vs-maintenance source
    select) and calls the encoders.
    - New test_telemetry_encode (8 ca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
2026-06-29 lmt.14: reachability-aware stride limiting (reach-margin clamp before IK)
2026-06-29 4sa.1: safety-gated DXL power enable command (kPower=0x6A, maintenance-gated, force-off outside MacMaintenance)
2026-06-29 4sa.2: real SAMD21 hardware WDT (lazy-arm + critical-stall pet withhold) replacing the watchdog stub
    [test_watchdog.cpp, watchdog.cpp, watchdog.h]
2026-06-29 4sa.3: calibratable battery divider (portable host-tested conversion + build-flag overrides + ADC-rail static_assert)
2026-06-29 4sa.7: refresh firmware README layout to current src tree
2026-06-29 feat(oha): controller bridge module + design doc
    Portable table-driven controller bridge (src/input/controller_bridge.{h,cpp})
    decoding the ESP32-S3 CRSF ChannelPack into high-level intent: Walk/Translate/
    Rotate body modes, gait select, pot/encoder shape params, feature/arm/kill
    switches, NAV1 pose trim, 7 rising-edge tricks, link/stale failsafe. Remappable
    BindingConfig. 20 native tests. docs/controller_bridge.md defines the mapping
    and proposed USB CONTROLLER_* API (oha.4). Wiring deferred (oha.3/oha.5).
    [controller_bridge.cpp, controller_bridge.h, test_controller_bridge.cpp]
2026-06-30 feat(oha.3): wire controller bridge into firmware tasks
    rcTask now decodes the ChannelPack CRSF frame via ControllerBridge,
    publishes a ControllerCommand snapshot, and derives the legacy RcStatus
    for the existing safety FSM/arbiter/telemetry. controlTask consumes the
    command: WALK -> gait twist; TRANSLATE/ROTATE-BODY -> body-pose offset
    over planted feet (Stand); NAV1 trim lean; POT/ENC live shape params.
    Adds GaitPipeline::setBodyPose (move core without stepping) + 2 tests.
    Native 371/371, firmware build clean (Flash 29.9%, RAM 78.6%).
2026-06-30 feat(oha.4): USB CONTROLLER_* API + controller_state telemetry stream
    Firmware: controller_api.h/.cpp (ControllerApi encode/decode state+bindings),
    api.cpp delegates msg 0x90-0x9F, tasks.cpp wires g_controllerApi, telemetry.h
    adds ControllerState stream (kNumStreams 11). 8 native tests, native 379/379.
    Protocol: python telemetry decode_controller_state + api controller builders/
    bindings serialize+parse; golden vectors for requests + controller_state.
    288 python tests pass.
    [api.cpp, api.h, api.py, controller_api.cpp, controller_api.h, tasks.cpp, telemetry.h, telemetry.py]
2026-06-30 feat(oha.5): trick/choreography engine wired into controlTask
    gait::TrickEngine plays 9 bounded body-pose/twist programs (stand-up,
    sit-down, wave, crouch-toggle, twirl, stretch, lean-look, dance-loop)
    edge-triggered from the controller bridge TrickId. Output flows through
    the existing gait pipeline + safety gate (no raw servo writes); any stick
    input, maintenance, host-drive, or gate-close cancels the running trick.
    No new wire message (TrickId already on controller_state from oha.4).
    test_trick_engine 11/11; native 390/390; openrb150 build OK.
2026-06-30 feat(lmt.13): wire Jetson heartbeat into arbiter control authority
    Add session-level JETSON_HEARTBEAT (0x05), distinct from generic
    HEARTBEAT so only a real Jetson liveness ping can refresh autonomy
    authority. ControlApi gains noteJetsonHeartbeat/consumeJetsonHeartbeat;
    controlTask stamps CommandArbiter::jetsonHeartbeat only when the
    JetsonControl feature is host-enabled. Authority still requires RC armed
    + RC autonomy switch + fresh heartbeat; RC kill/disarm always wins.
    Feature::JetsonControl now reports available. Adds native + Python
    mirror tests and golden vector. Closes lmt umbrella (all 14 children).
2026-06-30 feat(nzi.4): build Leg Lab companion page
    Add per-leg foot and per-joint maintenance controls (Phase 4 UI).
    ProtocolClient gains set_leg_target/set_joint_target wrappers;
    ConnectionService adds leg_target_result/joint_target_result signals and
    non-blocking worker methods. New LegLabPage (under Tune nav) provides a
    maintenance lock box, leg selector, foot XYZ target showing reachability
    + per-joint clamp masks + servo ticks, per-joint angle target showing
    clamp flags + tick, and a live leg_state table. Controls are firmware
    gated to MacMaintenance with the lock held; rejections surface in result
    labels. Adds 9 headless tests and bumps the main_window page count.
2026-07-01 feat(nzi.5): build Servo Map & Config companion page
    Add the full EEPROM-backed config transfer stack and editor UI:
    - ProtocolClient cfg_get_summary/get_block/set_block/validate/commit/
    reset_defaults plus windowed read_config (ConfigBlockAssembler) and
    write_config (CFG_BLOCK_MAX windows).
    - ConnectionService config_loaded/config_summary/config_staged/
    config_result signals + load/stage/validate/commit/reset workers.
    - ServoConfigPage: summary box (name, schema, persistence), editable
    18-row servo map table, Diff/Stage/Validate/Commit/Export/Import JSON
    actions with range+sign+min<max validation and pending-changes view.
    - Register under Tune nav.
    Tests: 10 page tests + stateful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
    [main_window.py, test_main_window.py, test_servo_config_page.py]
2026-07-01 feat(nzi.7): build Diagnostics developer console page
    Replace the plain telemetry-feed DiagnosticsPage with a real dev console:
    - Protocol stats cards: rx/tx/decode-error counters + api_stats tx backlog
    and total dropped frames.
    - Firmware timing cards: health uptime, watchdog missed, battery.
    - DXL hardware-error table: servos with non-zero hardware_error, decoded
    bit names.
    - I2C foot-sensor summary: per-foot contact state with STALE/FAULT counts.
    - Raw frame inspector with a capture toggle.
    Add bounded raw-frame capture to ProtocolClient (RawFrameRecord +
    DiagnosticsSnapshot, deque(256) under a lock, off by default, captures
    good and decode-error frames) and thin ConnectionService fo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
    [test_core_pages.py, test_diagnostics_page.py]
2026-07-01 feat(nzi.6): build Sensor Dashboard & I2C explorer page
    Add a SensorDashboardPage focused on muxed sensor hardware and topology:
    - Root-bus badges (TCA9548A mux, 24LC32 EEPROM present/missing).
    - Per-mux-channel topology table (scanned, VCNL4040, LPS25HB, device
    count, missing/present/fault) with Refresh and Rescan actions.
    - Live foot-sensor table (ch 0-5: present, state, conf, proximity,
    pressure) from I2C_SENSORS_RAW + CONTACT_STATE streams and a
    SENSOR_GET_STATUS refresh.
    - Poll-rate control (SENSOR_SET_RATE) and re-zero-all-baselines action.
    Wire previously-unwired client methods i2c_scan / i2c_get_topology /
    sensor_get_status; add ConnectionService set_sensor_rate /
    refresh_i2c_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
    [main_window.py, test_main_window.py, test_sensor_dashboard_page.py]
2026-07-01 test(nzi.8): hardware-free UI smoke tests + replay fixtures
    Add replay_fixtures.build_sample_session() which records a real session via
    SessionLogger (raw frames covering 8 telemetry streams) and returns a
    SessionReplay; replay_into_service() feeds decoded frames onto the
    ConnectionService like a live link. test_page_smoke.py parametrizes all 12
    pages: each constructs headless and consumes the full replay session without
    raising, plus a fixture round-trip check. Closes the Phase 4 nzi epic.
    Suite 366 passed.
    [replay_fixtures.py, test_page_smoke.py]
2026-07-01 docs: controller mapping + feat(nxi.1): Plot Workbench page
    docs(firmware): add controller_bridge.md documenting the default
    controller->hexapod mapping (source of truth: defaultBindings() +
    ChannelPack README). Mode-sensitive gimbals (Walk/TranslateBody/
    RotateBody), pots/encoders as shape params, switches for arm/estop/
    features/authority, buttons + NAV clusters for tricks and pose trim,
    plus failsafe behaviour and a full channel table.
    feat(nxi.1): Plot Workbench page (Phase 5). data/plot_signals.py is a
    Qt-free signal registry (~80 signals across servo/leg/control/RC/sensor
    streams) + extract_series() for replay. PlotWorkbenchPage adds a
    grouped, filterable signal picker and a pyqtgraph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
    [main_window.py, test_main_window.py, test_page_smoke.py]
2026-07-01 companion(nxi.3): Qt-free URDF model loader for HexNav description
    - data/urdf_model.py: stdlib-only parser for the flattened HexNav.urdf
    (the same model display.launch.py renders; verified link+joint identical)
    - UrdfModel exposes body root, 6 legs, 18 actuated joints, mesh resolution
    - find_hexnav_description()/load_hexnav() locate the in-repo package
    - tests: test_urdf_model.py (10 tests, 400 passing total)
2026-07-01 Add URDF Forward Kinematics and Viewer Implementation
    - Implemented URDF forward kinematics in `urdf_fk.py` to compute link transforms based on joint states.
    - Enhanced `urdf_model.py` to include origin information for mesh references.
    - Introduced `UrdfViewerPage` in `main_window.py` and `urdf_viewer_page.py` for visualizing URDF models.
    - Created `UrdfGLView` in `urdf_gl_view.py` for rendering 3D URDF meshes using OpenGL.
    - Added tests for URDF forward kinematics and mesh loading in `test_urdf_fk.py` and `test_urdf_mesh_loader.py`.
    - Updated UI to include URDF Viewer in navigation and integrated telemetry handling for live updates.
    - Adjusted font family in the stylesheet for consistency a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
2026-07-01 Add RC diagnostics telemetry and troubleshooting page
    - Implemented rc_diagnostics telemetry stream to provide raw CRSF ticks, frame health counters, and link statistics.
    - Added rc_diagnostics_payload function to generate the telemetry payload.
    - Created RcTroubleshootingPage to display diagnostics information, including link stats and raw ticks.
    - Updated tests to cover new telemetry stream and page functionality.
    - Adjusted existing tests to account for changes in telemetry stream counts and expected outputs.
    - Enhanced CRSF parser to decode LINK_STATISTICS frames and integrate them into the telemetry system.
2026-07-02 Serial link health: rx counters in api_stats + async requests with live reader
    Firmware (hexapod_src-lv6):
    - FrameReader counts complete frame bodies (framesOk) and frames dropped
    for buffer overflow (overflowsDropped) instead of dropping silently.
    - api::handleRequest gains an optional DecodeStatus out-param so apiTask
    counts COBS/CRC/magic/length decode failures (rx_bad).
    - api_stats telemetry appends rx_frames/rx_bad/rx_overflow (u32 x3) after
    the per-stream dropped counters; older hosts ignore the tail.
    Protocol (python):
    - ApiStatsTelemetry/decode_api_stats parse the optional rx-health tail,
    defaulting to zero on firmware without it.
    Companion (hexapod_src-mrd):
    - ProtocolClie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
    [api.cpp, api.h, frame_reader.cpp, frame_reader.h, tasks.cpp, telemetry.py]
2026-07-02 Fix cross-task analogRead race that WDT-reset the MCU on host connects
    Both controlTask and apiTask called analogRead() on the battery pin. The
    stock SAMD21 core busy-waits unbounded on RESRDY and disables the ADC on
    completion, so controlTask preempting apiTask mid-conversion left apiTask
    spinning forever at priority 2, starving healthTask's WDT pet -> hardware
    reset ~2s after servicing a host request. This presented as silent HELLO
    handshakes, mid-session USB detach (errno 6), and reboot loops.
    - firmware: controlTask is the sole analogRead caller and publishes a
    g_batteryMv snapshot; apiTask STATUS + health telemetry read the snapshot
    - companion: SerialLink opens with exclusive=True s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
    [tasks.cpp]
2026-07-02 Fix USB TX frame drop, RC_KILL bench lockout, stale-subscription decode spam (hexapod_src-x9a)
    - apiTask: stock SAMD Serial_::availableForWrite() is a constant 63, so the
    TX gate silently dropped every telemetry frame >63 wire bytes (servo_status
    never reached the host). Replace with txFrame() verified writes; on send
    timeout note backlog and stop emitting this cycle (LastTransmitTimedOut
    keeps subsequent writes fast-fail, so blocking is bounded).
    - rc.kill now requires cc.ever_seen at derivation, and the FSM estop gate
    requires rc_ever_seen: a bench robot with no RC receiver settles in
    Disarmed (mode 4) instead of a permanent RC_KILL estop that also denied
    the arbiter maintena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
    [api.cpp, state_machine.cpp, tasks.cpp]
2026-07-03 HIL: full companion-page hardware test suite (hexapod-hil) + firmware fixes
    Closes hexapod_src-2e8: all 15 companion pages verified against the real
    OpenRB-150 + 18 MX-28AT bench robot via a new 'hexapod-hil' typer CLI
    (companion/src/hil.py); 'hexapod-hil all' passes 15/15.
    Firmware fixes found by HIL:
    - txFrame: chunk USB CDC writes <=63B gated on the BK1RDY endpoint status
    bit; the stock SAMD core send() polls TRCPT1 which its own USB ISR
    clears, tearing >60% of multi-packet telemetry frames and stalling
    apiTask 70 ms per tear (hexapod_src-4et). Now 0 decode errors up to
    50 Hz servo_status.
    - StateMachine: 250 ms battery-low debounce so the 18-servo DXL power-on
    inrush sag no lo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
    [dxl_bus.cpp, dxl_bus.h, hil.py, state_machine.cpp, state_machine.h, task_config.h]
2026-07-03 companion: heartbeat maintenance lock, bench servo controls, arm-model messaging
    - ConnectionService heartbeats the maintenance lock (0.25s, 3-miss tolerance)
    so MAC_MAINTENANCE no longer silently lapses after the 1s firmware TTL;
    lock state is dropped cleanly on disconnect/link loss and surfaced via a
    new maint_lock_changed signal.
    - Global safety bar gains a MAINT LOCK badge visible on every page.
    - Mode & Safety: explains that walking-arm requires the RC arm switch (host
    Arm only releases the host disarm latch), both as a static hint and
    appended to an 'ok but still DISARMED' arm verdict.
    - New bench servo control group (maintenance-gated): DXL power on/off,
    scan IDs 1-30, tor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
    [main_window.py]
2026-07-03 Fix maintenance motion gate + UI telemetry banners and state gating
    Firmware (hexapod_src-0y9): joint targets were accepted in maintenance but
    servos never moved — ENTER_MAINTENANCE only set MaintenanceApi's lock while
    the CommandArbiter mac-lock (which grants motion authority) was never
    requested. controlTask now mirrors the maintenance lock into the arbiter
    (setExternalMacLock); kill/reset clear the mirror. Hardening: maintenance
    targets reset to center on authority entry, auto torque-seed suppressed in
    MacMaintenance, DXL_TORQUE-on seeds goals to present positions first.
    404/404 native tests; HIL-verified servo motion on hardware.
    Companion (hexapod_src-dvr): TelemetryBanner warns on s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
    [command_arbiter.cpp, command_arbiter.h, maintenance_target_api.cpp, maintenance_target_api.h, tasks.cpp]
2026-07-03 fix(firmware): actuate 16+ servo goal frames, bench regression, leg-major map
    Three HIL-verified fixes:
    1. 16+ servo goal frames never actuated (hexapod_src-6c0). controlTask
    (100Hz) and dxlTask shared g_goalFrame via a mutex both took with zero
    wait; at equal priority the writer's hold window phase-locked with the
    reader's poll once the frame grew past ~15 joints, so the reader missed
    the mutex every cycle. dxlTask now blocks briefly (4ms bound) to acquire
    the frame. Verified: all 18 goal-frame counts actuate.
    2. Bench scan/torque/center-all regression (hexapod_src-237). DXL_SCAN
    busy-waited long enough to starve apiTask and lapse the 1s maint-lock
    TTL, cutting power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
    [config.py, config_schema.cpp, maintenance_api.h, tasks.cpp, test_config_schema.cpp, test_gait_pipeline.cpp, test_servo_map.cpp]
2026-07-03 Refactor servo direction handling and add atomic joint target command
    - Introduced a new script `validate_dir.py` for interactive servo direction validation across all hexapod joints.
    - Updated firmware configuration to unify servo sign handling, ensuring all legs use a +1 sign based on hardware validation.
    - Added a new maintenance command `SET_ALL_JOINTS` to allow atomic updates of all joint targets in a single command.
    - Enhanced telemetry and protocol handling to support the new command, including parsing and building functions.
    - Updated tests to cover new functionality and ensure correct behavior of joint target commands and servo mapping.
    - Adjusted existing tests to reflect changes i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
    [api.h, api.py, config.py, config_schema.cpp, hil.py, maintenance_target_api.cpp, maintenance_target_api.h]
2026-07-08 Add TX16S MK3 direct profile support and input profile detection
    - Introduced a new CSV file for the TX16S channel mapping.
    - Implemented functions for normalizing and decoding CRSF values specific to the TX16S MK3 direct profile.
    - Added input profile detection logic to differentiate between custom controller layouts and TX16S MK3 direct frames.
    - Updated the ControllerBridge class to handle the new input profile detection and decoding logic.
    - Enhanced unit tests to cover the new TX16S functionality, including profile locking, gimbal and pot decoding, and safety masks.
    [ROBOT_TX16S_channel_map.csv]
2026-07-09 fix(firmware): harden gait and body pose motion
    [body_ik.cpp, body_ik.h, gait_engine.cpp, gait_engine.h, gait_pipeline.cpp, gait_pipeline.h, leg_ik.cpp, leg_ik.h]
2026-07-09 fix(companion): improve Leg Lab safety guidance
    [main_window.py, test_leg_lab_page.py, test_main_window.py]
2026-07-11 Enhance system diagnostics and safety features
    - Introduced a debounce mechanism for the arm release to prevent accidental disarming.
    - Updated the CRSF parser to reflect changes in serial communication.
    - Captured reset causes and related diagnostics during system initialization.
    - Expanded the status report to include additional reset-related metrics.
    - Implemented a timeout for arming checks to transition to a fault state if checks are not completed in time.
    - Added tests for new arm release logic and arming timeout scenarios.
    - Updated telemetry and protocol definitions to accommodate new status fields.
    - Adjusted default servo trim values for improved performance.
    [api.cpp, api.h, api.py, board.cpp, board.h, cli.py, config.py, config_schema.cpp]
2026-07-11 feat: Implement gait test functionality in ConnectionService
    - Added signals for gait test state and busy status in ConnectionService.
    - Implemented start and stop methods for gait tests, including maintenance lock handling.
    - Introduced properties to track gait test activity and busy status.
    - Enhanced ProtocolClient with a method to set maintenance control mode.
    - Updated GaitLabPage UI to support gait test sessions, including start/stop buttons and parameter inputs.
    - Added tests for gait test session setup and teardown, ensuring proper state management and error handling.
    - Modified firmware to support new maintenance control mode and ensure proper state transitions during gait tests.
    [api.h, api.py, maintenance_target_api.cpp, maintenance_target_api.h, tasks.cpp, test_connection_service.py, test_gait_lab_page.py]
2026-07-15 Refactor RC Troubleshooting Tests and Update Channel Pack for Arm Potentiometer
    - Updated tests for the RC Troubleshooting page to focus on ControllerBridge functionality.
    - Simplified telemetry tests by removing unnecessary diagnostics checks.
    - Introduced new tests for controller state updates and arm switch behavior.
    - Modified ChannelPack to integrate SW_A with Potentiometer 1 in guarded low/high bands.
    - Adjusted packing and unpacking functions to accommodate the new channel assignments.
    - Updated README documentation to reflect changes in channel assignments and functionality.
    - Added unit tests to verify the correct behavior of the arm switch using the guarded pot channel.
    [cli.py, controller_bridge.cpp, test_controller_bridge.cpp]
2026-07-15 Enhance configuration and safety features in firmware
    - Implemented mutation policies in ConfigApi to control staging and applying configurations based on safety conditions.
    - Added error handling for rejected configuration requests when staging or applying is not allowed.
    - Introduced GoalTarget structure for managing servo goal positions in the DXL bus.
    - Created hold_targets module to build hold-position goals and confirm torque-off conditions.
    - Updated state machine logic to enforce arm release requirements after boot and during E-stop conditions.
    - Enhanced tests for configuration API, hold targets, maintenance API, and state machine to cover new functionality and edge cases.
    - Refacto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
    [api.py, config_api.cpp, config_api.h, dxl_bus.h, dxl_sync.h, hold_targets.cpp, hold_targets.h, main_window.py]
2026-07-16 fix(firmware): smooth gait and hold neutral stance
    Park gait phase and hold planted home targets when the motion command is centered. Slew twist inputs using the remote speed setting, ease stance and swing trajectories, and finish each step with a vertical touchdown approach. Add focused gait and pipeline regressions plus operator documentation.
    [gait_engine.cpp, gait_engine.h, test_gait_pipeline.cpp]
2026-07-16 feat: Update default joint trims to zero and enhance goal slew limiter for smoother transitions
2026-07-16 feat(gait): enhance body height control and update tests for reachability and touchdown velocity
2026-07-16 refactor(leg_ik): update stance pose handling to use URDF zero-relative commands and improve related tests
2026-07-17 feat: integrate controller SIL and harden OpenRB startup
    Add shared controller parity and HIL infrastructure, ROS 2 simulation interfaces, companion transport and session tooling, and deployment documentation. Fix the OpenRB control-task stack overflow, retain fatal Cortex context, bound I2C transactions, and expose diagnostics through the shared protocol and CLI.
    [HexNav.urdf.xacro]
2026-07-17 fix(firmware): harden startup and reduce SRAM
    Baseline watchdog evaluation after scheduler startup, remove temporary probe paths, make unused external UART opt-in, and reduce production SRAM to 75% with a checked FreeRTOS heap budget. Preserve fatal diagnostics and HIL behavior while adding targeted regression coverage and SRAM documentation.
    [api.cpp, dxl_bus.h, main.cpp, output_guard.cpp, output_guard.h, task_config.h, tasks.cpp]
2026-07-23 Enhance RC Input Calibration and Validation
    - Introduced logical RC input calibration structure in firmware, including support for multiple channel types (Centered Analog, Unipolar Analog, Relative Encoder).
    - Updated RobotConfig to include rc_input calibration data, with default values and validation rules.
    - Implemented tests for RC input calibration, ensuring proper validation and migration from legacy configurations.
    - Added new tests for controller bridge to validate asymmetric gimbal calibration and input rejection.
    - Improved controller clock tests to handle overrun scenarios and ensure accurate timing.
    - Updated protocol configuration to reflect new schema version and payload size fo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
2026-07-29 Add inverse kinematics and gait control for PhantomX Hexapod
    - Implemented inverse kinematics in nuke.h and nuke.cpp for 6-legged robots.
    - Added gait definitions and control logic in gaits.h and Hexapod_Mark_II_nerf4.ino.
    - Created a new readme.md for project documentation.
    - Introduced servo control for Nerf blasters in Hexapod_Mark_II_nerf4.ino.
    - Established initial leg positions and IK setup in setupIK function.
2026-08-03 feat(protocol): update frames.json with new default payload and CRC values
2026-08-05 Refactor hexapod robot configuration and update servo mappings
    - Updated servo IDs and configurations to reflect the new assembly layout.
    - Adjusted joint angles and limits for improved performance and accuracy.
    - Enhanced the robot's motion profile to align with the latest design specifications.
    - Added unit tests for status LED patterns and telemetry encoding.
    - Migrated legacy configurations to the new schema version, ensuring backward compatibility.
    - Corrected payload structures in the protocol to match updated robot specifications.
    [config.py, config_schema.cpp, config_schema.h, controller_bridge.cpp, controller_bridge.h, dxl_fault_monitor.cpp, dxl_fault_monitor.h, gait_engine.cpp]
2026-08-05 Update hexapod configuration and migration logic for schema version 9
    - Increment schema version to 9 and introduce legacy schema version 8.
    - Modify the decode_robot_config function to handle legacy schema version 8.
    - Update kinematics profile to reflect new CAD measurements for link lengths and geometry.
    - Adjust gait parameters to align with new kinematics.
    - Enhance unit tests to validate migration from legacy schema versions, ensuring servo calibration is preserved.
    - Update test vectors to reflect changes in default payload and schema version.
    - Add detailed walking failure analysis document outlining critical findings and recommendations for firmware improvements.
    [body_command_shaper.h, config.py, config_schema.cpp, config_schema.h, gait_engine.cpp, gait_engine.h, leg_ik.cpp, leg_ik.h]
2026-08-05 fix(dimensions): correct tibia rotation coordinate for leg 6
2026-08-05 feat: Add Joint Matrix maintenance page for servo control
    - Implemented JointMatrixPage and JointMatrixCell classes for managing servo angles and torque release actions.
    - Integrated UI components for maintenance controls, joint targets, and command status.
    - Added functionality to handle torque states and servo commands, including angle and tick modes.
    - Enhanced telemetry handling for live updates of joint states and servo statuses.
    - Created unit tests for JointMatrixPage to ensure correct behavior of UI interactions and servo commands.
    - Updated connection service to manage maintenance state and torque settings effectively.
    - Modified firmware to support maintenance release states for in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
    [main_window.py, tasks.cpp, test_connection_service.py, test_joint_matrix_page.py, test_main_window.py, test_page_smoke.py]
2026-08-06 Enhance telemetry and error handling in hexapod firmware
    - Updated hexapod telemetry encoding to include new status flags and error details.
    - Added unit tests for the error journal to ensure proper handling of error occurrences, suppression of duplicates, and tracking of severity.
    - Introduced a test for minimum body height to validate joint commands during crouch pose.
    - Modified URDF files to change joint types from continuous to revolute and set appropriate limits for leg joints.
    - Adjusted the base footprint position in the URDF to align with the firmware's kinematic model.
    [HexNav.urdf, HexNav.urdf.xacro]
2026-08-07 feat: add new tricks and enhance controller bindings
    - Introduced "Spider attack" and "Jump-kick" tricks to the RC Troubleshooting Page.
    - Updated documentation to reflect new trick functionalities and their descriptions.
    - Modified controller bridge to support new tricks with appropriate bindings.
    - Enhanced the BodyCommandShaper to handle height rate overrides for jump-kick.
    - Updated the TrickEngine to include new keyframes and programs for the added tricks.
    - Adjusted the controller API to accommodate changes in trick count and payload sizes.
    - Added tests to validate new trick behaviors and ensure legacy bindings maintain compatibility.
    [api.py, body_command_shaper.cpp, body_command_shaper.h, controller_api.cpp, controller_api.h, controller_bridge.cpp, controller_bridge.h, controller_core.cpp]
2026-08-08 Add Qwiic Debug OLED support and storage recovery functionality
    - Introduced `qwiic_debug_oled.h` to manage the Qwiic OLED display, including a `DebugDisplayState` structure for holding display data and a `QwiicDebugOled` class for interfacing with the display.
    - Implemented `storage_recovery_main.cpp` to handle storage recovery processes, including checks for I2C bus and OpenLog presence, and logging crash events.
    - Added unit tests for logging capture functionality in `test_capture_log.cpp`.
    - Enhanced configuration API tests in `test_config_api.cpp` to validate bootstrap and commit behaviors with a RAM-backed fake file.
    - Updated `test_config_store.cpp` to reflect changes in the configura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
    [api.py, capture_log.cpp, capture_log.h, config_api.cpp, config_api.h, config_bootstrap.cpp, config_bootstrap.h, config_schema.cpp]
2026-08-11 feat(logging): enhance capture logging with new motion and goal structures
    - Added `AppliedMotionCapture` and `GoalCapture` structures to capture detailed motion and goal data.
    - Updated `capture_log.h` to include new capture formatting functions for applied motion and goal captures.
    - Modified existing capture formatting functions to accommodate new data structures.
    test(probe_crouch): add comprehensive tests for crouch behavior
    - Introduced multiple test files to probe crouch behavior under various conditions.
    - Implemented tests to measure foot lift and commanded body motion during walking at different heights.
    - Added tests to validate the output of the gait pipeline and ensure correct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
    [capture_log.cpp, capture_log.h, controller_bridge.cpp, controller_bridge.h, gait_pipeline.cpp, gait_pipeline.h, probe_crouch_core.cpp, probe_crouch_host.cpp]
2026-08-13 Add servo calibration tests and enhance calibration logic
    - Introduced unit tests for servo sign/trim fitting in `test_servo_calibration_fit.py`.
    - Added headless UI tests for the servo calibration wizard in `test_servo_calibration_page.py`.
    - Updated `test_connection_service.py` to assert maintenance control mode during joint centering.
    - Modified `test_main_window.py` to include the new servo calibration page in the application shell.
    - Enhanced the servo calibration fitting logic in `config.py` to improve accuracy and error handling.
    - Added a regression test for gait straightness in `test_gait_straightness.cpp` to ensure commanded walks are straight.
    [config.py, main_window.py, servo_calibration.py, test_connection_service.py, test_gait_straightness.cpp, test_main_window.py, test_servo_calibration_fit.py, test_servo_calibration_page.py]
2026-08-13 feat(servo_calibration): enhance workflow and UI for leg calibration process
2026-08-14 feat(servo_calibration): enhance maintenance session handling and improve calibration workflow
2026-08-14 Refactor firmware for Teensy MicroMod support and improve FreeRTOS integration
    - Updated platformio.ini to define Teensy MicroMod as the default environment.
    - Introduced rtos.h to abstract FreeRTOS includes based on the target architecture.
    - Modified controller_time_adapter.h to include rtos.h instead of FreeRTOS_SAMD21.h.
    - Enhanced tasks.cpp to conditionally compile code for SAMD and Teensy architectures.
    - Created board_pins.h to centralize pin definitions for both Teensy MicroMod and OpenRB-150.
    - Added micromod_teensy_pins.h for Teensy-specific pin mappings.
    - Updated board.cpp to use board_pins.h and handle ADC differently for Teensy.
    - Adjusted dxl_bus.cpp and dxl_bus.h to support a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
2026-08-14 Add OpenLog configuration tests and enhance status LED functionality
    - Updated `test_main_window.py` to include the new "openlog_config" page in the application shell.
    - Created `test_openlog_config.py` to test the OpenLog CONFIG.TXT journal codec, including parsing, appending records, and error handling for odd-length files.
    - Added `test_openlog_config_file_page.py` for headless testing of the OpenLog CONFIG.TXT editor page, verifying journal loading, editor functionality, and saving.
    - Enhanced the status LED functionality in `status_led.cpp` and `status_led.h` to provide color feedback based on system states and modes.
    - Implemented RGB status LED control in `tasks.cpp` and `board.cpp` f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
2026-08-14 Refactor tests and improve functionality across various pages
    - Updated test cases for main window to reflect changes in workspace structure and navigation.
    - Modified mode safety page tests to accurately reflect feature states and authority cards.
    - Enhanced passive pose page tests to ensure badge states are correctly validated.
    - Improved plot workbench page tests to handle stream subscriptions and releases more effectively.
    - Updated RC troubleshooting page tests to include radio diagnostics and ensure correct subscriptions.
    - Refined sensor dashboard page tests to accurately reflect telemetry data and status updates.
    - Enhanced servo calibration page tests to ensure proper validation and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
2026-08-16 Implement failsafe recovery mechanism for maintenance mode
    - Introduced cooperative DXL service to manage task yielding during servo operations.
    - Enhanced MaintenanceApi to allow recovery from stale CRSF failsafe E-stop under specific conditions.
    - Updated CommandArbiter to handle external mac lock with failsafe recovery logic.
    - Modified StateMachine to support transitions into maintenance mode based on recovery conditions.
    - Added tests for maintenance recovery scenarios and updated existing tests for consistency.
    - Replaced the old OpenRB port finder script with a new board detection script for better environment handling.
2026-08-16 Add benchmark telemetry support and related metrics
    - Introduced a new benchmark.h header file to define the Task enum and Metric structures for tracking task performance metrics.
    - Implemented a Collector class for recording and managing benchmark data, with conditional compilation for builds with HEXAPOD_BENCHMARK defined.
    - Updated FreeRTOS configuration to adjust heap sizes based on build flags.
    - Modified task_config.h to set appropriate stack sizes for different architectures.
    - Enhanced tasks.cpp to record task execution times and metrics, including control steps, DXL cycles, and I2C operations.
    - Added support for a new Benchmark stream in telemetry, allowing for the transmission of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
2026-08-25 feat(qwiic_debug_oled): enhance draw functionality for multiple pages and update I2C clock speed
2026-09-23 Add DXL power-only diagnostic mode and enhance arming sequence verification
    - Introduced a new build environment for DXL power-only diagnostics, allowing normal RC arming and telemetry while disabling torque and goal position commands.
    - Added `g_dxlArmingReady` flag to track the readiness of DXL arming state.
    - Implemented `verifyDiscoveredTorqueOn` and `verifyDiscoveredTorqueOff` functions to validate torque states during the arming process.
    - Updated the DXL task to include checks for torque-off verification, hold-goal seeding, and torque-on verification as part of the arming sequence.
    - Modified the controller contract to include `arming_ready` in the DxlSnapshot structure.
    - Enhanced sa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
2026-09-25 Add tests for joint target torque verification and DXL command handling
    - Implemented `test_all_joint_targets_verify_torque_before_atomic_submit` to ensure torque is verified before setting all joint targets.
    - Added `test_generic_dxl_positions_write_all_goals_before_torque` to confirm that DXL positions are set correctly before enabling torque.
    - Created `test_connect_page_prefers_teensy_over_macos_system_ports` to validate port selection logic in the connection page.
    - Introduced `test_typing_waits_for_explicit_multi_servo_apply` and `test_all_servo_torque_requires_explicit_button_click` in the joint matrix page tests to ensure proper handling of torque and target submissions.
    - Added `tes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
